OmarNeazyI/Sunnypro-automated-egg-frying-machine/docs/README.md

# Document index

The PDFs below preserve the original report pages, tables, diagrams, and printed page numbers. Page ranges refer to the full report's one-based PDF page positions. Unnecessary student identifiers and PDF author metadata have been removed from public copies; technical content and attribution are retained.

| Document | Original report pages | Pages in PDF |
|---|---|---|
| [Project requirements](requirements/SunnyPro_Requirements.pdf) | 27 | 1 |
| [Functional structure and workflow](system-design/SunnyPro_Functional_Structure_and_Workflow.pdf) | 54-66 | 13 |
| [Functional calculations - selected team report pages](calculations/SunnyPro_Functional_Calculations.pdf) | 67-75, 82-86, 111-125 | 29 |
| [Material selection and manufacturing technologies](manufacturing/SunnyPro_Materials_and_Manufacturing.pdf) | 162-206 | 45 |
| [Purchased component requirements](components/SunnyPro_Purchased_Component_Requirements.pdf) | 207-226 | 20 |
| [Final bill of materials](bom/SunnyPro_Final_BOM.pdf) | 241-254 | 14 |
| [Assembly drawing item key](drawings/SunnyPro_Assembly_Drawing_BOM.pdf) | 229-230 | 2 |
| [Team D-FMEA - supporting contribution](risk/SunnyPro_Team_DFMEA.pdf) | 96-108 | 13 |
| [Technical assembly drawing](drawings/SunnyPro_Assembly_Drawing.pdf) | 228 | 1 |
| [Full team report](reports/SunnyPro_Full_Project_Report.pdf) | 1-302 | 302 |

## How to read the documentation

Start with the project requirements and the functional structure. Use the mechanical design notes to follow the component and drive choices, then consult the materials/manufacturing document, final BOM, assembly drawing, and drawing item key.

- [System design notes](system-design.md)
- [Mechanical design and calculation notes](mechanical-design.md)
- [Materials and manufacturing notes](materials-and-manufacturing.md)
- [Design status and limitations](design-status.md)
- [Contributions](contributions.md)

## Ownership and source context

The full report is a team submission. The D-FMEA was primarily my teammates' work, with my contribution. The functional-calculations excerpt includes contextual team calculations, including process preparation assumptions; it is not a claim that I authored every retained calculation.

The assembly drawing is also present on full-report page 228. Its standalone PDF has matching text and page dimensions, with only minor raster differences consistent with compression.

The original functional diagram is sideways in the report. Its page is rotated for reading in the topic excerpt only, without recreating or changing its diagram. The sideways D-FMEA table pages are also rotated in their topic PDF; the full report retains its original page orientations.
