OmarNeazyI/Sunnypro-automated-egg-frying-machine/assets/images/README.md

# Original project images

These are the original, full-resolution SolidWorks screenshots, renamed consistently for linking. Their pixels, proportions, and component details have not been changed. The README controls display size only; selecting an image opens its original resolution.

| Image | Original filename |
|---|---|
| [Complete machine assembly](machine-overview.png) | image(20261110-172844).png |
| [Machine with enclosure panels hidden](machine-internal-layout.png) | image(20261110-172912).png |
| [Conveyor and motor assembly](conveyor-and-drive.png) | image(20261110-172957).png |
| [Eggshell drawer with rails retracted](eggshell-drawer-closed.png) | image(20261110-173113).png |
| [Eggshell drawer with rails extended](eggshell-drawer-open.png) | image(20261110-173149).png |
| [Rotating serving platform](rotating-platform.png) | image(20261110-173321).png |
| [Side view of rotating platform](rotating-platform-side.png) | image(20261110-173352).png |
| [End view of top infrared heater shield](top-ir-shield-end.png) | image(20261110-173451).png |
| [Top infrared heater shield assembly](top-ir-shield.png) | image(20261110-173517).png |
| [Bottom heating block and supporting frame](bottom-heating-assembly.png) | image(20261110-173613).png |
| [Rear display casing and adjustable mounting assembly](display-mount-rear.png) | image(20261110-173726).png |
| [Display casing](display-casing.png) | image(20261110-173754).png |

No image has been generated or substituted. No separate oil-tank screenshot was included.
