OmarNeazyI/Sunnypro-automated-egg-frying-machine/docs/application-summary.md

# Application summary

## CV entry

SunnyPro - automated egg-frying machine | University product-development project

- Developed SolidWorks assemblies for the conveyor, rotating serving platform, heating systems, eggshell drawer, oil tank, and display housing.
- Selected subsystem components, performed functional calculations, chose materials and manufacturing methods, and prepared the final BOM and technical assembly drawings.
- Created the functional structure block diagram and operating-workflow explanation; contributed to heating calculations and the team's D-FMEA.

Design project; no physical prototype was manufactured or tested.

## Short project description

I worked on a university team project to develop an automated sunny-side-up egg-frying machine for breakfast service. My main contribution combined mechanical CAD with component selection, functional calculations, material and manufacturing choices, the final BOM, and technical assembly drawings. I also created the functional structure and full workflow explanation. The project remained at the design stage.
