OmarNeazyI/Sunnypro-automated-egg-frying-machine/assets/images/rotating-platform-side.png

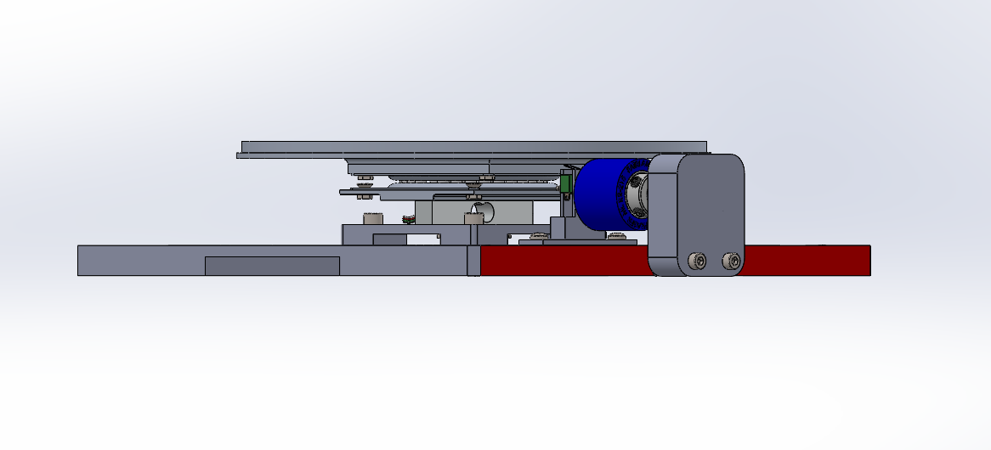
assets/images/rotating-platform-side.png
