OmarNeazyI/Sunnypro-automated-egg-frying-machine/assets/images/top-ir-shield-end.png

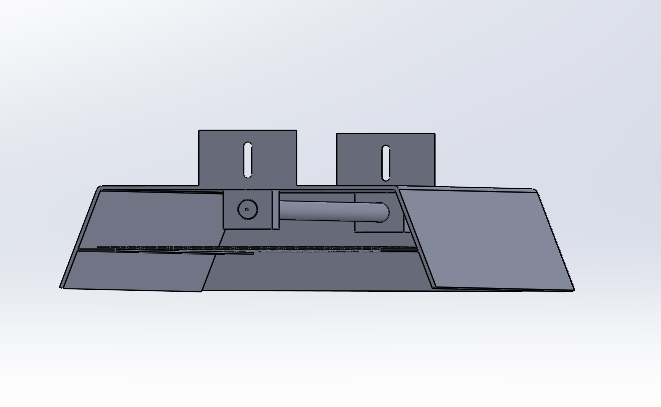
assets/images/top-ir-shield-end.png
