OmarNeazyI/Sunnypro-automated-egg-frying-machine/docs/bom/SunnyPro_Final_BOM.pdf

Group 3 | HSRW Group Project T&B | SS 2026

## 14. Bill of Materials (BOM)

Part NO. | Part Name (Make) | Material specification | Qty. | Technical Specification | Position in Technical assembly
1 | Egg Storage Container | PP-C HI / Polypropylen e Copolymer | 1 | Yield: ~22 MPa | Density: 0.90 g/cm³ | Temp: -20 to 100°C | 1
2 | Egg Tunnel | PP-C HI / Polypropylen e Copolymer | 1 | Yield: ~22 MPa | Density: 0.90 g/cm³ | Temp: -20 to 100°C | 2
3 | Gates for Transportation Tunnel | Acetal Copolymer (POM-C) | 2 | Yield: ~62 MPa | Density: 1.41 g/cm³ | Temp: -40 to 100°C | 4
4 | Gate Shaft Holder for Tunnel | POM-C / Acetal Copolymer | 2 | Yield: ~62 MPa | Density: 1.41 g/cm³ | Temp: -40 to 100°C | 5
5 | Egg Tunnel Shaft | EN 1.4301 / AISI 304 | 2 | Yield: ~215 MPa | Density: 7.90 g/cm³ | Temp: -200 to 400°C | 6
6 | Egg Holding Shaft | EN AW-6082 T6 | 1 | Yield: ~260 MPa | Density: 2.70 g/cm³ | Temp: -40 to 150°C | 7
7 | Egg Holding Arm | EN AW-6082 T6 | 1 | Yield: ~260 MPa | Density: 2.70 g/cm³ | Temp: -40 to 150°C | 8
8 | Base of Spear | EN AW-6082 T6 (clear anodised) | 1 | Yield: ~260 MPa | Density: 2.70 g/cm³ | Temp: -40 to 150°C | 9

9 | Spears (Left and Right) | EN 1.4116 / X50CrMoV15 (hardened) | 2 | Yield: ~800–1000 MPa | Density: 7.70 g/cm³ | Temp: -20 to 200°C | 10
10 | Solenoid Motor Mounting Bracket | EN 1.4301 / AISI 304 | 2 | Yield: ~215 MPa | Density: 7.90 g/cm³ | Temp: -200 to 400°C | 11
11 | Solenoid Motor Casing | EN AW-6082 T6 (clear anodised) | 3 | Yield: ~260 MPa | Density: 2.70 g/cm³ | Temp: -40 to 150°C | 12
12 | Main Drawer Box | EN 1.4301 / X5CrNi18-10 | 1 | Yield: ~215 MPa | Density: 7.90 g/cm³ | Temp: -200 to 400°C | 13
13 | Drawer Front Cover | ABS-HI plastic | 1 | Yield: ~40 MPa | Density: 1.05 g/cm³ | Temp: -20 to 80°C | 14
14 | Drawer Handle | ABS-HI plastic w/ brass inserts | 1 | Yield: ~40 MPa | Density: 1.05 g/cm³ | Temp: -20 to 80°C | 15
15 | Inner Shaft (Drawer) | EN 1.4301 / X5CrNi18-10 | 2 | Yield: ~215 MPa | Density: 7.90 g/cm³ | Temp: -200 to 400°C | 16
16 | Manual Compression Plate | EN 1.4301 / X5CrNi18-10 | 1 | Yield: ~215 MPa | Density: 7.90 g/cm³ | Temp: -200 to 400°C | 17
17 | Oil Storage Mount | EN AW-6082 T6 | 2 | Yield: ~260 MPa | Density: 2.70 g/cm³ | Temp: -40 to 150°C | 18
18 | Pocket Plate | EN 1.4409 / GX2CrNiMo1 9-11-2 (cast) | 4 | Yield: ~185–205 MPa | Density: 7.90 g/cm³ | Temp: -196 to 400°C | 19

19 | Sprocket for Conveyor Belt | EN 1.4404 / X2CrNiMo17-12-2 | 4 | Yield: ~205 MPa | Density: 8.00 g/cm³ | Temp: -196 to 400°C | 20
20 | Driving Shaft / Idler Shaft | EN 1.4404 / X2CrNiMo17-12-2 | 2 | Yield: ~205 MPa | Density: 8.00 g/cm³ | Temp: -196 to 400°C | 21
21 | Conveyor Side Frame | EN 1.4301 / X5CrNi18-10 | 2 | Yield: ~215 MPa | Density: 7.90 g/cm³ | Temp: -200 to 400°C | 22
22 | Conveyor Back Frame | EN 1.4301 / X5CrNi18-10 | 1 | Yield: ~215 MPa | Density: 7.90 g/cm³ | Temp: -200 to 400°C | 23
23 | Conveyor Belt Hollow Support Frame | EN AW-6082 T6 | 1 | Yield: ~260 MPa | Density: 2.70 g/cm³ | Temp: -40 to 150°C | 24
24 | Nema 17/Gearbox/E ncoder Motor Housing | EN AC-43500 / AlSi10MnMg (cast) | 1 | Yield: ~140–180 MPa | Density: 2.68 g/cm³ | Temp: -40 to 150°C | 25
25 | Nema Motor Mount | EN 1.4301 / AISI 304 | 1 | Yield: ~215 MPa | Density: 7.90 g/cm³ | Temp: -200 to 400°C | 26
26 | TOP IR Shielding | EN 1.4301 / X5CrNi18-10 | 1 | Yield: ~215 MPa | Density: 7.90 g/cm³ | Temp: -200 to 400°C (shield, near IR zone) | 27
27 | Ceramic Block for Holding Quartz IR | 96% Al₂O₃ ceramic | 2 | Flexural: ~300 MPa | Density: 3.70 g/cm³ | Temp: up to 1600°C | 28
28 | Side Lining for TOP IR | EN 1.4301 / X5CrNi18-10 | 2 | Yield: ~215 MPa | Density: 7.90 g/cm³ | Temp: -200 to 400°C | 29

29 | Perforated Sheet | EN 1.4301 / X5CrNi18-10 | 1 | Yield: ~215 MPa | Density: 7.90 g/cm³ | Temp: -200 to 400°C | 30
30 | TOP IR Back Frame | EN 1.4301 / X5CrNi18-10 | 1 | Yield: ~215 MPa | Density: 7.90 g/cm³ | Temp: -200 to 400°C | 31
31 | Heating Block | EN AW-6082 T651 | 1 | Yield: ~250 MPa | Density: 2.70 g/cm³ | Temp: -40 to 200°C | 32
32 | Side Frame (Bottom Heating) | EN 1.4301 / X5CrNi18-10 | 2 | Yield: ~215 MPa | Density: 7.90 g/cm³ | Temp: -200 to 400°C | 33
33 | Front Frame (Bottom Heating) | EN 1.4301 / X5CrNi18-10 | 2 | Yield: ~215 MPa | Density: 7.90 g/cm³ | Temp: -200 to 400°C | 34
34 | Bottom Frame (Bottom Heating) | EN 1.4301 / X5CrNi18-10 | 1 | Yield: ~215 MPa | Density: 7.90 g/cm³ | Temp: -200 to 400°C | 35
35 | Mounting Brackets for Bottom Heating Block | EN 1.4301 / AISI 304 | 4 | Yield: ~215 MPa | Density: 7.90 g/cm³ | Temp: -200 to 400°C | 36
36 | Aluminum Plate (Rotating Plate) | EN AW-6061 T6 (clear anodised) | 1 | Yield: ~275 MPa | Density: 2.70 g/cm³ | Temp: -40 to 150°C | 37

37 | Top Load Cell Plate | EN AW-6061 T6 (clear anodised) | 1 | Yield: ~275 MPa | Density: 2.70 g/cm³ | Temp: -40 to 150°C | 38
38 | Bottom Load Cell Plate | EN AW-6082 T6 (clear anodised) | 1 | Yield: ~260 MPa | Density: 2.70 g/cm³ | Temp: -40 to 150°C | 39
39 | Base Plate (Rotating Plate) | EN AW-6082 T6 (clear anodised) | 1 | Yield: ~260 MPa | Density: 2.70 g/cm³ | Temp: -40 to 150°C | 40
40 | Stepper Motor Housing | EN AC-43500 / AlSi10MnMg (cast, clear anodised) | 1 | Yield: ~140–180 MPa | Density: 2.68 g/cm³ | Temp: -40 to 150°C | 41
41 | Bottom Base for Rotating Plate | EN 1.4301 / AISI 304 | 1 | Yield: ~215 MPa | Density: 7.90 g/cm³ | Temp: -200 to 400°C | 42
42 | Electrical Box Housing | EN 1.4301 / AISI 304 | 1 | Yield: ~215 MPa | Density: 7.90 g/cm³ | Temp: -200 to 400°C | 43
43 | Main Frame Housing | EN 1.4301 / AISI 304 | 1 | Yield: ~215 MPa | Density: 7.90 g/cm³ | Temp: -200 to 400°C | 44

44 | L Bracket for Servo Motor | EN 1.4301 / AISI 304 | 4 | Yield: ~215 MPa | Density: 7.90 g/cm³ | Temp: -200 to 400°C | 45
45 | Plastic Back Plate (Display) | ABS-HI plastic w/ brass inserts | 1 | Yield: ~40 MPa | Density: 1.05 g/cm³ | Temp: -20 to 80°C | 46
46 | Front Frame for Casing (Display) | ABS-HI plastic | 1 | Yield: ~40 MPa | Density: 1.05 g/cm³ | Temp: -20 to 80°C | 47
47 | Main Case/Chassy Panels | ABS-HI plastic + purchased glass | 1 | Yield: ~40 MPa | Density: 1.05 g/cm³ | Temp: -20 to 80°C | 48
Part NO. | Part Name (buy) | Material specificatio n | Link/Brand | Technical Specification | Position in Technical assembly
48 | DIN Rail | zinc-plated steel | Hutschiene TS 35 x 7,5mm gelocht - L=326mm (https://www.heima24.de/fussbodenheizung/hutschiene-ts-35-x-75-mm-gelocht-stahl-verzinkt-laenge-326-mm.html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) | 35 x 7,5 x 326 mm | 49
49 | Cable Duct / Wire Raceway | PVC | Cable duct (https://www.reichelt.de/de/de/shop/produkt/verdrahtungskanal_25x25_mm_1000_mm-338223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) | 25x25x1000mm | NA
50 | Cable Glands / Strain Reliefs | Polyamide, V-2. | Kabelverschraubung, M 12 x 1,5, Ø 3,5 - 7 mm, schwarz, IP69K Kabelverschraubung, M 16 x 1,5, Ø 4,5 - 10 mm, schwarz, IP69K (https://www.reichelt.de/de/de/shop/produkt/kabelverschraubung_m_12_x_1_5_3_5_-_7_mm_schwarz_ip69k-158616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) M 20 x 1,5, Ø 7 - 13 mm, schwarz, IP69K (https://www.reichelt.de/de/de/shop/produkt/kabelverschraubung_m_20_x_1_5_7_-_13_mm_schwarz_ip69k-158618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) | M12x1.5 IP69k M16x1.5 IP69k M20x1.5 IP69K | NA
51 | Cable Ties + Mounts | 6/6 nylon | Cable mounts (https://www.digikey.de/de/products/detail/3m/CTB75X75BKA-C/12091625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) Cable ties (https://www.digikey.de/de/products/detail/3m/CT06220/2721199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) | 18.8mm x 18.8mm x 5.6mm | NA

52 | Axle Shaft | Aluminum | Aluminum shaft (https://www.aluminiumexperte.de/alu-rundstab-10-mm.html?gad_source=1&gad_campaignid=23561472869) | Ø 10 mm x100 mm | 50
53 | Return Spring | Stainless steel - AISI 302 | Spring (https://www.sodemann-federn.de/c03000380810s?gad_source=1&gad_campaignid=20972617853) | L0 - 20.57 Mm De - 7.62 | NA
54 | Thermal Insulation | LDPE | Thermal insulation (https://www.planenscout.de/top/schaumstoffe/plastazote-pe-schaumstoff.html?xf_no=34236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) | -70°C to105°C 500x330x20mm | NA
55 | Inner Lining | Aluminum | Aluminum sheet (https://de.aliexpress.com/item/1005007155237666.html) | 0.1x100x100mm | NA
56 | Inline Check Valve | stainless steel | Duotight - 8mm Inline Check Valve (https://ikegger.eu/products/duotight-8mm-inline-check-valve?variant=46884903780646&country=DE&currency=EUR) | Ø8mm | NA
57 | Silicone Tubing | Silicon | Silicon tubing (https://www.puraplants.de/Luftschlauch-4-6mm-durchsichtig-lfm-fuer-Airdome-Sprudelsteine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) | 4mm x 1m | NA
58 | Flat Fan Spray Nozzle | stainless steel | CDIYTOOL 8 Pieces 65 Degree High Pressure Spray Nozzle (https://www.amazon.de/-/en/CDIYTOOL-Pressure-Underbody-Cleaner-Connector/dp/B0C6MNS19L) | 0.4-5L/min 14mm hex width, 25mm long, 12.5 thread width | NA
59 | Nozzle Mounting Bracket | | | | NA
60 | Roller Chain with Bent Attachments | Steel | IWIS - Rollenkette EuroChain (https://www.z24.de/a/41706-iwis-rollenkette-eurochain-06b?ausfuehrung=1&quantity=1) | 9,525 mm 5,72 mm 1505mm 06B-2 | NA
61 | 2-Bolt Flange Bearing Block | Aluminum | Stehlagereinheiten / Flanschlagereinheiten 2- Loch KFL000 (https://www.123kugellager.de/kugellager-gehauselager/gehauselager/stehlagereinheiten-flanschlagereinheiten-2loch/kfl000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) | Ø 10mm | 51
62 | Flexible Clamp Motor Coupling | Aluminum | 10 mm to 12 mm Flexible Shaft Coupling, Diameter 40 mm Length 66 mm Aluminium Motor Connector Flexible (https://www.amazon.de/Flexible-Wellenkupplung-Durchmesser-Aluminium-Motorverbinder/dp/B0DPQ9PPJH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) | bore diameter 10 mm to 12 mm total diameter 40 mm length 66mm | NA

63 | Planetary Gearbox for Motor | -- | Planetengetriebe Schrittmotor 27:1 (https://www.oyostepper.de/goods-293-NEMA-17-Planetengetriebe-Schrittmotor-27-1-Nema17-26Ncm-0067-Grad-168A-12V-Getriebe-Schrittmotor.html) | Planetarygear 27:1 | 52
64 | Front Sealing Strip / Gap Cove r | Silicon | EKI 1515 Silikonschaum (https://www.ekibv.de/moosgummi/silikonschaum/eki1515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) | 2mmx6mmx10m -60 °C bis +220 °C | NA
65 | Thermal Compound | -- | Wärmeleitpaste, Tube, 35gr, ungiftig (https://www.reichelt.de/de/de/shop/produkt/waermeleitpaste_tube_35gr_ungiftig-244621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) | 35g | NA
48 | Stainless Fasteners Kit | A2 stainless steel | M2 M3 M4 M5 Schrauben Set – 1280 Stück (https://www.voelkner.de/index.php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) | M2 M3 M4 M5 | NA

Miscellanous
67 | Countersunk Raised Head Cross Recess Screw | A2 Stainless Steel | Senkkopfschrauben M10x25 (https://agbox.online/Schrauben/Senkkopf/Senkkopfschrauben-DIN-7991/Senkkopfschrauben-M10x25-mit-Innensechskant-DIN-7991-Edelstahl-A2) Senkkopfschrauben M10x60 (https://agbox.online/Schrauben/Senkkopf/Senkkopfschrauben-DIN-7991/Senkkopfschrauben-M10x60-mit-Innensechskant-DIN-7991-Edelstahl-A2) | M10x25 M10x60 | 53
68 | Pan Head Cross | A2 Stainless steel | Linsenschrauben M8x16 (https://alleschrauben.de/Schrauben/Linsenkopf/Linsenschrauben-DIN-7985/Innensechsrund-TX/Linsenschrauben-M8x16-mit-Innensechsrund-TX-T40-DIN-7985-Edelstahl-A2) STM390400300S (https://de.screwerk.com/de/shop/detail/stm/STM390400300S.html) STM320300200E (https://de.screwerk.com/de/shop/detail/stm/STM320300200E.html) | DIN 7985 (ISO 7045) M8x16 M4x30 M3x20 | 54
69 | Recess Screw | A2 stainless steel | Zylinderschraube Innensechskant DIN912 (ISO 4762) V2A - M6x20, 100 St. (https://www.cnc-zubehoer.eu/Zylinderschraube-Innensechskant-DIN912-ISO-4762-V2A-M6x20-100-St./S.912.V2A.M6x20-100) Zylinderschraube Innensechskant DIN912 (ISO 4762) V2A - M3x12, 100 St. (https://www.cnc-zubehoer.eu/Zylinderschraube-Innensechskant-DIN912-ISO-4762-V2A-M3x12-100-St./S.912.V2A.M3x12-100) | M6x20 M3x12 | 55
70 | Socket Head Cap Screw | A2 stainless steel | DIN 912/ISO 4762 A2 – M3 x 25 mm 100 Stück (https://shop.der-schraubenladen.de/DIN-912-ISO-4762-Zylinderschraube-Innensechskant-Edelstahl-A2/SW11250.78) DIN 912/ISO 4762 A2 – M3 x 10 mm 100 Stück (https://shop.der-schraubenladen.de/DIN-912-ISO-4762-Zylinderschraube-Innensechskant-Edelstahl-A2/SW11250.71) | M3x25 M3 x 10 mm | 56

71 | Pan Head Cross Recess Screw | Stainless steel | Flachkopfschraube ISO 7045 PZ M4x8-Z 4.8 galv.verz. 2000St. (https://shop.perfekter-halt.de/Flachkopfschraube-ISO-7045-PZ-M-4-x-8-Z-4-8-galv-verz--2000St---item-REYHER_VL_NW_8000209114) | ISO 7045 M4x8 M4 x 8mm | NA
72 | Prevailing Torque Hex Nut | A2 Stainless steel | Sechskantmuttern M6 DIN 934 Edelstahl A2 (https://alleschrauben.de/Muttern/Sechskantmuttern/Sechskantmuttern-DIN-934/Sechskantmuttern-M6-DIN-934-Edelstahl-A2) | M6 | 57
73 | Plain Washer | A2 Stainless steel | Unterlegscheibe DIN125 (ISO 7089) V2A - 6,4 mm (M6), 1000 Stück (https://www.cnc-zubehoer.eu/Unterlegscheibe-DIN125-ISO-7089-V2A-6-4-mm-M6-1000-Stueck/S.125.A2.M6-1000) | M6 | 58
74 | Socket Set Screw, Cup Point | A2 Stainless Steel | Gewindestift DIN 916 / ISO 4029, M 5x20, Stahl 45 H (https://www.landefeld.de/artikel/de/gewindestift-din-916-iso-4029-m-5x20-stahl-45-h/916-M5X20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..) | M5x20 | 59
75 | Hex Thin Nut | A2 Stainless Steel | DIN 439/ISO 4035 Sechskantmutter Edelstahl A2 – M3 - 100 Stück (https://shop.der-schraubenladen.de/DIN-439-ISO-4035-Sechskantmutter-Edelstahl-A2/SW12301.11) DIN 439/ISO 4035 Sechskantmutter Edelstahl A2 – M4 - 100 Stück (https://shop.der-schraubenladen.de/DIN-439-ISO-4035-Sechskantmutter-Titan-Grade-5/SW12553.1) | M3 M4 | 60
76 | Lazy Susan Bearing | Stainless Steel | Blickle 942239 DK-L-3 Stahlblech-Drehkranz 1 St. (https://www.conrad.de/de/p/blickle-942239-dk-l-3-stahlblech-drehkranz-1-st-3051254.html?insert=ID) | 140 x 110 mm | 61
77 | Rubber Drive Wheel | Polyoxymet hylene | Freies Verschiffen 10PCS 8*32*16 flache typ PA nylon (https://de.aliexpress.com/item/32361362232.html?scm_id=1007.40050.354490.0&scm-url=1007.40050.354490.0) | 8x32x16mm | 62

Electrical Parts

Part No. | Part name | Brand/link | Technical specifications | Location in technical assembly
78 | IEC C20 Power Inlet | IEC 20 Power Inlet (https://de.farnell.com/en-DE/bulgin/px0596-63/inlet-iec-c20-screw-fix/dp/4286030) | 16 A 250 VAC | 63
79 | MCB-Circuit Breaker | 16A MCB- TYPE B Circuit Breaker (https://intratec-shop.de/en/miniature-circuit-breaker-mcb-16a-type-b-3-pole-400v-effective-protection-1-piece/RI53EB16) | 16A TYPE B | NA
80 | RCCB / RCD-TYPE A | RCCB / RCD-TYPE A (30mA) (https://www.tandmore.de/Installation/Hager/FI-LS-Schalter/Hager-CDA540D-2P-10kA-40A-30mA-Typ-A-Fehlerstromschutzschalter::410509.html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) | 30mA TYPE A | NA
81 | DIN Terminal Blocks | DIN Terminal Blocks (L/N/PE) (https://www.tandmore.de/Installation/Phoenix-Contact/Phoenix-Contact-3213755-PT-1-5-S-PE-L-N-Schutzleiter-Reihenklemme::562607.html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) | (L/N/PE) | NA
82 | Protective Earth Terminal Block | Protective Earth Terminal Block (https://www.elektro-wandelt.de/?cl=details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) | - | NA
83 | AC Wire | LAPP 70261141 Strom Anschlusskabel Schwarz 3.00 m (https://www.conrad.de/de/p/lapp-70261141-strom-anschlusskabel-schwarz-3-00-m-626131.html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) | 3.00 m | NA
84 | 24V Industrial SMPS | 24V Industrial SMPS 60W (2.5A at 24V) (https://www.netzgeraet.de/Hutschienennetzteile/DIN-Schiene-24V-DC/1212/24V-2-5A-Netzteil-60W-fuer-Hutschiene-DIN-Rail-HDR.html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) | 60W (2.5A at 24V) | NA
85 | 24V → 12V LM2596T-12 | LM2596T-12/LF03 (https://www.mouser.de/ProductDetail/Texas-Instruments/LM2596T-12-LF03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) | 4.5V to 40V 3A Low | NA
86 | 12V → 5V LM2596T-5 | LM2596T-5.0/LF03 (https://www.mouser.de/ProductDetail/Texas-Instruments/LM2596T-5.0-LF03?qs=X1J7HmVL2ZG6KM98hB9zGA%3D%3D) | 4.5V to 40V 3A Low | NA
87 | 24V → 6V LM2596S-ADJ (Adjusted to 6V) | LM2596S-ADJ/NOPB (https://www.mouser.de/ProductDetail/Texas-Instruments/LM2596S-ADJ-NOPB?qs=X1J7HmVL2ZHoMN0DLDcNog%3D%3D) | 24V DC to 6V DC, 2A continuous | NA
89 | 5V → 3.3V Regulator AMS1117-3.3 | LM1117MPX-3.3/NOPB (https://www.mouser.de/ProductDetail/Texas-Instruments/LM1117MPX-3.3-NOPB?qs=X1J7HmVL2ZHRbBIxXi4utg%3D%3D) | 5 mA 3.3 V -40 to 125 C | NA
90 | DC Terminal Blocks | 9-Way DC Terminal Block 5V 12V 24V for CCTV Power Supply (https://de.aliexpress.com/item/1005003721195254.html?src=bing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) | 5V 12V 24V DC 9-way | NA
91 | Inline Blade Fuse Holders | URAQT Fuse Holder Car Standard 16AWG (https://www.amazon.de/dp/B0FXMT9BYD?aref=hiLIRQMU4S&sp_csd=d2lkZ2V0TmFtZT1zcF9kZXRhaWw) | 16AWG/14AWG/12AWG 30/20/10A | NA

92 | Blade Fuse Assortment | 0287010.PXCN Littelfuse Inc. | Fuses | DigiKey (https://www.digikey.com/en/products/detail/littelfuse-inc/0287010-PXCN/2519807) | 10A 32V | NA
93 | Shielded Signal Cable | 2M UL2547 28AWG 4 Cores PVC (https://de.aliexpress.com/item/32997998517.html?src=bing-language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) | 81–600 V 4-core | NA
94 | Ferrules and Crimp Terminals | 1-966066-1 : Crimp Wire Pins, Tabs & Ferrules | TE Connectivity (https://www.te.com/en/product-1-966066-1.html) | 15 AWG | NA
95 | PCB Screw Terminal Connectors | 20Paar 5.08mm Pitch Male Buchse PCB Screw Terminal Block | eBay.de (https://www.ebay.de/itm/157335503128?campid=5338690632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) | 25 x 10 x 15mm AC 300V 15A | 64
96 | Axial fan 8414NGML | EBM Papst 8414NGML Axiallüfter 24 V/DC 42 m³/h (L x B x H) 80 x 80 x 25mm | » Freue dich auf voelkner (https://www.voelkner.de/index.php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) | 80x80x25mm 42 m³ /h 2pcs 24V DC | 65
97 | Main Microcontroller STM32H743ZITx | STM32H743ZIT6 STMICROELECTRONICS, ARM-MCU, STM32 Family (https://de.farnell.com/stmicroelectronics/stm32h743zit6/mcu-arm-cortex-m7-400mhz-lqfp/dp/2820778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) | STM32 3.6V 550MHz | NA
98 | Gate Actuators JF-0530B x3 | JF-0530B DC12V 300mA 5N/10mm Pull-Push-Type Solenoid Electromagnet (https://www.icstation.com/0530b-dc12v-300ma-5n10mm-pull-push-type-solenoid-electromagnet-p-7404.html) | DC 12V 300mA 5N/10mm 30x16x15mm | 66
99 | Flow Sensors IR sensor | IR Break Beam Sensors- 3mm LEDs : Adafruit Industries (https://www.adafruit.com/product/2167) | 3.3 - 5.5VDC 10mA @ 3.3V, 20mA @ 5V Response Time: <2 ms | NA
100 | Flip Actuator MG996R | MG996R Digital Servo Motor mit Metall Getriebe (https://www.roboter-bausatz.de/p/mg996r-digital-servo-motor-mit-metall-getriebe) | 0.17 sec/60 deg at 4.8 V 4.8 to 7.2 V 40 x 19 x 43 mm | 67
101 | Platform Solenoid JF-0837B | JF-0837B DC 24V 1A 15N 10mm Push Pull Type Open Frame Linear Motion Solenoid Electromagnet | Harfington (https://www.harfington.com/products/p-1109643) | DC 24V 1A 15N 37 x 20 x 26mm | 68

102 | Solenoid Driver multi-channel MOSFET | Industrial-Grade MOSFET Driver Module – 10-100A Adjustable PWM Controller (12-60V DC) (https://de.aliexpress.com/item/1005008688455909.html?src=bing-language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) | 12–60 V DC 10–100 A 12 x 13 x 1 cm | NA
103 | Peristaltic Pump | DC 12V Dosing Pump Peristaltic Pump (https://de.aliexpress.com/item/1005006671106432.html?src=bing-language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) | DC12V 11ml/min Three roller | 69
104 | MOSFET Driver Module | Mosfet Mosfet 12V DC 8×6×2 Low Voltage Mosfet Module (https://www.amazon.de/Niederspannungs-Mosfet-Modul-Steuerung-Hochspannung-Feldeffekttransistormodul-Mosfet-Modul/dp/B0D1GLR547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) | 12V DC 1-5MA | NA
105 | Touchscreen Display Module — Nextion NX8048P070_01 1R | NEXTION 4.3/5.0/7.0'' Intelligent LCD Touch Display (https://de.aliexpress.com/item/1005007260050419.html?src=bing-language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) | 108x181x9.3mm | 70
106 | JST-XH 4-pin Connector | JST JST - Buchsengehäuse, 1x4-polig - XH (https://www.reichelt.de/de/de/shop/produkt/jst_-_buchsengehaeuse_1x4-polig_-_xh-185087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) | 250V / 3A -25 to 80C | NA
107 | Stepper Motor | NEMA 17 (https://www.conrad.de/de/p/joy-it-schrittmotor-nema17-02-nema17-02-0-4-nm-1-68-a-wellen-durchmesser-5-mm-1665583.html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) | 2.8 V 5 mm 2 phase | 71
108 | Stepper Motor Driver | Stepper Motor Driver (https://de.aliexpress.com/item/1005006273853216.html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) | -40 to +85°C 12/24V 18 x 25 x 3 cm | NA
109 | Control Wiring and Connectors | Control Wiring and Connectors (https://de.aliexpress.com/item/1005012316315765.html?src=google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) | 26AWG L-100 mm | NA
110 | Hall Effect Sensor | A1104-class Hall effect switch sensor, 3-pin type (https://www.mouser.de/ProductDetail/Allegro-MicroSystems/A1104LUA-T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) | 3.8 V to 24 V 25 mA -40 to 150 °C | NA
111 | SmCo Magnet | SmCo (https://www.indiamart.com/proddetail/8-x-3-mm-smco-magnet-2858539106433.html) | 8 x 3 mm | NA
110 | Incremental Rotary Encoder | AMT102-V (https://www.digikey.de/de/products/detail/same-sky-formerly-cui-devices/amt102-v/827015) | 3,6V to 5,5V | 72

111 | Cartridge Heaters | Cartridge Heaters (https://www.sensorshop24.de/heizelemente/heizpatronen-8-0-mm/heizpatrone-8mmx160mm-mit-250watt-230v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) | 250W 230V (AC) | 73
112 | Temperature Sensor | PT100 temp. Sensor (https://de.aliexpress.com/item/1005012305522172.html) | - | 74
113 | Temperature Sensor Amplifier | MAX31865AAP+ Analog Devices DigiKey (https://www.digikey.de/de/products/detail/analog-devices-inc-maxim-integrated/MAX31865AAP/5396622) | 3V to 3,6V -40°C to125°C | NA
114 | Solid-state Relay | solid state relay 25A SSR-25AA , ZG3NC-325A Single phase (https://de.aliexpress.com/item/32869114119.html?curPageLogUid=hqPH00OkWdRT) | 25A 90–480VAC | 75
115 | Heater Branch Fuse | 0652C8000-11 Bel Fuse Inc. | Sicherungen | DigiKey (https://www.digikey.de/de/products/detail/bel-fuse-inc/0652C8000-11/25021650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) | 8 A (https://www.digikey.de/de/products/filter/sicherungen/8-a/139) 250 V | NA
116 | High-temperature Wiring | Silikonkabel 18 AWG 0,5 mm² 200°C 300V flexibel verzinnt Meterware | akkuteile.de (https://www.akkuteile.de/zubehoer/kabel-litzen/silikonkabel-18-awg-0-5-mm-200-c-300v-flexibel-verzinnt-meterware_400521_3899) | 18 AWG 200°C 600V | NA
117 | Grounding Hardware | 100m Erdkabel H07V-K 1x4mm² Grün/Gelb bei hd-digital kaufen, (https://www.hb-digital.de/flexible-4mm2-grounding-cable-h07v-k-pvc-single-core-greenyellow-pv-systems-meter) | AC Uo/U 450/750 V > 20 MΩ × km -30 °C to +80 °C | NA
118 | IR Heater Element | IR HEATER (https://yinfrared.en.made-in-china.com/product/IdsGRwybpvkW/China-110V-250-400W-310mm-370mm-410mm-Heating-Element-for-Electric-Oven-Electric-Heat-Tube-with-Me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) | 410 mm 250W 110V to 450V | 76
119 | IR Power Control / Relay | SSR Halbleiter Solid State Relais DC / AC, 230V AC 25 A (https://www.pohltechnik.com/de/ssr-relais/ssr-lastschaltung-230v/ssr-halbleiter-solid-state-relais-dc-ac-230v-ac-25-a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) | DC to AC 230V AC 25A | NA
120 | Thermal Cutoff / Safety Sensor | THERMODISC Temperatursicherung, 16A, 184°C, kurz/lang | Temperatursicherungen günstig kaufen | reichelt elektronik (https://www.reichelt.de/de/de/shop/produkt/temperatursicherung_16a_184_c_kurz_lang-279146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) | 16A Max 184°C | NA
121 | PT100 Sensor | PT100 temp. Sensor (https://de.aliexpress.com/item/1005012305522172.html) | - | 77
122 | SSR Heat Sink | Aluminium Heat Sink SSR (https://www.amazon.de/-/en/Aluminium-Dissipation-Thermostat-Temperature-Controller/dp/B0DX2CCWC7?s=industrial) | Aluminium | 78

| | Dissipation For One Phase Solid State Relay 10a-40a For PID Thermostat Temperature Controller (https://www.amazon.de/-/en/Aluminium-Dissipation-Thermostat-Temperature-Controller/dp/B0DX2CCWC7?s=industrial) | Fit for: 10a-40a
123 | Ceramic Terminal Block | Elektrofachmarkt-online -Keramikklemme 2-polig mit Befestigungsloch (https://www.elektrofachmarkt-online.de/kabel-u-zubehoer/verbindungsklemmen/luesterklemmen/keramikklemme-2-polig-mit-befestigungsloch.html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) | Ceramic clamp 2-pole max. 300°C , 450V, 32A | NA
124 | Low-voltage Terminal Blocks | Phoenix Contact 1725672 MPT 0,5/ 4-2,54 Leiterpla (https://www.tandmore.de/Installation/Phoenix-Contact/Phoenix-Contact-1725672-MPT-0-5-4-2-54-Leiterplatten-Anschlussklemme::577079.html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) | 160 V Max 105 °C 4 cores | NA
125 | Stepper Motor | FREI Standard-Schrittmotor, 5V (https://www.reichelt.de/de/de/shop/produkt/standard-schrittmotor_5_v-282442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) | 5V DC 4 Phase 34.3mN.m | NA
126 | Stepper Driver Module | FREI Entwicklerboards -Motorsteuerung, ULN2003A (https://www.reichelt.de/de/de/shop/produkt/entwicklerboards_-_motorsteuerung_uln2003a-282649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) | DC5V-12V 4-phase 5 line | NA
127 | Microswitch | 5Pcs Mini Micro Limit Switch NO NC 3 Pins PCB Terminals SPDT 5A 125V 250V 29mm Roller Arc lever Snap Action Push Microswitches (https://de.aliexpress.com/item/1926553469.html?src=bing-language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) | 5A 125V/250V | NA
128 | Load Cell and HX711 Amplifier Module | Stemedu 5 kg Load Cell Digital Weight Sensor for Portable Electronic with HX711 Ad Amplifier Module, 11 lbs Weighing Sensor Arduino Raspberry Pi (https://www.amazon.de/dp/B07L81BQB6/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) | Four lines 5-10 V Dimensions: 12.7 mm, 12.7 mm, 80 mm. voltage range: 2.6-5.5 V | NA

129

130 | Wiring and Connectors | DKS-20MM-30 DigiKey Standard | Jumper Wire | DigiKey (https://www.digikey.com/en/products/detail/digikey-standard/DKS-20MM-30/17038779) PVC Datenleitung LAPP UNITRONIC LiYY 3x0,25 - 0028303 | Automation24 (https://www.automation24.de/pvc-datenleitung-lapp-unitronic-liyy-3x0-25-0028303-meterware-0-25-3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) | - NA
131 | Emergency stop button | 1NC 22mm Red Mushroom Emergency Stop Push Button Switch 600V 10A (https://de.aliexpress.com/item/1005006921918648.html?src=bing-language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) | 22mm 600V 10A | NA
