OmarNeazyI/Sunnypro-automated-egg-frying-machine/cad/native/Breaking Hand Assembly.SLDASM

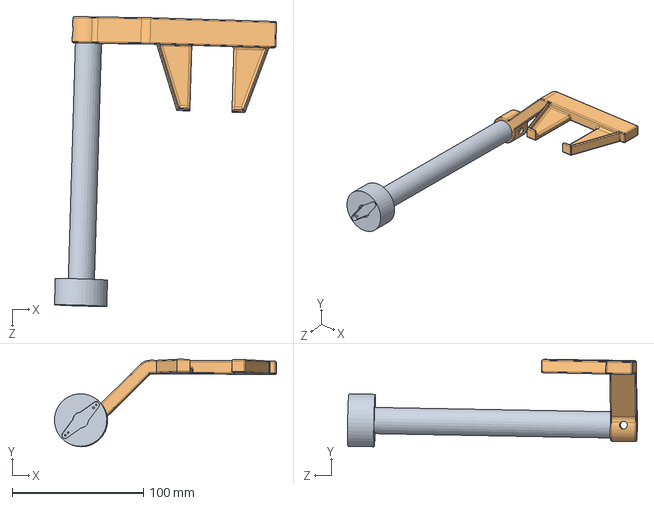
[picture p136: CAD file, 2026-11-10]
cad/native/Breaking Hand Assembly.SLDASM
169.2 x 66.7 x 221.0 mm
Breaking Mech Hand
Shaft for Hand
