OmarNeazyI/Sunnypro-automated-egg-frying-machine/cad/native/TOP IR Parts Assembly.SLDASM

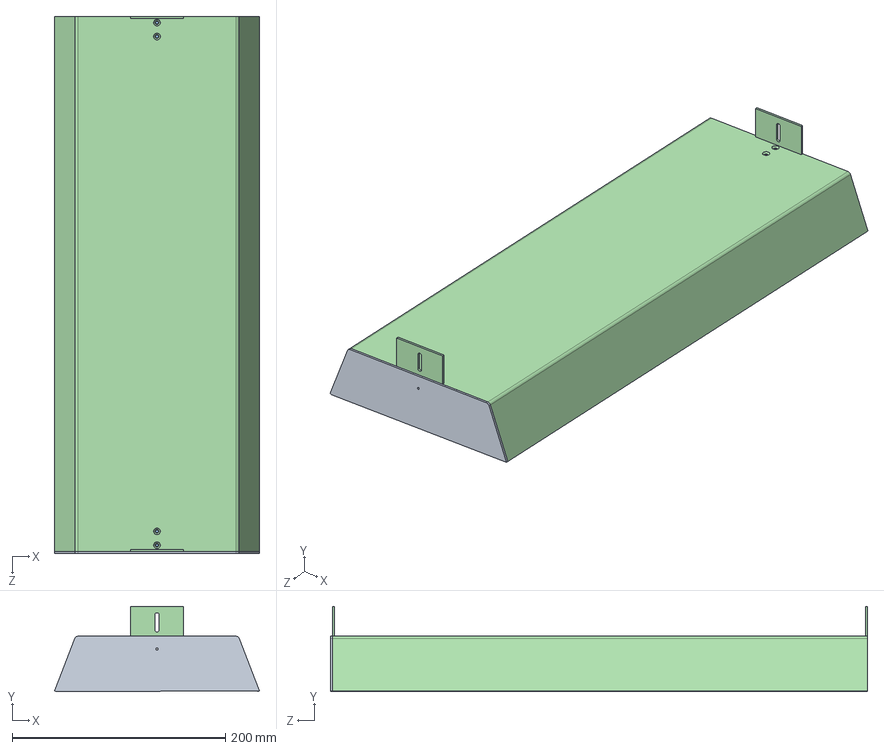
[picture p137: CAD file, 2026-11-10]
cad/native/TOP IR Parts Assembly.SLDASM
192.2 x 80.0 x 504.0 mm
TOP IR shielding
Ceramic block x 2
Lining for mesh x 2
Back of shielding
