OmarNeazyI/Sunnypro-automated-egg-frying-machine/cad/native/Main Base Plate.SLDPRT

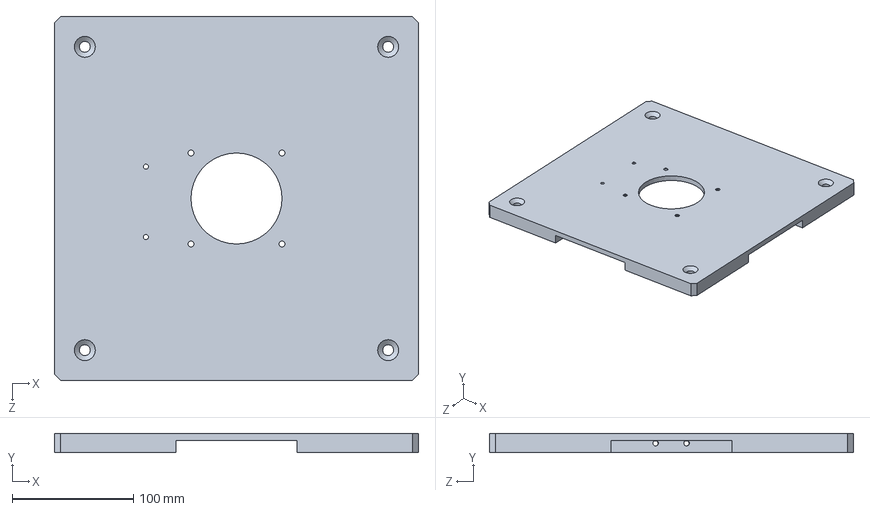
[picture p138: CAD file, 2026-11-10]
cad/native/Main Base Plate.SLDPRT
300.0 x 16.0 x 300.0 mm
