OmarNeazyI/Sunnypro-automated-egg-frying-machine/cad/native/Chain linkwithpins.SLDASM

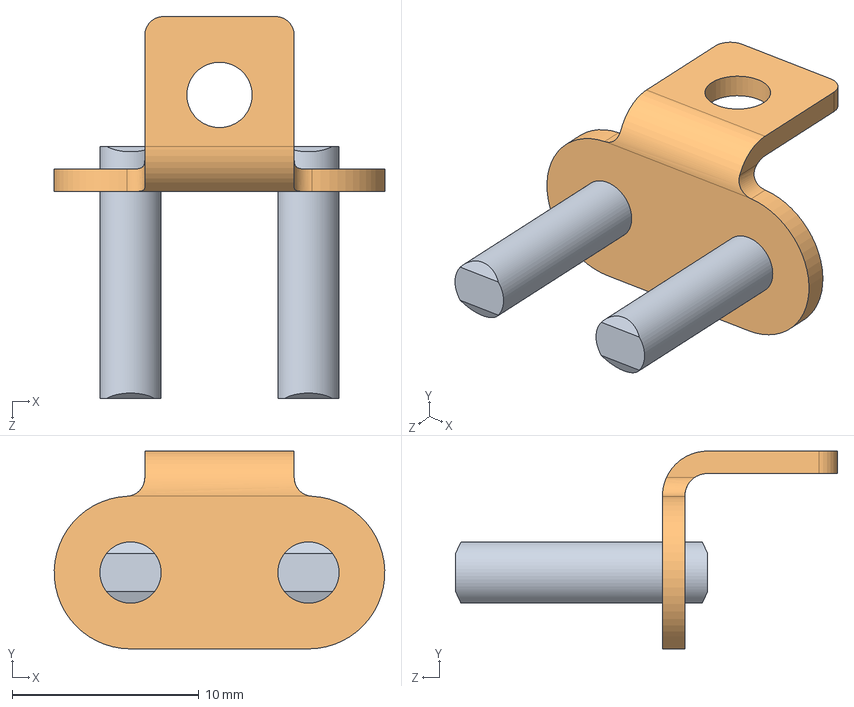
[picture p139: CAD file, 2026-11-10]
cad/native/Chain linkwithpins.SLDASM
17.7 x 10.6 x 20.4 mm
V10V9V7V6V510100001_01
V10V9V7V6V510100001_03 x 2
