OmarNeazyI/Sunnypro-automated-egg-frying-machine/cad/native/Main Steel Frame.SLDPRT

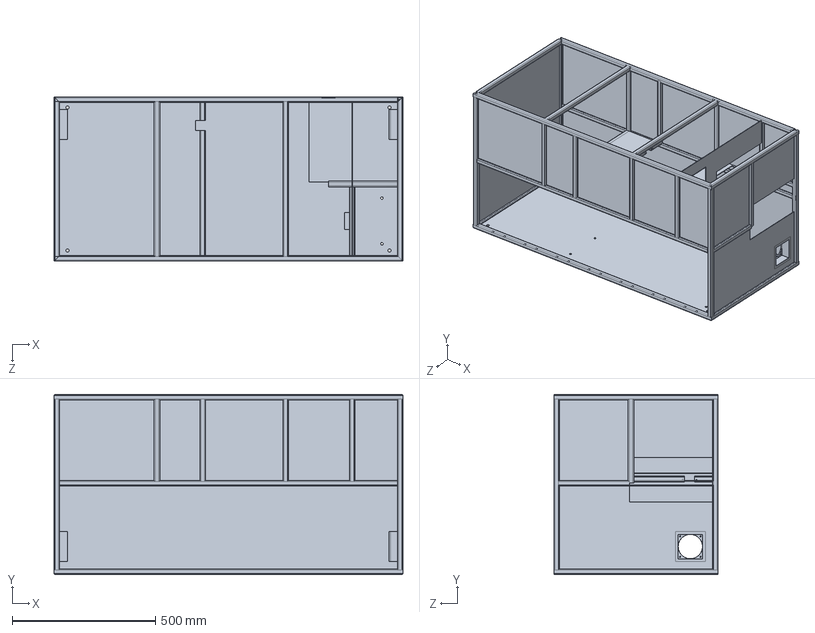
[picture p140: CAD file, 2026-11-10]
cad/native/Main Steel Frame.SLDPRT
1220.0 x 629.3 x 575.0 mm
