OmarNeazyI/Sunnypro-automated-egg-frying-machine/cad/native/V10V9Main Relay Body.SLDPRT

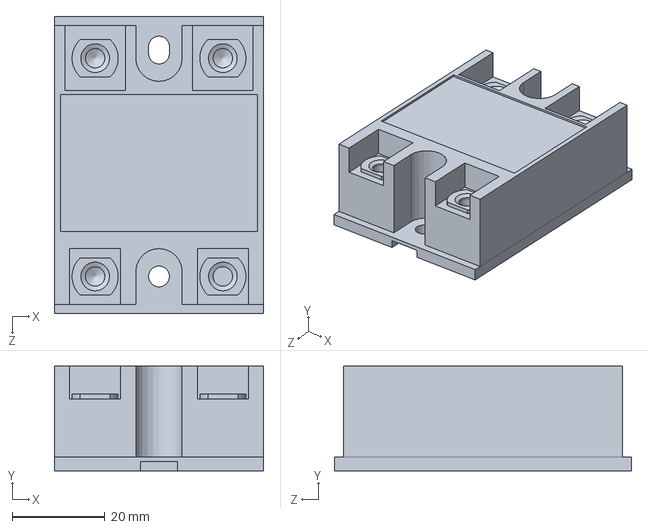
[picture p141: CAD file, 2026-11-10]
cad/native/V10V9Main Relay Body.SLDPRT
45.0 x 22.5 x 64.0 mm
