OmarNeazyI/Sunnypro-automated-egg-frying-machine/cad/native/Rubber Wheel Assembly.SLDASM

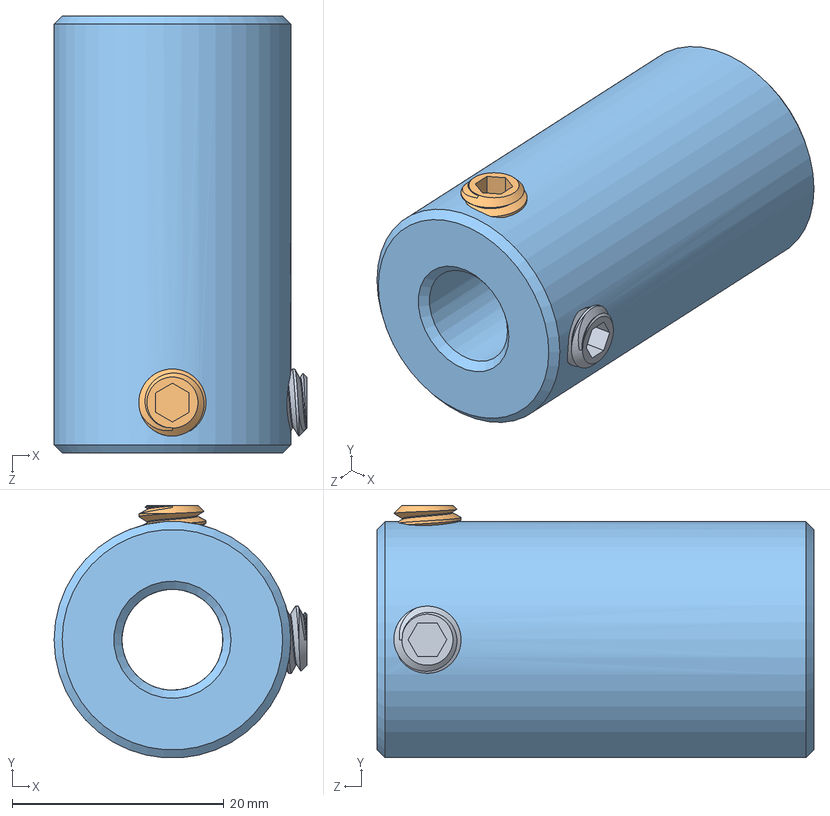
[picture p142: CAD file, 2026-11-10]
cad/native/Rubber Wheel Assembly.SLDASM
23.9 x 23.8 x 41.3 mm
V10V9V7V6V5rr-215-60ur-ex375_01V4
V10V9V7V6V5rr-215-60ur-ex375_04V4
V10V9V7V6V5rr-215-60ur-ex375_05V4
