OmarNeazyI/Sunnypro-automated-egg-frying-machine/cad/native/Shaft for Hand.SLDPRT

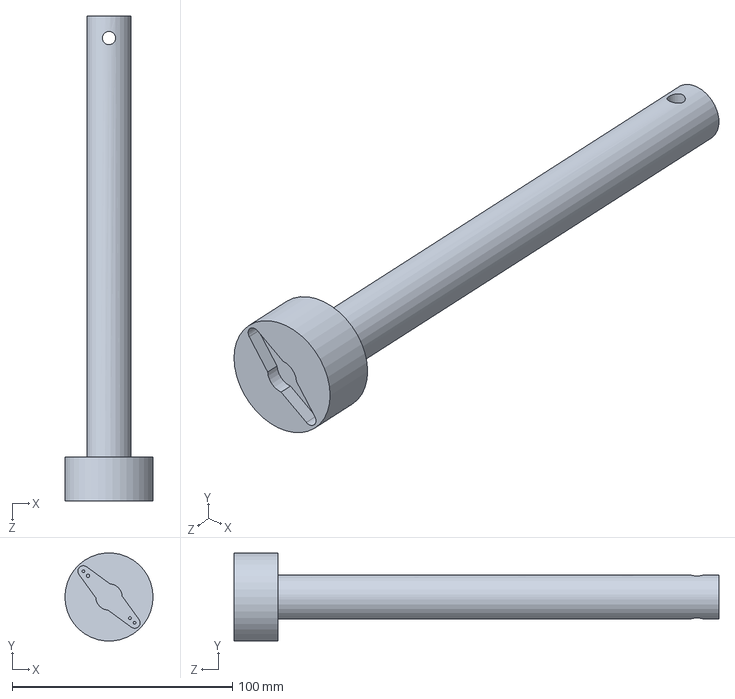
[picture p143: CAD file, 2026-11-10]
cad/native/Shaft for Hand.SLDPRT
40.0 x 39.9 x 220.0 mm
