OmarNeazyI/Sunnypro-automated-egg-frying-machine/cad/native/Plastic Front Panel with Glass.SLDPRT

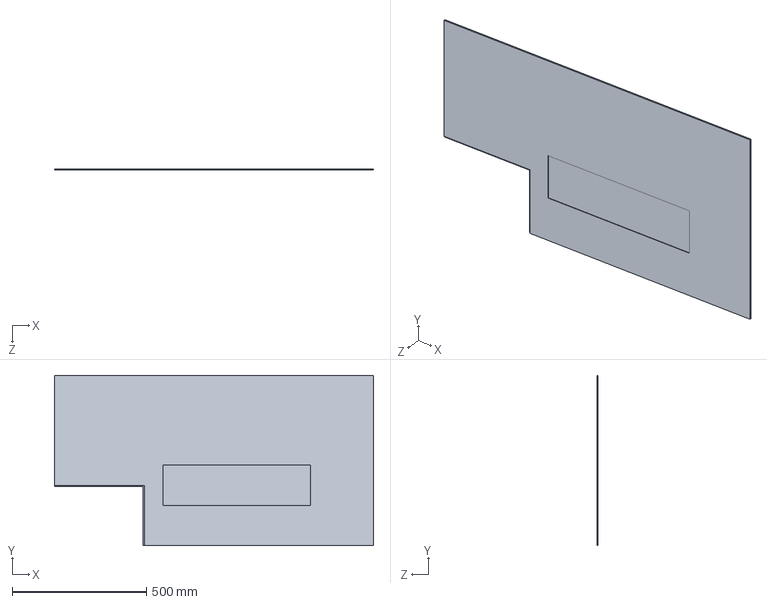
[picture p144: CAD file, 2026-11-10]
cad/native/Plastic Front Panel with Glass.SLDPRT
1190.0 x 635.0 x 5.00 mm
