OmarNeazyI/Sunnypro-automated-egg-frying-machine/cad/native/Top Plate for Load Cell.SLDPRT

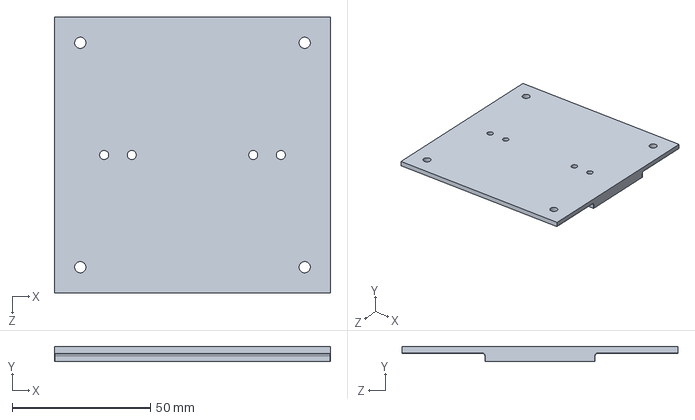
[picture p145: CAD file, 2026-11-10]
cad/native/Top Plate for Load Cell.SLDPRT
100.0 x 5.50 x 100.0 mm
