OmarNeazyI/Sunnypro-automated-egg-frying-machine/cad/native/Plastic Door for User.SLDPRT

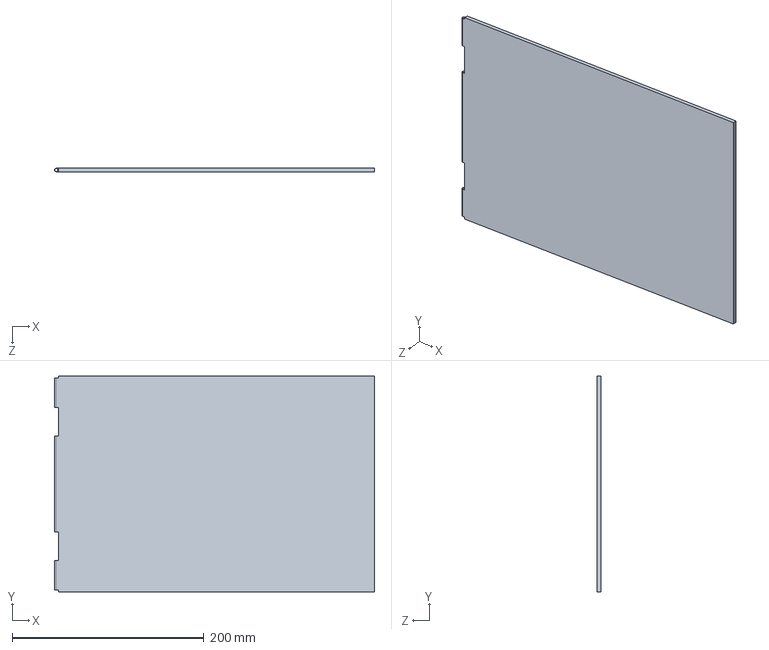
[picture p146: CAD file, 2026-11-10]
cad/native/Plastic Door for User.SLDPRT
334.0 x 225.0 x 4.00 mm
