OmarNeazyI/Sunnypro-automated-egg-frying-machine/cad/native/Lining for mesh.SLDPRT

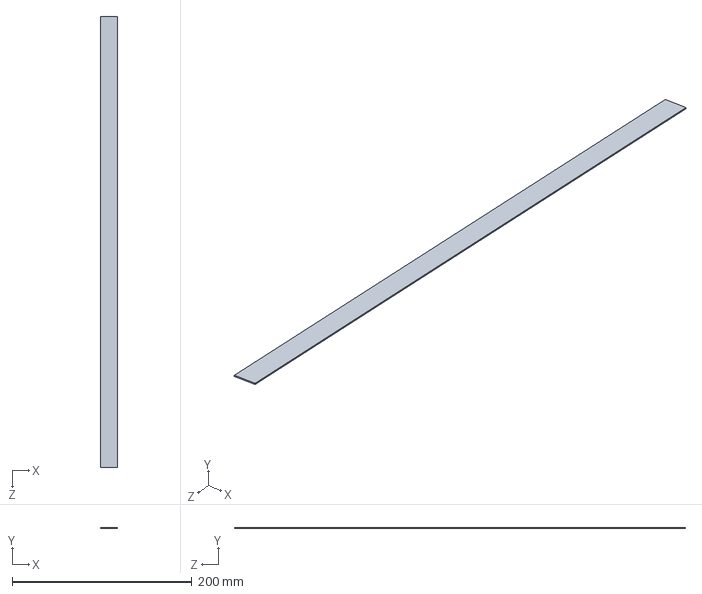
[picture p147: CAD file, 2026-11-10]
cad/native/Lining for mesh.SLDPRT
19.2 x 1.00 x 502.0 mm
