OmarNeazyI/Sunnypro-automated-egg-frying-machine/cad/native/V10V9V7V6V5HalfLazySusanV4.SLDPRT

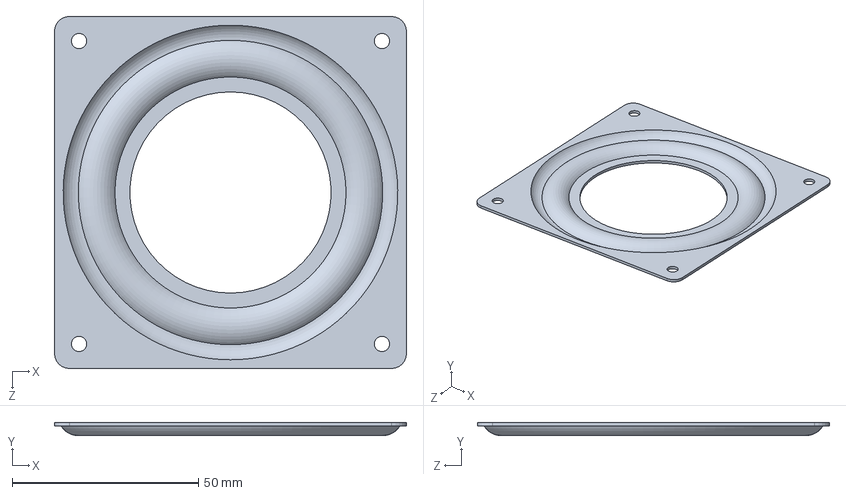
[picture p148: CAD file, 2026-11-10]
cad/native/V10V9V7V6V5HalfLazySusanV4.SLDPRT
94.5 x 3.57 x 94.5 mm
