OmarNeazyI/Sunnypro-automated-egg-frying-machine/cad/native/Compression Shield Sheet.SLDPRT

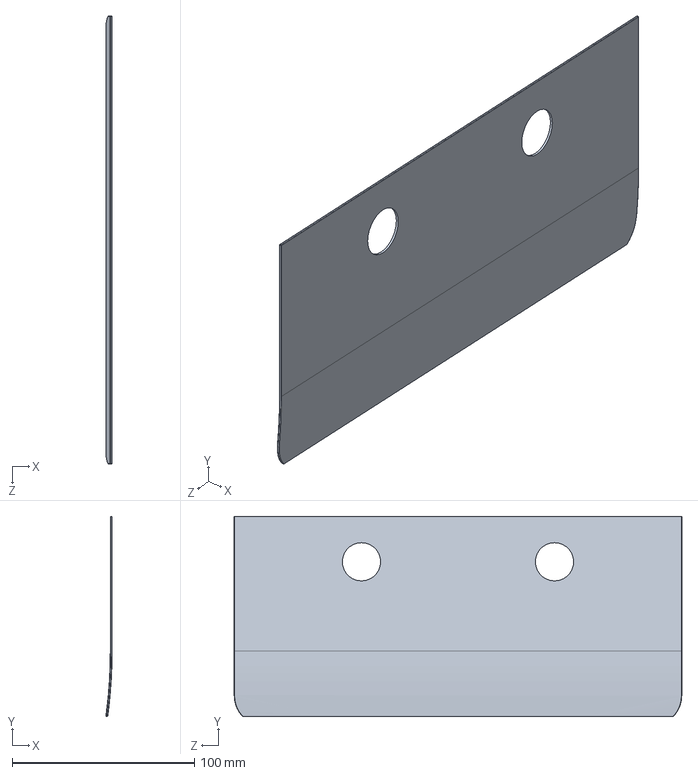
[picture p149: CAD file, 2026-11-10]
cad/native/Compression Shield Sheet.SLDPRT
3.41 x 110.1 x 246.0 mm
