OmarNeazyI/Sunnypro-automated-egg-frying-machine/cad/native/V10V9V7V6V5rr-215-60ur-ex375_01V4.SLDPRT

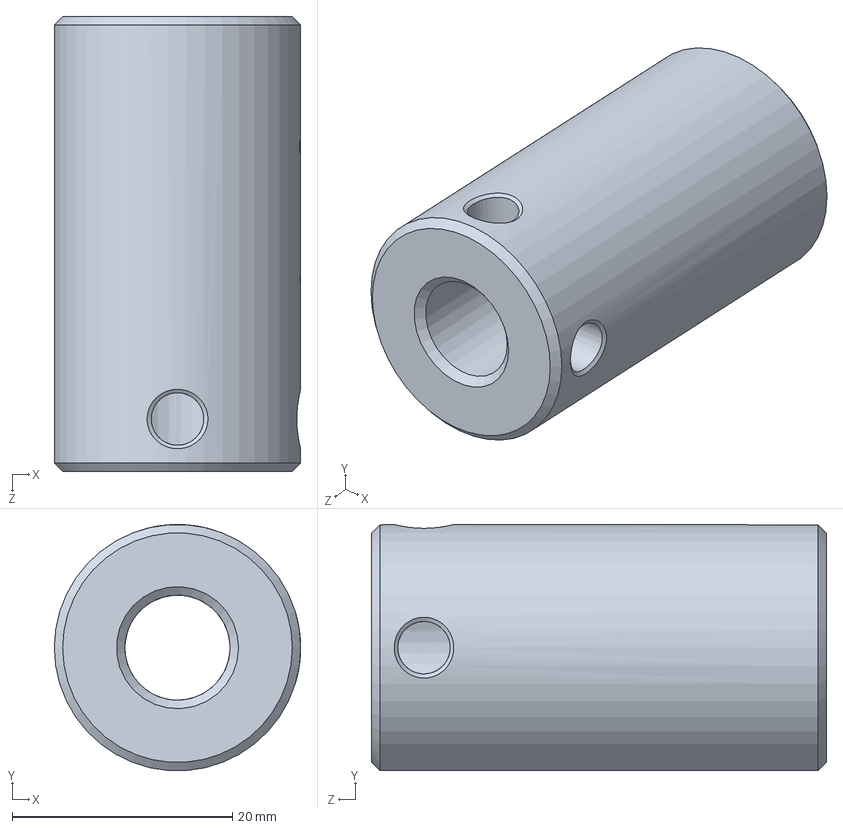
[picture p150: CAD file, 2026-11-10]
cad/native/V10V9V7V6V5rr-215-60ur-ex375_01V4.SLDPRT
22.4 x 22.3 x 41.3 mm
