OmarNeazyI/Sunnypro-automated-egg-frying-machine/cad/native/Rubber Wheel Shaft.SLDPRT

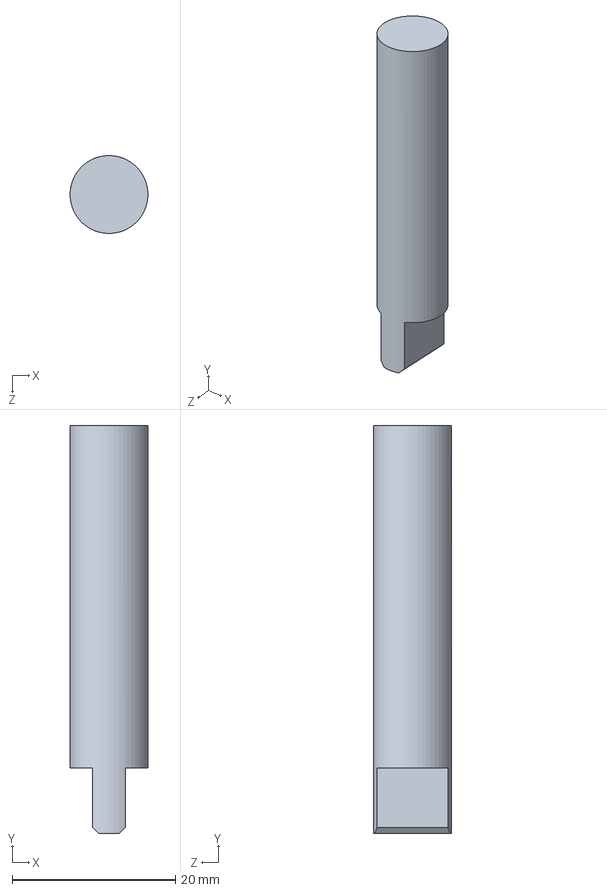
[picture p151: CAD file, 2026-11-10]
cad/native/Rubber Wheel Shaft.SLDPRT
9.55 x 50.0 x 9.55 mm
