OmarNeazyI/Sunnypro-automated-egg-frying-machine/cad/native/Conveyor Back Frame.SLDPRT

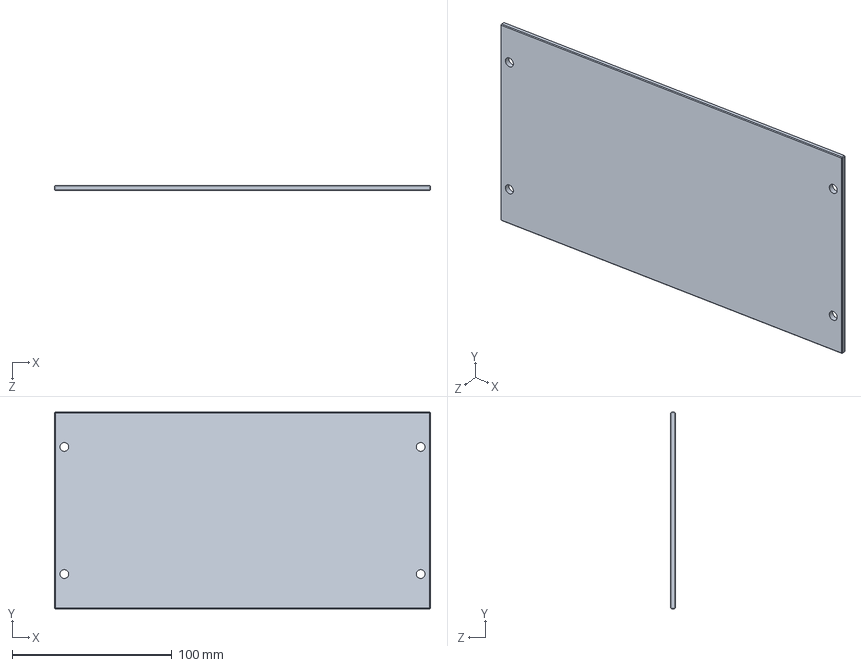
[picture p152: CAD file, 2026-11-10]
cad/native/Conveyor Back Frame.SLDPRT
235.1 x 123.0 x 3.00 mm
