OmarNeazyI/Sunnypro-automated-egg-frying-machine/cad/native/Shaft for Door.SLDPRT

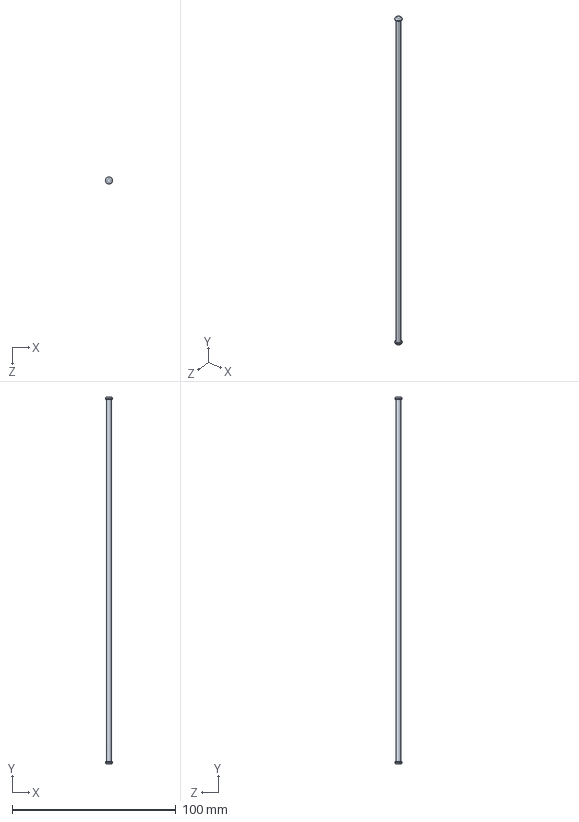
[picture p153: CAD file, 2026-11-10]
cad/native/Shaft for Door.SLDPRT
4.50 x 224.0 x 4.50 mm
