OmarNeazyI/Sunnypro-automated-egg-frying-machine/cad/native/Plastic Side Panel Right.SLDPRT

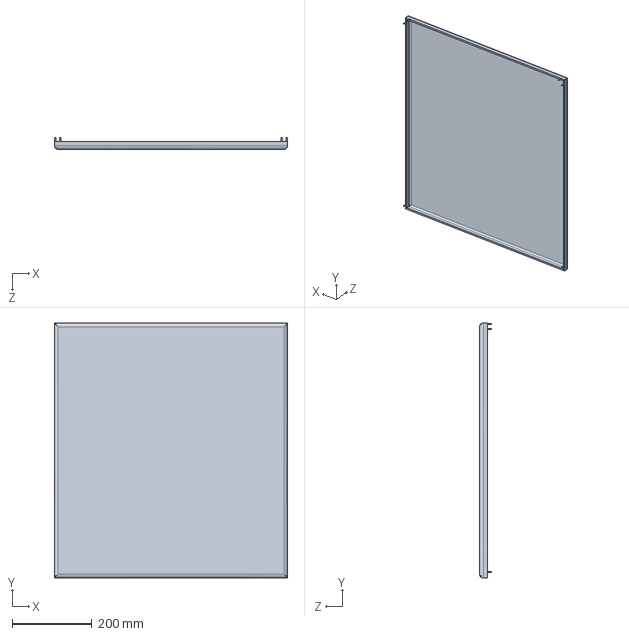
[picture p154: CAD file, 2026-11-10]
cad/native/Plastic Side Panel Right.SLDPRT
586.0 x 640.0 x 30.0 mm
