OmarNeazyI/Sunnypro-automated-egg-frying-machine/cad/native/V10V9V7V6V5stepper_am17hdb410-02n_02.SLDPRT

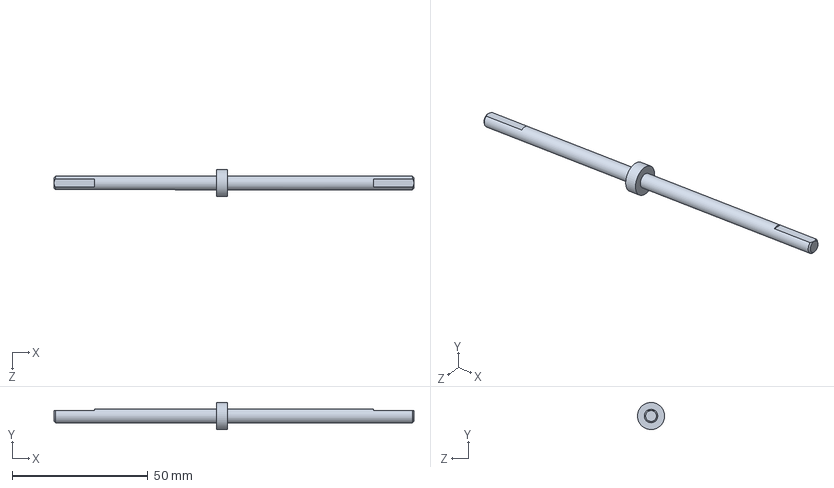
[picture p155: CAD file, 2026-11-10]
cad/native/V10V9V7V6V5stepper_am17hdb410-02n_02.SLDPRT
132.8 x 9.99 x 9.99 mm
