OmarNeazyI/Sunnypro-automated-egg-frying-machine/cad/native/V10V9V7V6V5Servo MG996R ShaftV4.SLDPRT

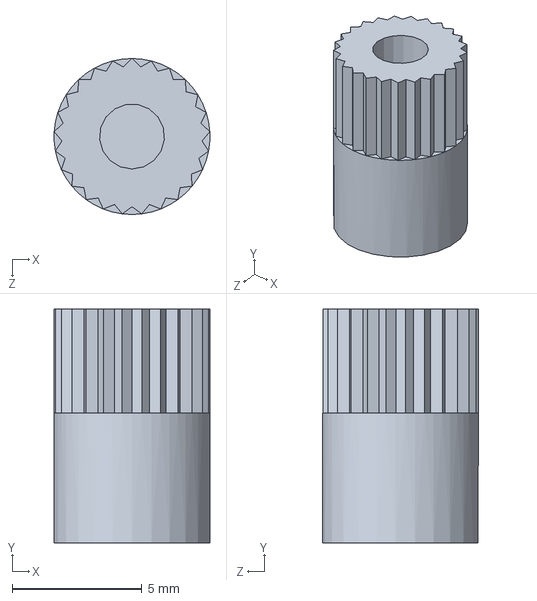
[picture p156: CAD file, 2026-11-10]
cad/native/V10V9V7V6V5Servo MG996R ShaftV4.SLDPRT
5.99 x 9.00 x 6.00 mm
