OmarNeazyI/Sunnypro-automated-egg-frying-machine/cad/native/Microswitch Mount.SLDPRT

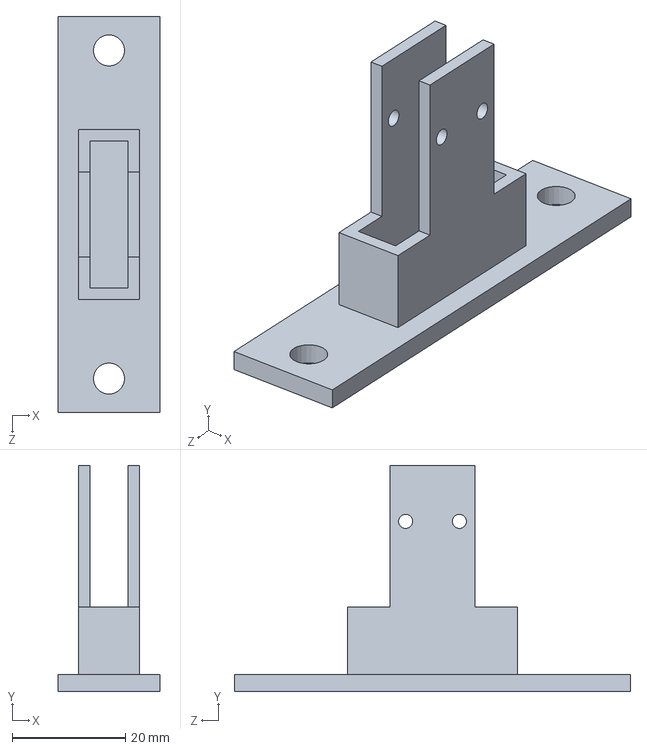
[picture p157: CAD file, 2026-11-10]
cad/native/Microswitch Mount.SLDPRT
18.0 x 40.0 x 70.0 mm
