OmarNeazyI/Sunnypro-automated-egg-frying-machine/cad/native/V10V9V7V6V5CoilV4.SLDPRT

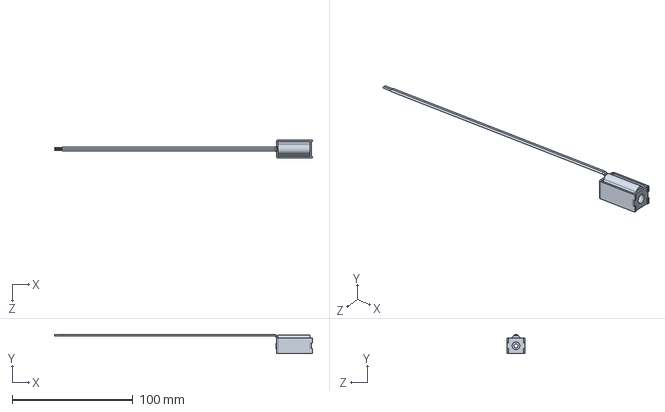
[picture p158: CAD file, 2026-11-10]
cad/native/V10V9V7V6V5CoilV4.SLDPRT
213.6 x 16.0 x 15.0 mm
