OmarNeazyI/Sunnypro-automated-egg-frying-machine/cad/native/TOP IR shielding.SLDPRT

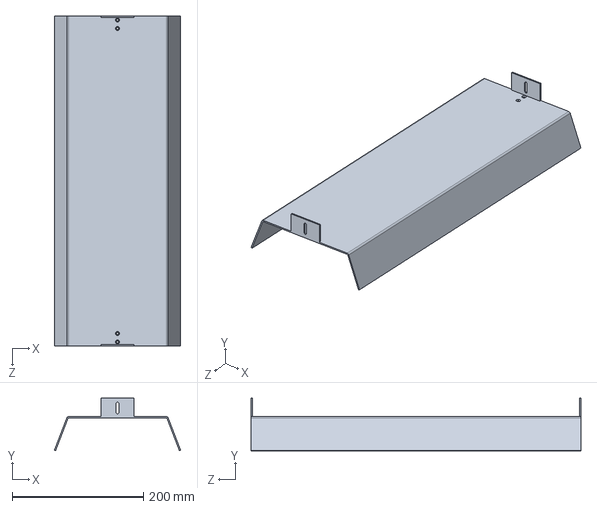
[picture p159: CAD file, 2026-11-10]
cad/native/TOP IR shielding.SLDPRT
192.2 x 80.0 x 502.0 mm
