OmarNeazyI/Sunnypro-automated-egg-frying-machine/cad/native/V10V9V7V6V510100001_03.SLDPRT

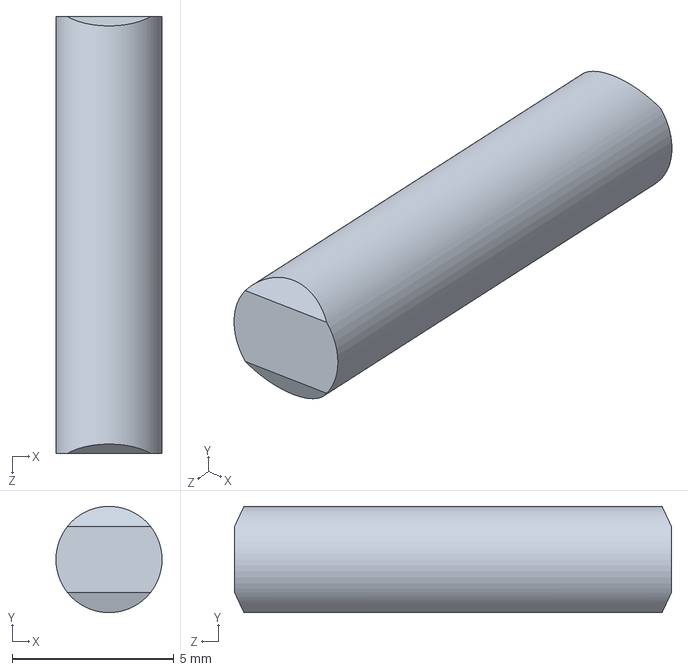
[picture p160: CAD file, 2026-11-10]
cad/native/V10V9V7V6V510100001_03.SLDPRT
3.28 x 3.28 x 13.5 mm
