OmarNeazyI/Sunnypro-automated-egg-frying-machine/cad/native/V10V9V7V6V5rr-215-60ur-ex375_05V4.SLDPRT

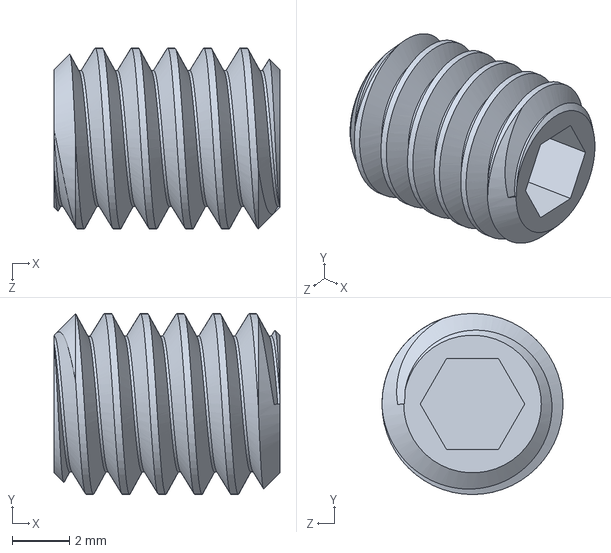
[picture p161: CAD file, 2026-11-10]
cad/native/V10V9V7V6V5rr-215-60ur-ex375_05V4.SLDPRT
7.92 x 6.35 x 6.35 mm
