OmarNeazyI/Sunnypro-automated-egg-frying-machine/cad/native/Nextion 7inch Display.SLDPRT

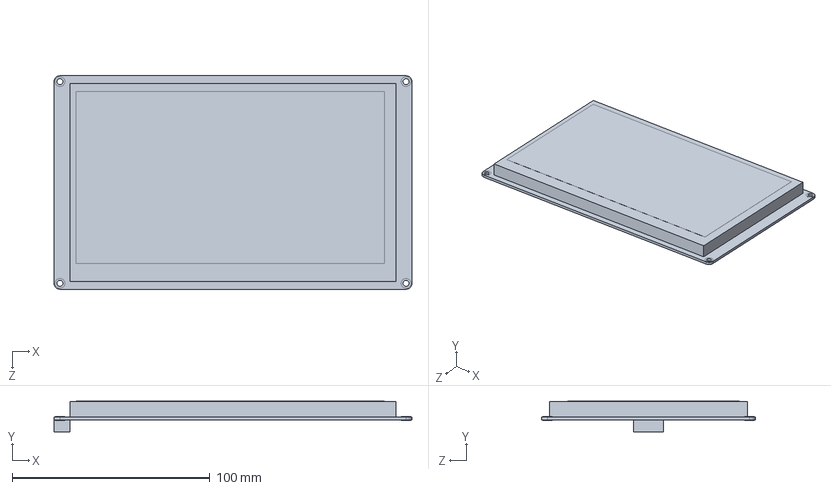
[picture p162: CAD file, 2026-11-10]
cad/native/Nextion 7inch Display.SLDPRT
181.0 x 15.6 x 108.0 mm
