OmarNeazyI/Sunnypro-automated-egg-frying-machine/cad/native/V10V9V7V6V528BYJ-48 bodyV4.SLDPRT

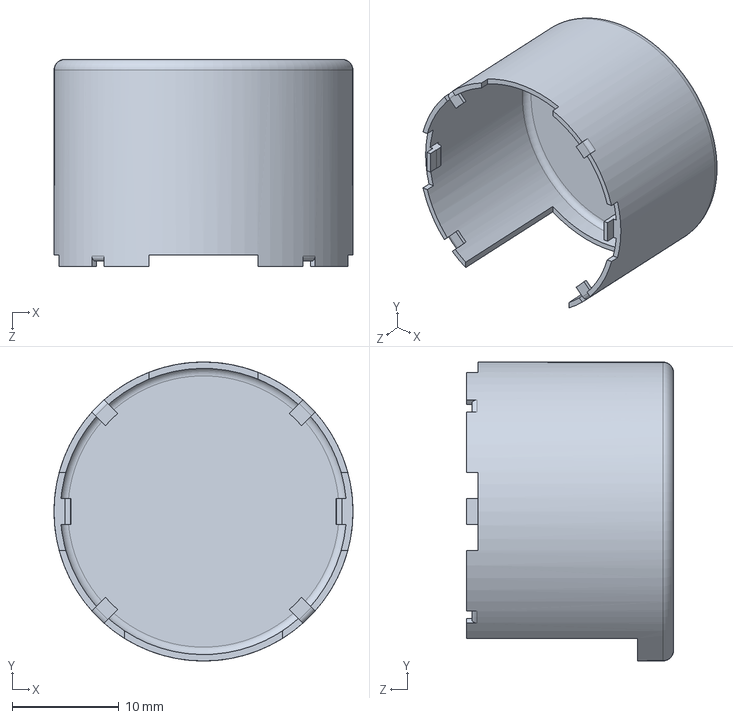
[picture p163: CAD file, 2026-11-10]
cad/native/V10V9V7V6V528BYJ-48 bodyV4.SLDPRT
28.0 x 28.0 x 19.4 mm
