OmarNeazyI/Sunnypro-automated-egg-frying-machine/cad/native/V10V9V7V6V5Copy of LeverV4.SLDPRT

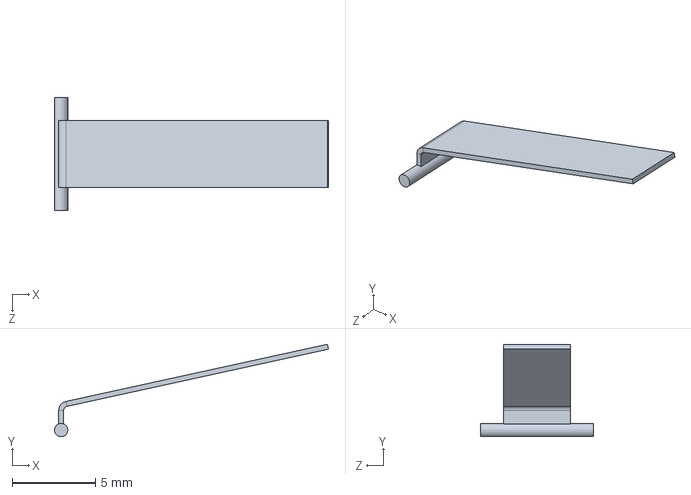
[picture p164: CAD file, 2026-11-10]
cad/native/V10V9V7V6V5Copy of LeverV4.SLDPRT
16.4 x 5.55 x 6.80 mm
