OmarNeazyI/Sunnypro-automated-egg-frying-machine/cad/native/V10V9V7V6V5CORREDICA DO MEIOV4.SLDPRT

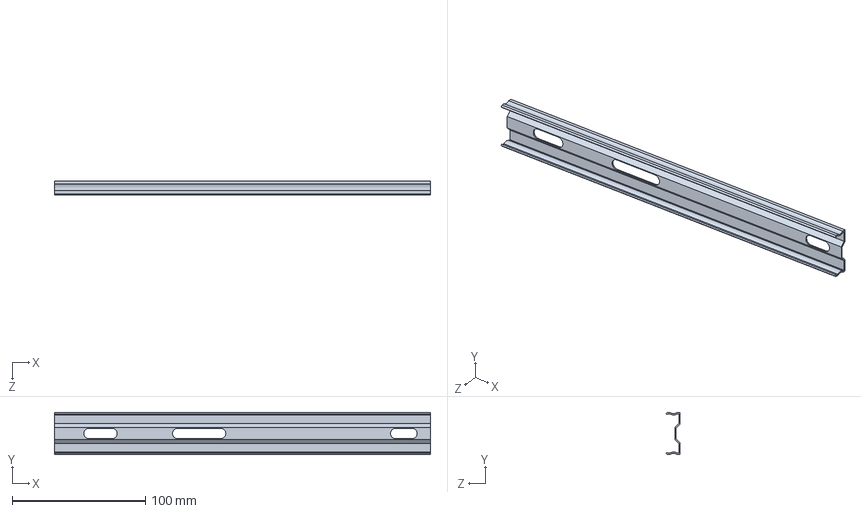
[picture p165: CAD file, 2026-11-10]
cad/native/V10V9V7V6V5CORREDICA DO MEIOV4.SLDPRT
282.0 x 31.6 x 10.7 mm
