OmarNeazyI/Sunnypro-automated-egg-frying-machine/cad/native/Drivingshaft.SLDPRT

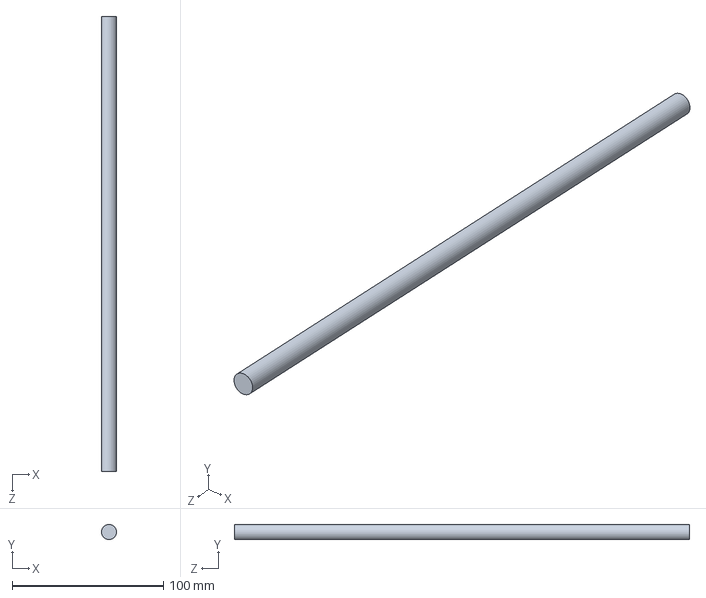
[picture p166: CAD file, 2026-11-10]
cad/native/Drivingshaft.SLDPRT
10.0 x 10.0 x 300.5 mm
