OmarNeazyI/Sunnypro-automated-egg-frying-machine/cad/native/Back of shielding.SLDPRT

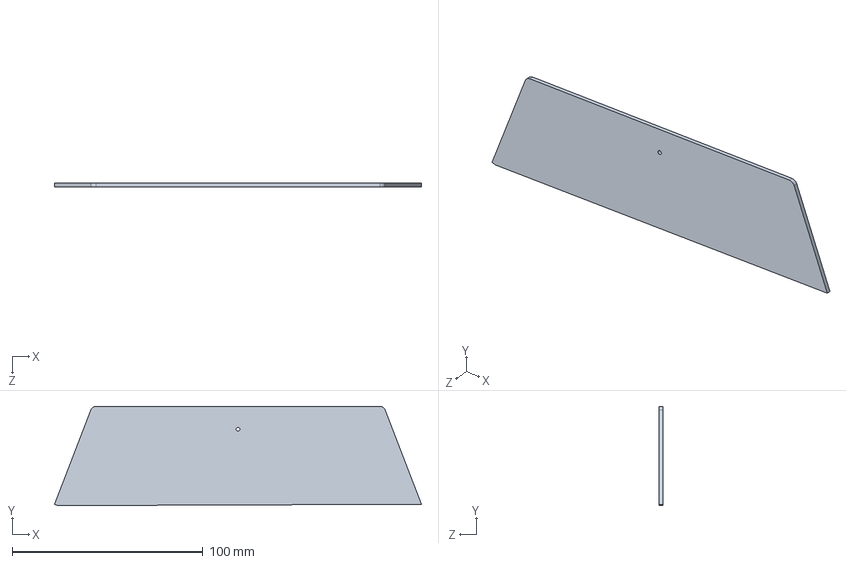
[picture p167: CAD file, 2026-11-10]
cad/native/Back of shielding.SLDPRT
192.2 x 52.0 x 2.00 mm
