OmarNeazyI/Sunnypro-automated-egg-frying-machine/cad/native/Ceramic block.SLDPRT

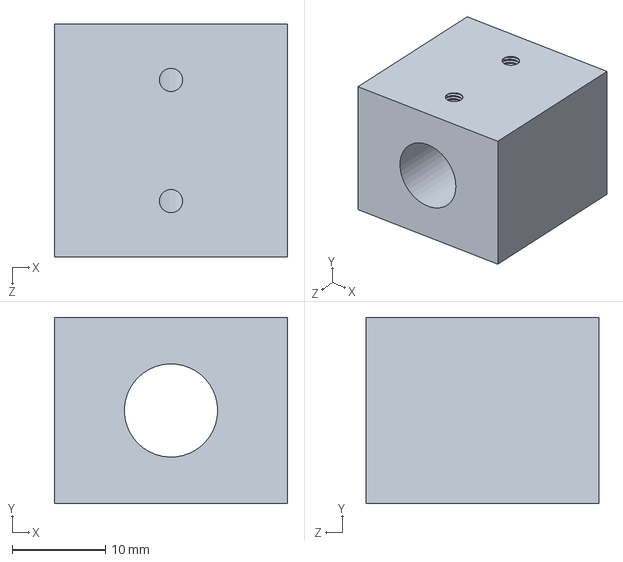
[picture p168: CAD file, 2026-11-10]
cad/native/Ceramic block.SLDPRT
25.0 x 20.0 x 25.0 mm
