OmarNeazyI/Sunnypro-automated-egg-frying-machine/cad/native/Solenoid Motor Housing.SLDPRT

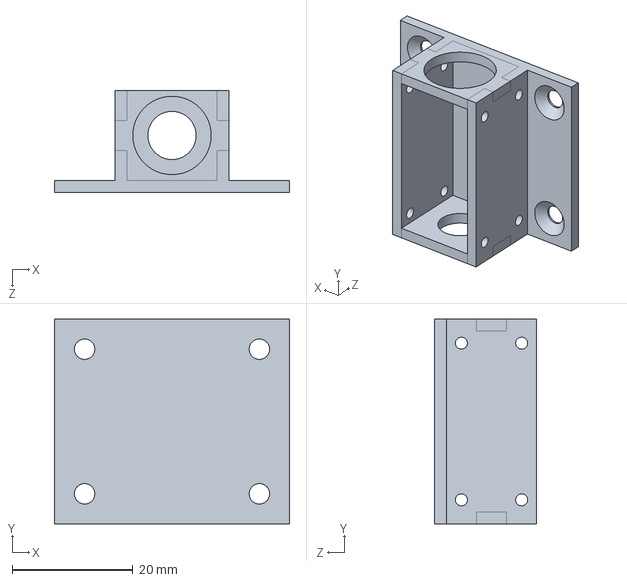
[picture p169: CAD file, 2026-11-10]
cad/native/Solenoid Motor Housing.SLDPRT
39.0 x 34.0 x 17.0 mm
