OmarNeazyI/Sunnypro-automated-egg-frying-machine/cad/native/Breaking Mech Hand.SLDPRT

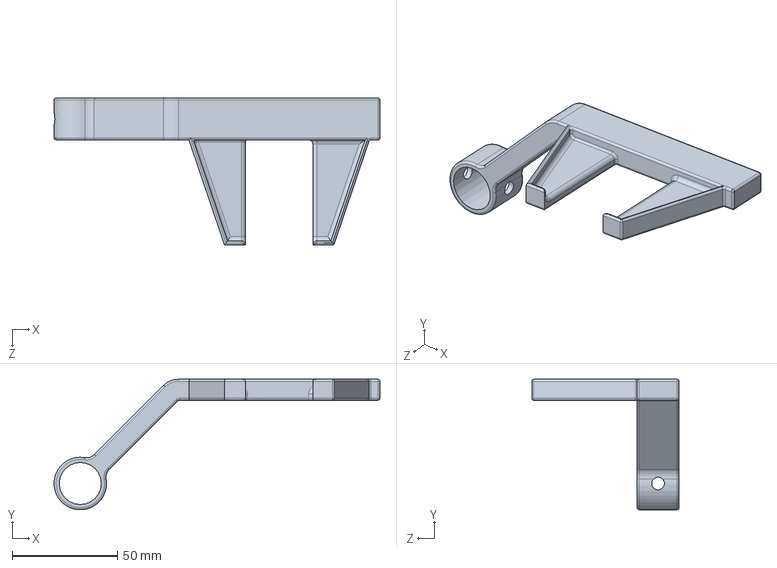
[picture p170: CAD file, 2026-11-10]
cad/native/Breaking Mech Hand.SLDPRT
155.0 x 62.0 x 70.0 mm
