OmarNeazyI/Sunnypro-automated-egg-frying-machine/cad/native/Side Mounting Breacket Heating Block.SLDPRT

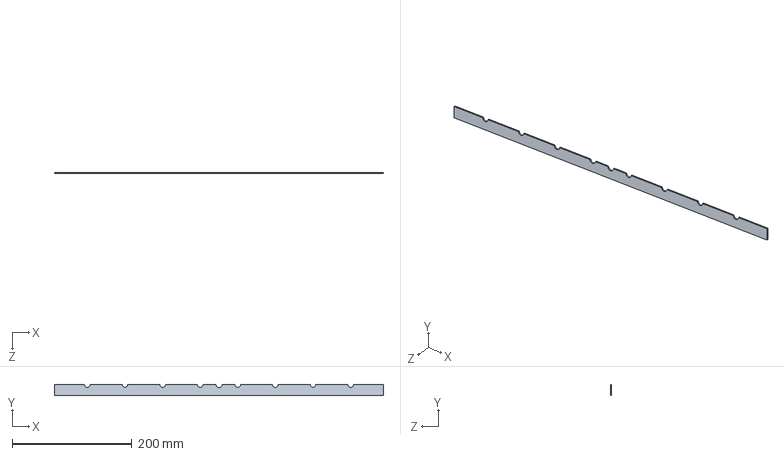
[picture p171: CAD file, 2026-11-10]
cad/native/Side Mounting Breacket Heating Block.SLDPRT
550.0 x 18.0 x 2.00 mm
