OmarNeazyI/Sunnypro-automated-egg-frying-machine/cad/native/V10V9V7V6V510100001_01.SLDPRT

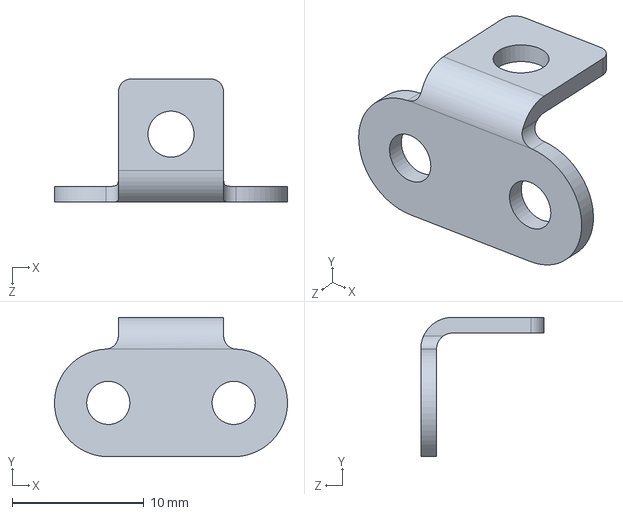
[picture p172: CAD file, 2026-11-10]
cad/native/V10V9V7V6V510100001_01.SLDPRT
17.7 x 10.6 x 9.37 mm
