OmarNeazyI/Sunnypro-automated-egg-frying-machine/cad/native/Shaft for Gate.SLDPRT

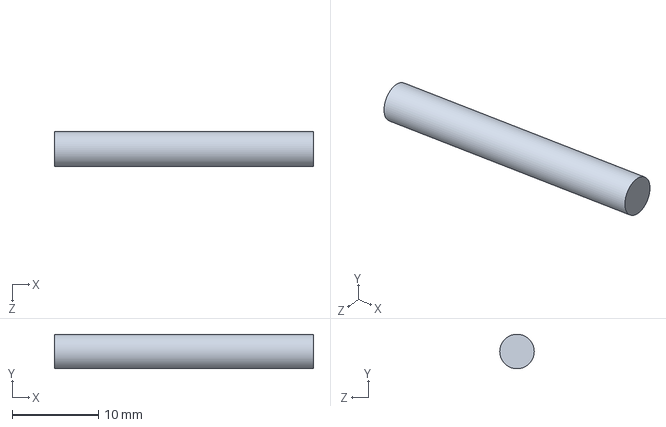
[picture p173: CAD file, 2026-11-10]
cad/native/Shaft for Gate.SLDPRT
30.0 x 3.99 x 4.00 mm
