OmarNeazyI/Sunnypro-automated-egg-frying-machine/cad/native/L bracket for servo motor.SLDPRT

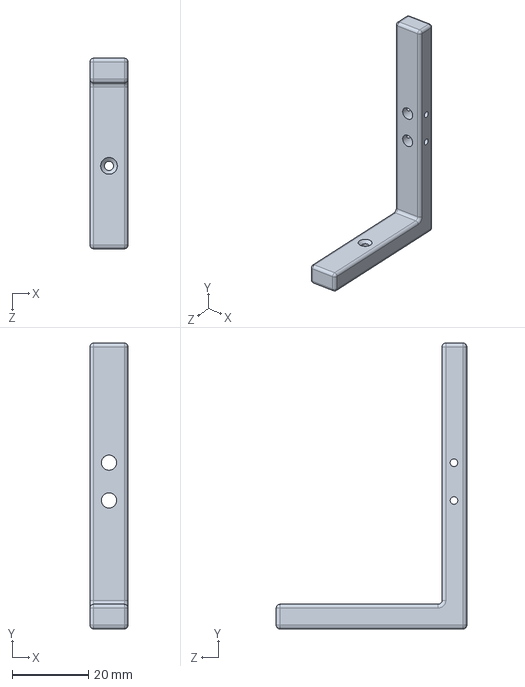
[picture p174: CAD file, 2026-11-10]
cad/native/L bracket for servo motor.SLDPRT
10.0 x 75.0 x 50.0 mm
