OmarNeazyI/Sunnypro-automated-egg-frying-machine/cad/native/V10V9V7V6V5CORREDICA INTERNOV4.SLDPRT

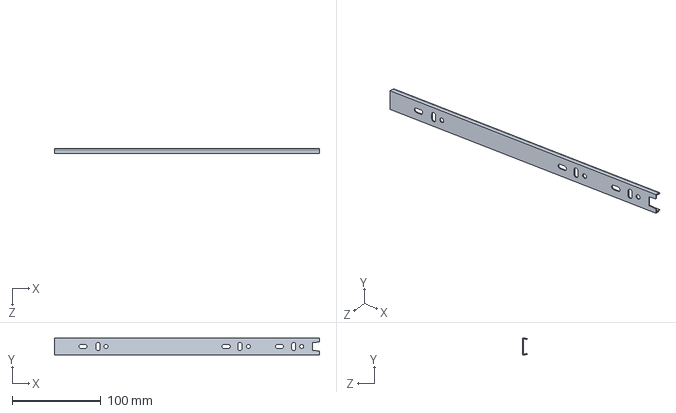
[picture p175: CAD file, 2026-11-10]
cad/native/V10V9V7V6V5CORREDICA INTERNOV4.SLDPRT
298.0 x 19.0 x 5.80 mm
