OmarNeazyI/Sunnypro-automated-egg-frying-machine/cad/native/V10V9V7V6V5O-RingV4.SLDPRT

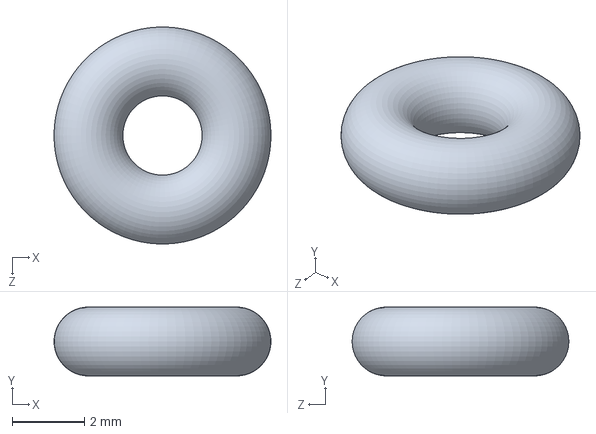
[picture p176: CAD file, 2026-11-10]
cad/native/V10V9V7V6V5O-RingV4.SLDPRT
6.00 x 1.90 x 5.99 mm
