OmarNeazyI/Sunnypro-automated-egg-frying-machine/cad/native/Chainlink2with.SLDPRT

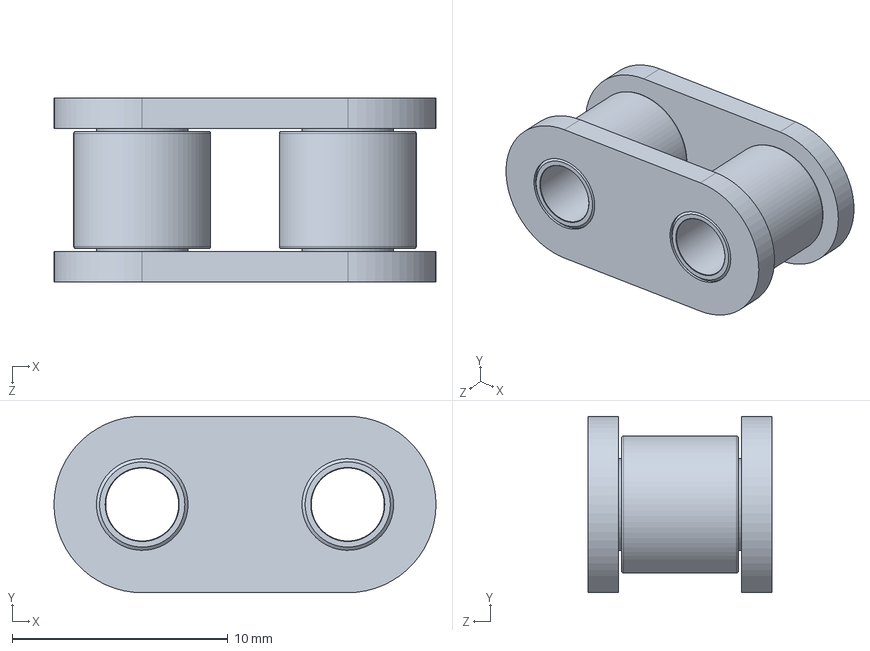
[picture p177: CAD file, 2026-11-10]
cad/native/Chainlink2with.SLDPRT
17.7 x 8.17 x 8.53 mm
