OmarNeazyI/Sunnypro-automated-egg-frying-machine/cad/native/Nema 17 Motor Mount.SLDPRT

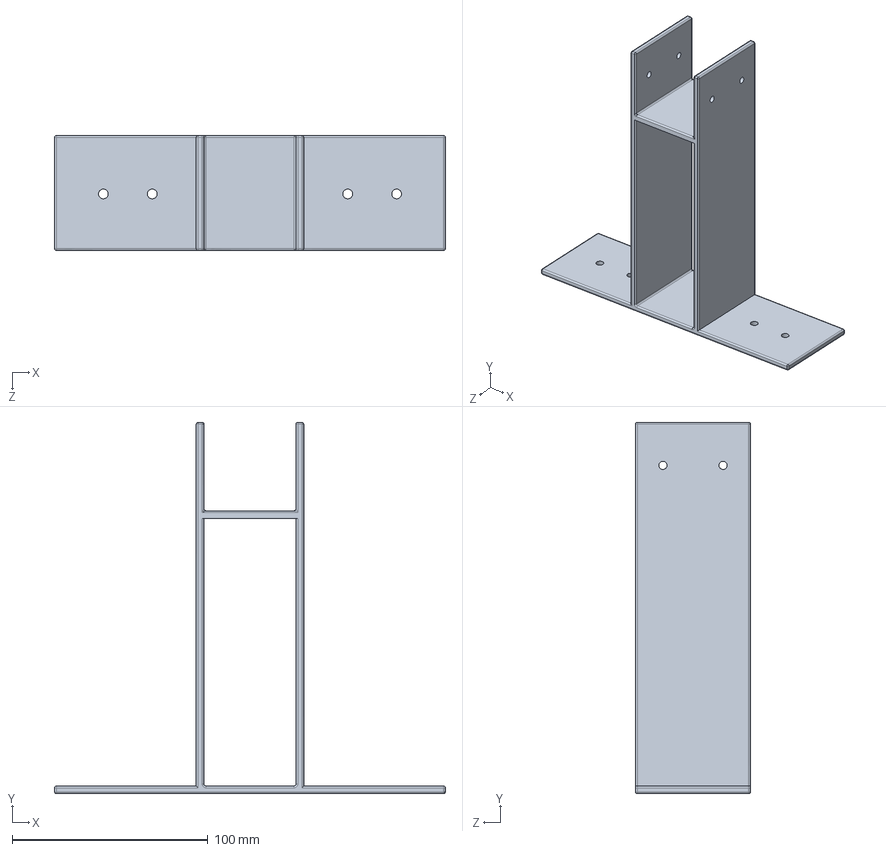
[picture p178: CAD file, 2026-11-10]
cad/native/Nema 17 Motor Mount.SLDPRT
200.0 x 190.0 x 59.0 mm
