OmarNeazyI/Sunnypro-automated-egg-frying-machine/cad/native/Extra Weldements for Breaking Mechanism Motor Mount.SLDPRT

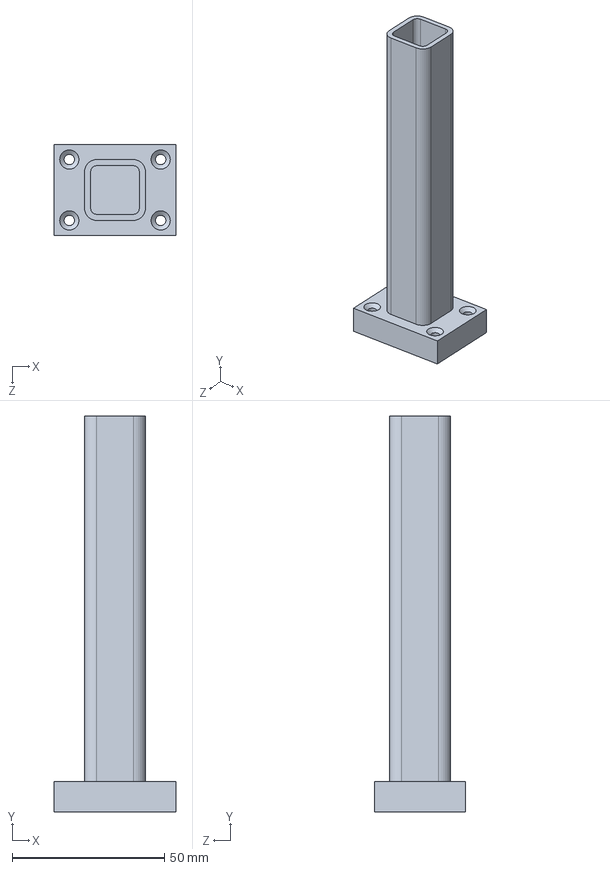
[picture p179: CAD file, 2026-11-10]
cad/native/Extra Weldements for Breaking Mechanism Motor Mount.SLDPRT
40.0 x 130.0 x 30.0 mm
