OmarNeazyI/Sunnypro-automated-egg-frying-machine/cad/native/Wide L shape Motor Housing Mount.SLDPRT

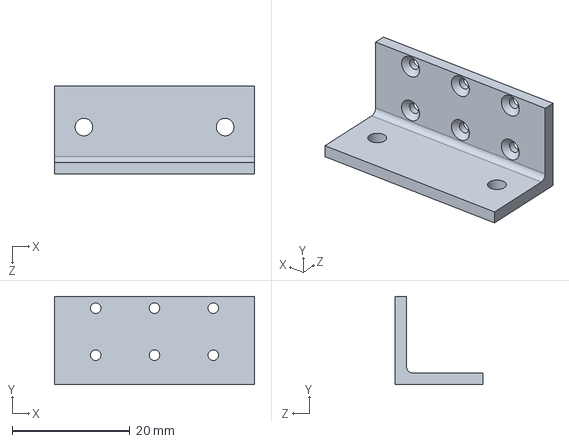
[picture p180: CAD file, 2026-11-10]
cad/native/Wide L shape Motor Housing Mount.SLDPRT
34.0 x 15.0 x 15.0 mm
