OmarNeazyI/Sunnypro-automated-egg-frying-machine/cad/native/Cartridge Heaters.SLDPRT

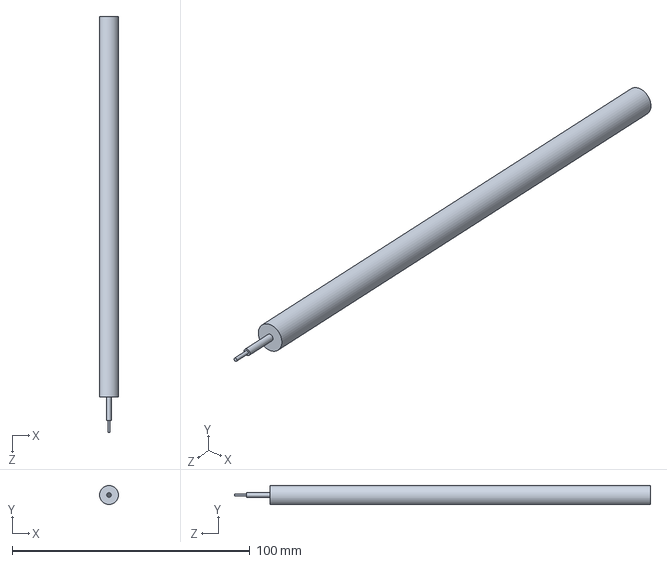
[picture p181: CAD file, 2026-11-10]
cad/native/Cartridge Heaters.SLDPRT
8.00 x 7.99 x 175.0 mm
