OmarNeazyI/Sunnypro-automated-egg-frying-machine/cad/native/12V Peristaltic pump.SLDPRT

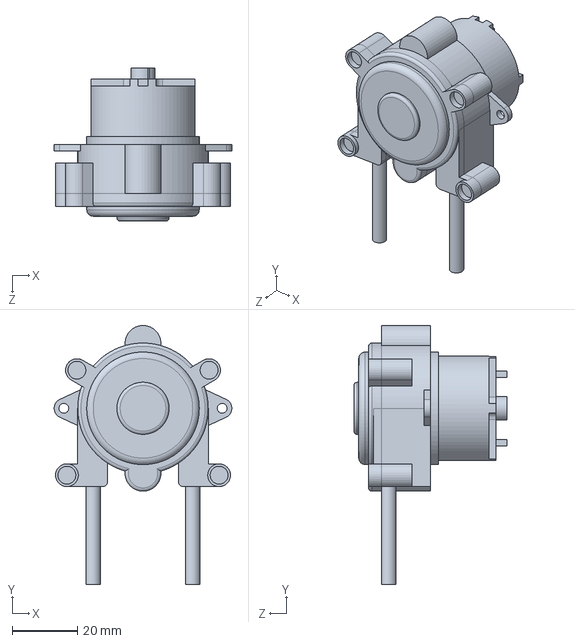
[picture p182: CAD file, 2026-11-10]
cad/native/12V Peristaltic pump.SLDPRT
54.5 x 79.4 x 47.0 mm
