OmarNeazyI/Sunnypro-automated-egg-frying-machine/cad/native/Storage Handle for Drawer.SLDPRT

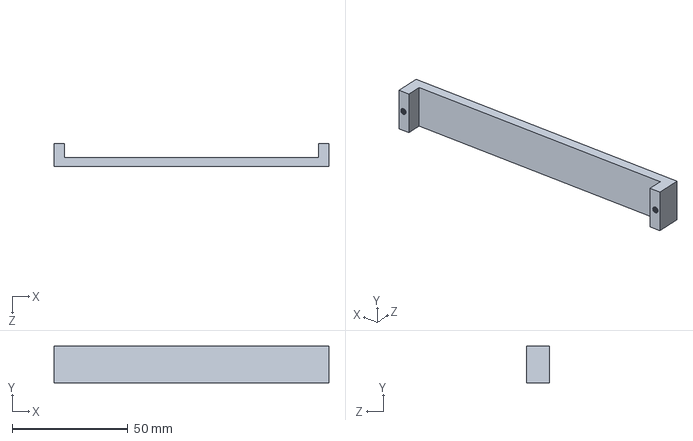
[picture p183: CAD file, 2026-11-10]
cad/native/Storage Handle for Drawer.SLDPRT
119.0 x 16.0 x 10.0 mm
