OmarNeazyI/Sunnypro-automated-egg-frying-machine/cad/native/V10V9V7V6V5Copy of ButtonV4.SLDPRT

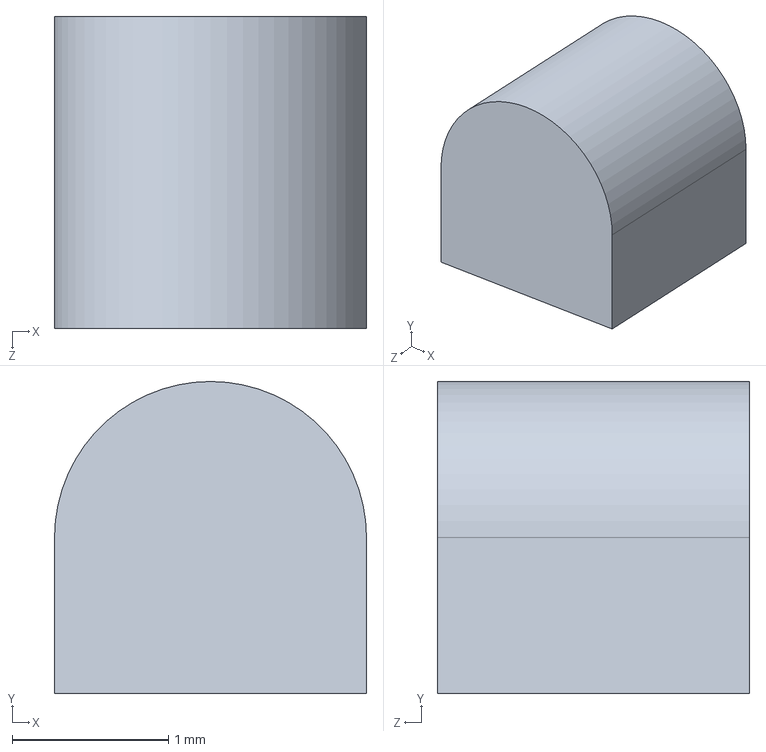
[picture p184: CAD file, 2026-11-10]
cad/native/V10V9V7V6V5Copy of ButtonV4.SLDPRT
2.00 x 2.00 x 2.00 mm
