OmarNeazyI/Sunnypro-automated-egg-frying-machine/cad/native/V10V9V7V6V5Teflon D8d5V4.SLDPRT

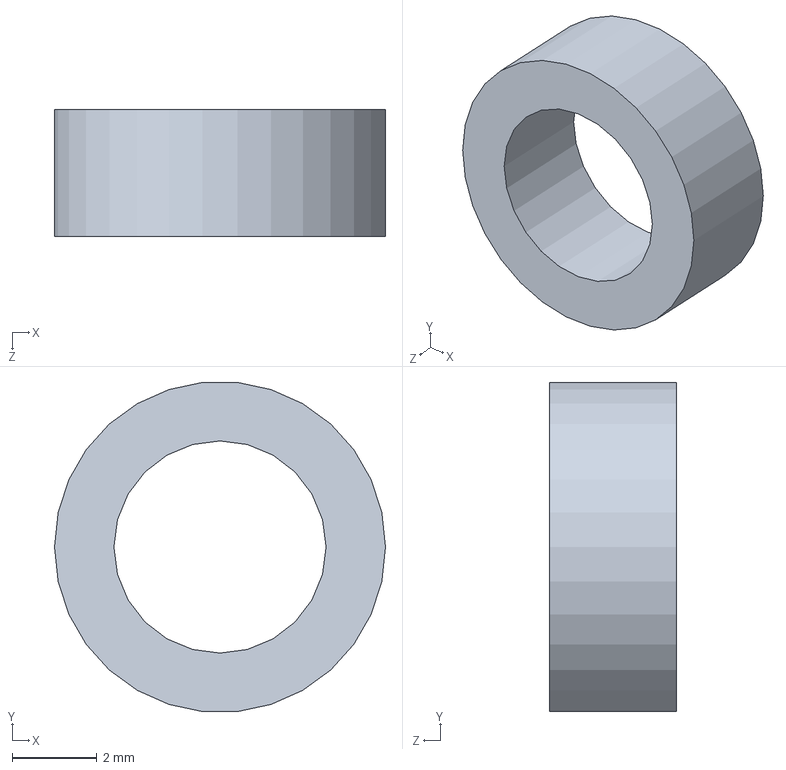
[picture p185: CAD file, 2026-11-10]
cad/native/V10V9V7V6V5Teflon D8d5V4.SLDPRT
7.80 x 7.76 x 3.00 mm
