OmarNeazyI/Sunnypro-automated-egg-frying-machine/cad/native/V10V9V7V6V528BYJ-48 cover plateV4.SLDPRT

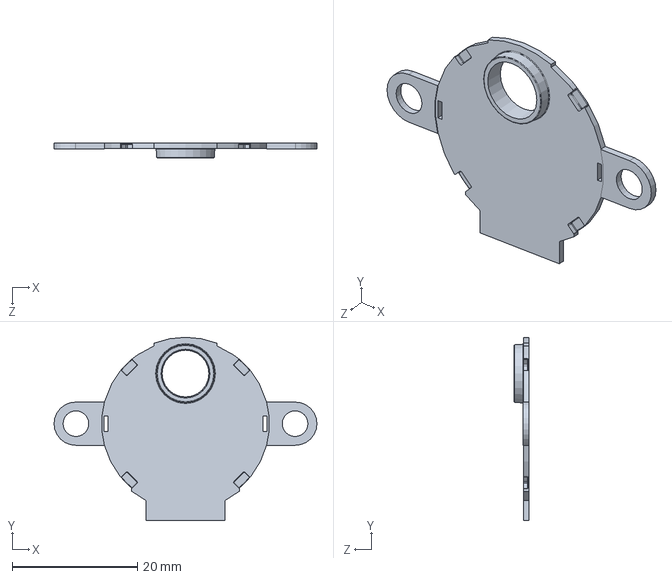
[picture p186: CAD file, 2026-11-10]
cad/native/V10V9V7V6V528BYJ-48 cover plateV4.SLDPRT
42.0 x 29.3 x 2.35 mm
