OmarNeazyI/Sunnypro-automated-egg-frying-machine/cad/native/Plastic Egg Transportation Tunnel.SLDPRT

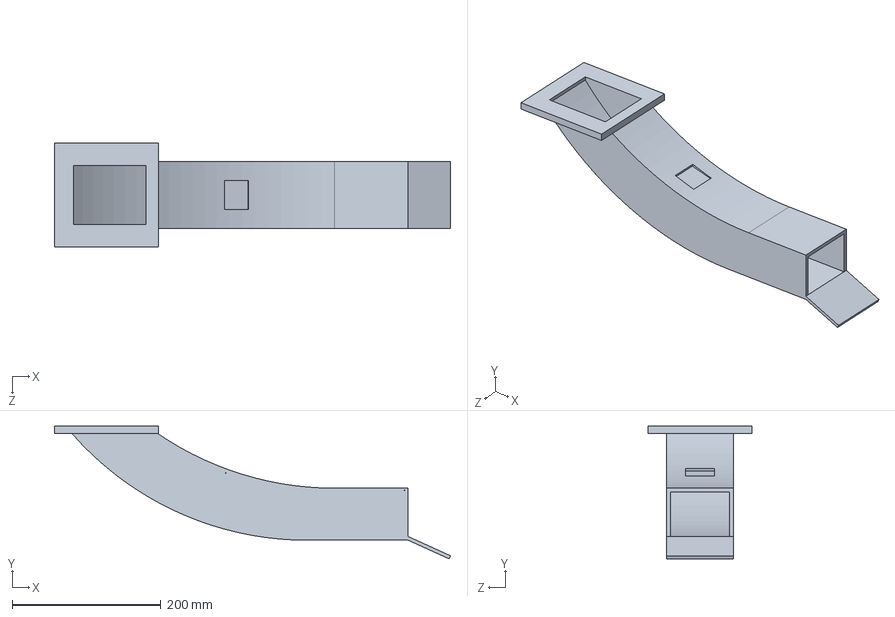
[picture p187: CAD file, 2026-11-10]
cad/native/Plastic Egg Transportation Tunnel.SLDPRT
532.5 x 178.4 x 140.0 mm
