OmarNeazyI/Sunnypro-automated-egg-frying-machine/cad/native/Spear Hands.SLDPRT

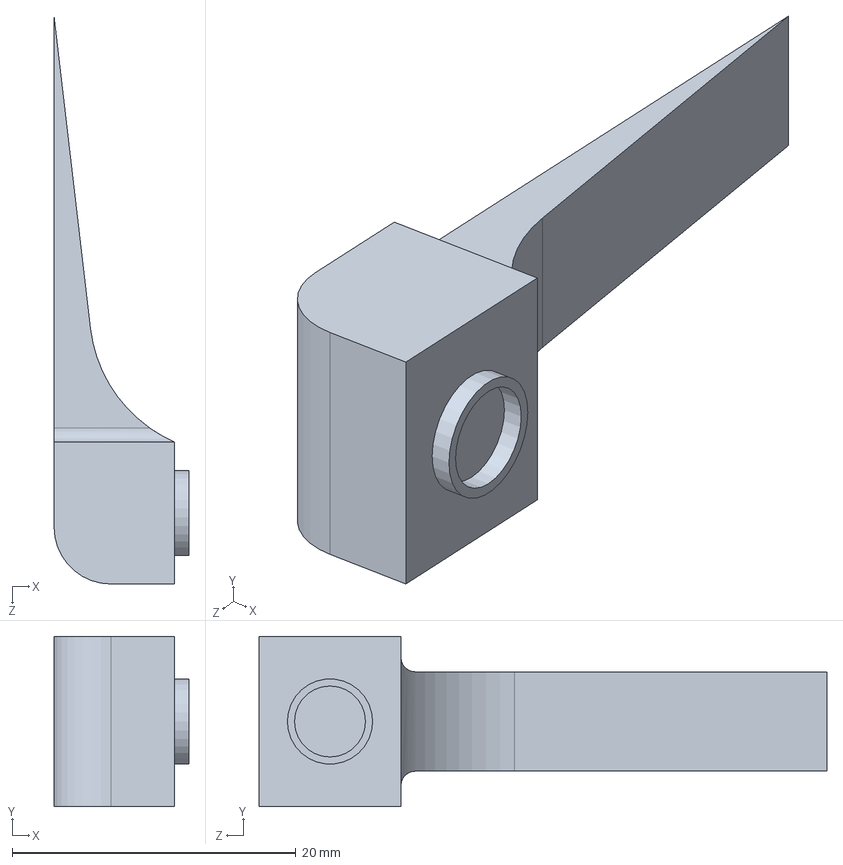
[picture p188: CAD file, 2026-11-10]
cad/native/Spear Hands.SLDPRT
9.50 x 12.0 x 40.0 mm
