OmarNeazyI/Sunnypro-automated-egg-frying-machine/cad/native/V10V9V7V6V5edittedecnoderpart.SLDPRT

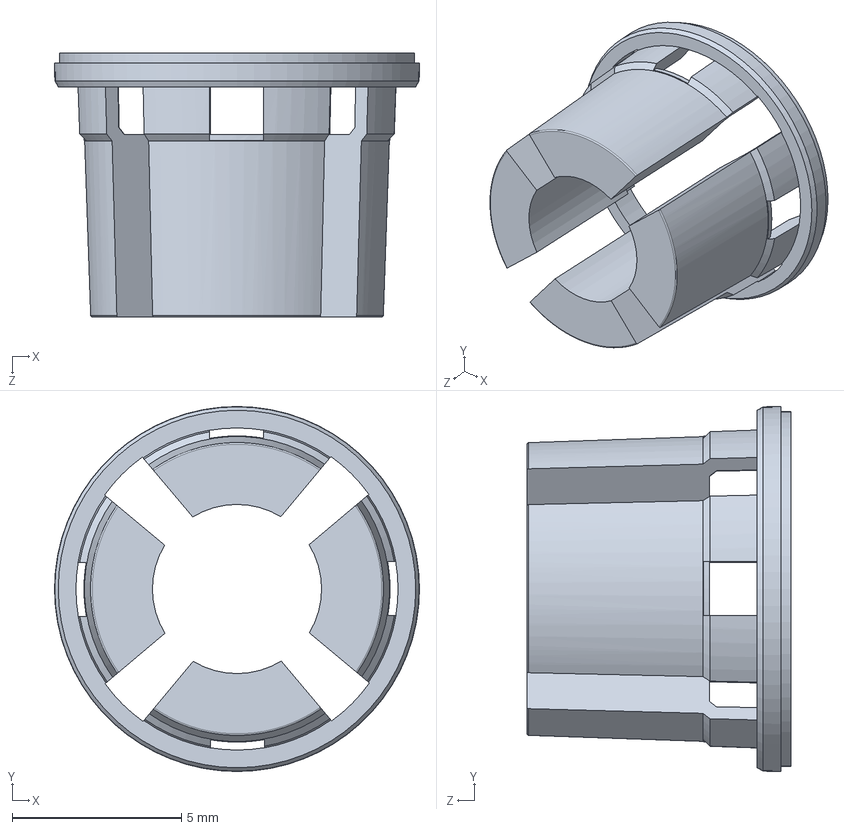
[picture p189: CAD file, 2026-11-10]
cad/native/V10V9V7V6V5edittedecnoderpart.SLDPRT
10.8 x 10.8 x 7.80 mm
