OmarNeazyI/Sunnypro-automated-egg-frying-machine/cad/native/Bottom Frame Heating Block.SLDPRT

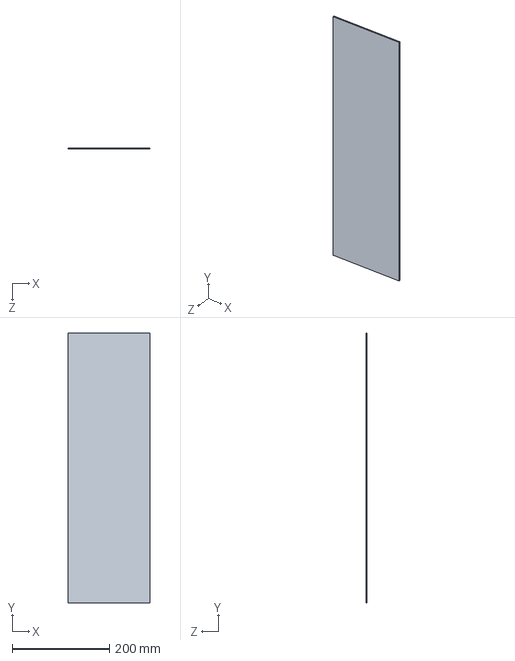
[picture p190: CAD file, 2026-11-10]
cad/native/Bottom Frame Heating Block.SLDPRT
169.0 x 554.0 x 3.00 mm
