OmarNeazyI/Sunnypro-automated-egg-frying-machine/cad/native/Egg Conveyor Plates.SLDPRT

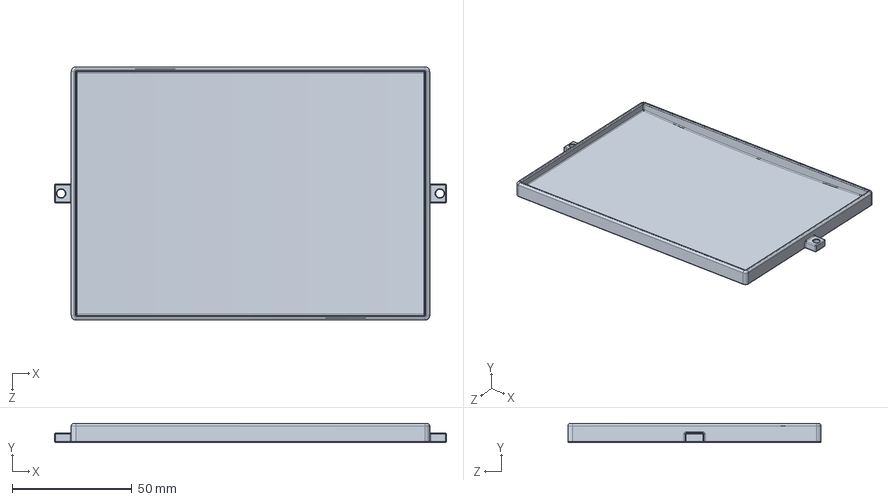
[picture p191: CAD file, 2026-11-10]
cad/native/Egg Conveyor Plates.SLDPRT
164.0 x 8.00 x 106.0 mm
