OmarNeazyI/Sunnypro-automated-egg-frying-machine/cad/native/Rotating Top Steel Plate.SLDPRT

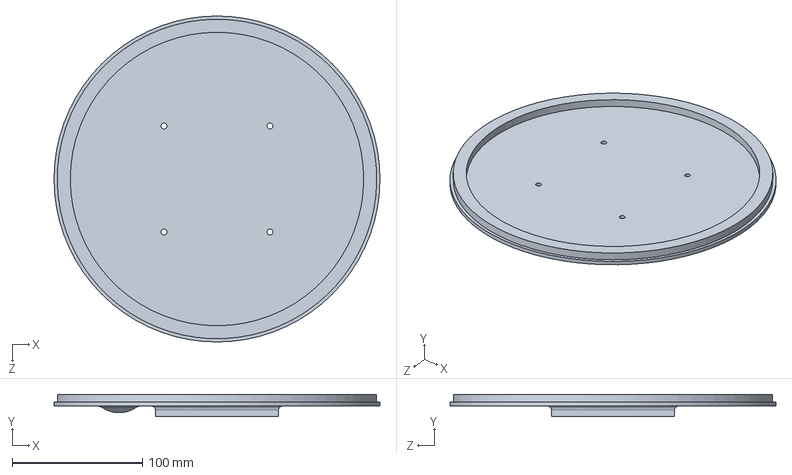
[picture p192: CAD file, 2026-11-10]
cad/native/Rotating Top Steel Plate.SLDPRT
250.0 x 17.0 x 250.0 mm
