OmarNeazyI/Sunnypro-automated-egg-frying-machine/cad/native/V10V9V7V6V5Flexible Coupler Body.SLDPRT

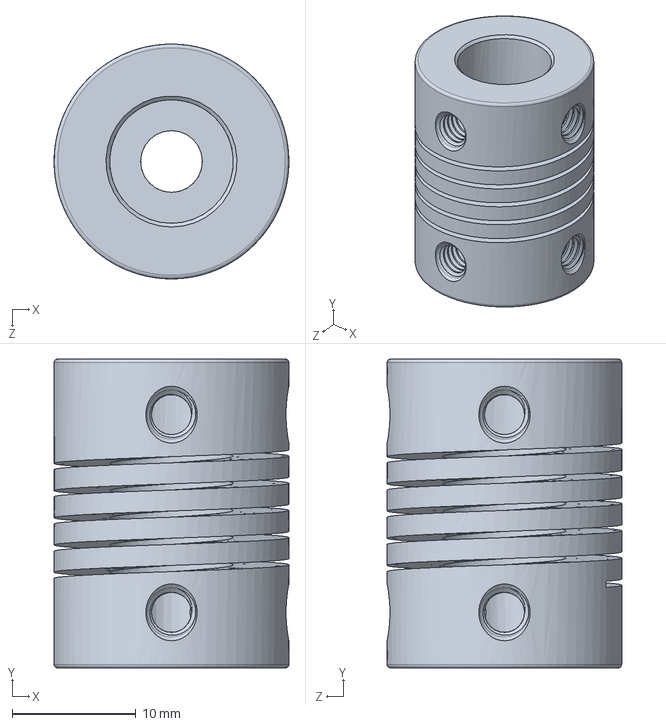
[picture p193: CAD file, 2026-11-10]
cad/native/V10V9V7V6V5Flexible Coupler Body.SLDPRT
19.0 x 25.0 x 19.0 mm
