OmarNeazyI/Sunnypro-automated-egg-frying-machine/cad/native/V10V9V7V6Ball Adjuster Rod 60mm Long 57mm Thread.SLDPRT

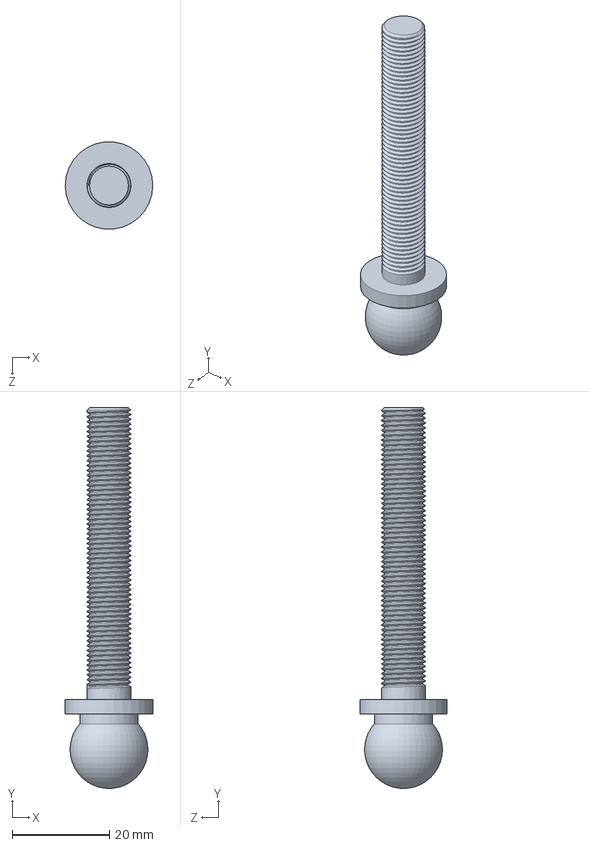
[picture p194: CAD file, 2026-11-10]
cad/native/V10V9V7V6Ball Adjuster Rod 60mm Long 57mm Thread.SLDPRT
18.0 x 78.3 x 17.9 mm
