OmarNeazyI/Sunnypro-automated-egg-frying-machine/cad/native/L bracket for oil tank.SLDPRT

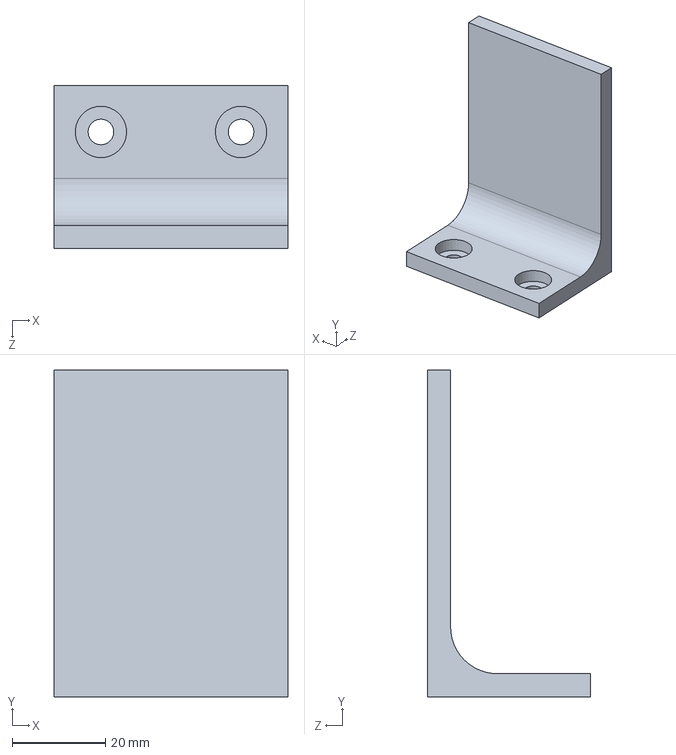
[picture p195: CAD file, 2026-11-10]
cad/native/L bracket for oil tank.SLDPRT
50.0 x 70.0 x 35.0 mm
