OmarNeazyI/Sunnypro-automated-egg-frying-machine/cad/native/Make Electrical Box.SLDPRT

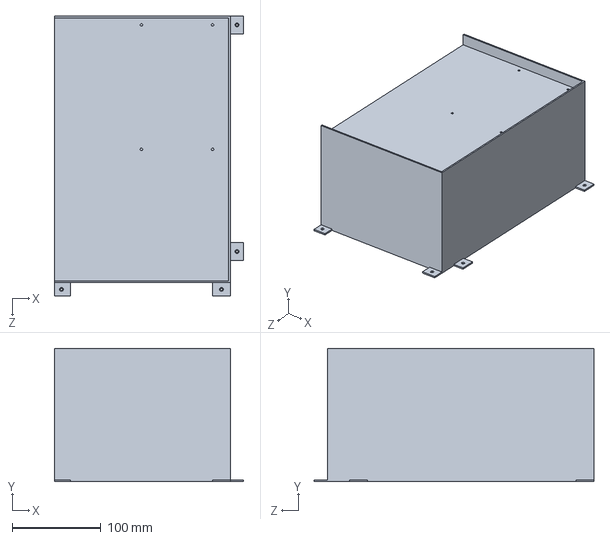
[picture p196: CAD file, 2026-11-10]
cad/native/Make Electrical Box.SLDPRT
213.0 x 150.0 x 315.0 mm
