OmarNeazyI/Sunnypro-automated-egg-frying-machine/cad/native/PT100 Sensor Wires.SLDPRT

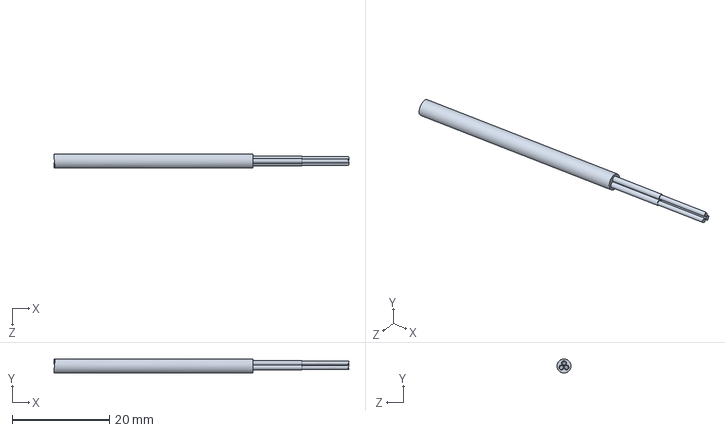
[picture p197: CAD file, 2026-11-10]
cad/native/PT100 Sensor Wires.SLDPRT
60.7 x 2.90 x 2.90 mm
