OmarNeazyI/Sunnypro-automated-egg-frying-machine/cad/native/Tank Cap.SLDPRT

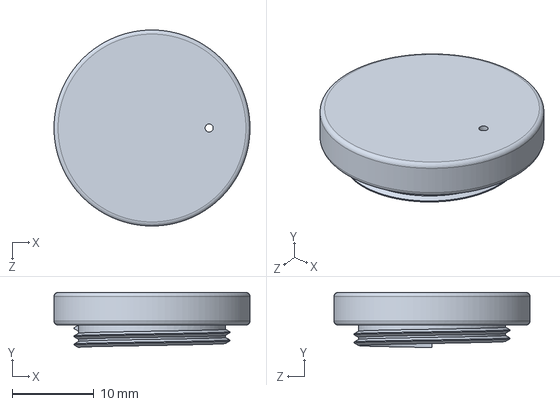
[picture p198: CAD file, 2026-11-10]
cad/native/Tank Cap.SLDPRT
24.0 x 6.75 x 24.0 mm
