OmarNeazyI/Sunnypro-automated-egg-frying-machine/cad/native/Left Side Plastic Panel With Glass.SLDPRT

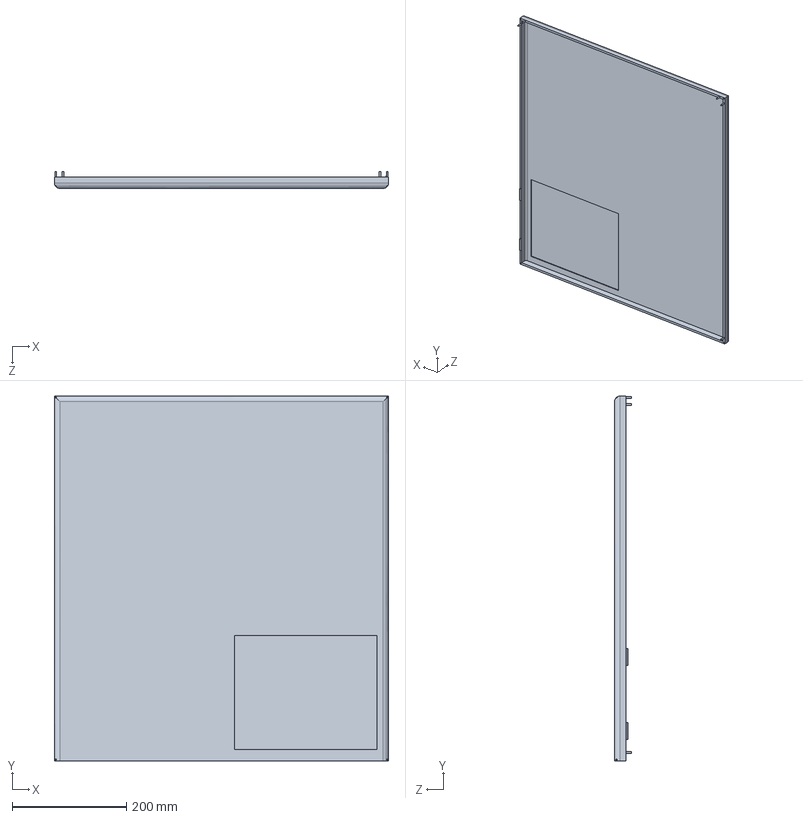
[picture p199: CAD file, 2026-11-10]
cad/native/Left Side Plastic Panel With Glass.SLDPRT
586.0 x 640.0 x 30.0 mm
