OmarNeazyI/Sunnypro-automated-egg-frying-machine/cad/native/Brackets for heating block.SLDPRT

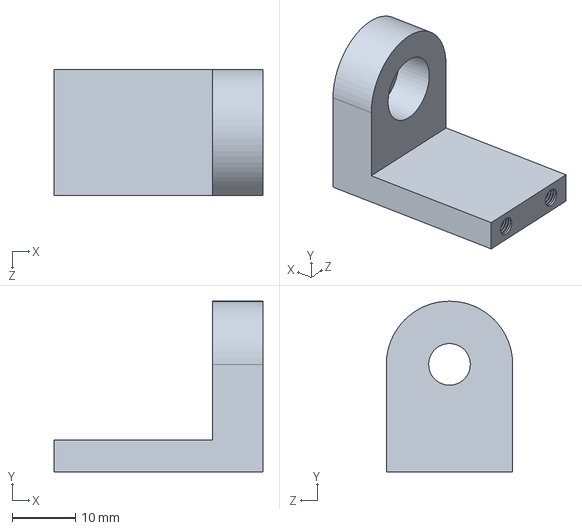
[picture p200: CAD file, 2026-11-10]
cad/native/Brackets for heating block.SLDPRT
33.1 x 27.0 x 20.0 mm
