OmarNeazyI/Sunnypro-automated-egg-frying-machine/cad/native/Frame Extra Weldement for Solenoid Motor Gate 1.SLDPRT

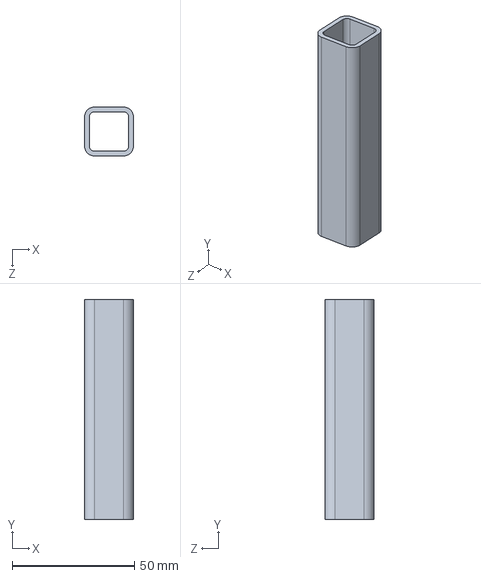
[picture p201: CAD file, 2026-11-10]
cad/native/Frame Extra Weldement for Solenoid Motor Gate 1.SLDPRT
20.0 x 90.0 x 20.0 mm
