OmarNeazyI/Sunnypro-automated-egg-frying-machine/cad/native/Planetary 1 to 27 Gearbox.SLDPRT

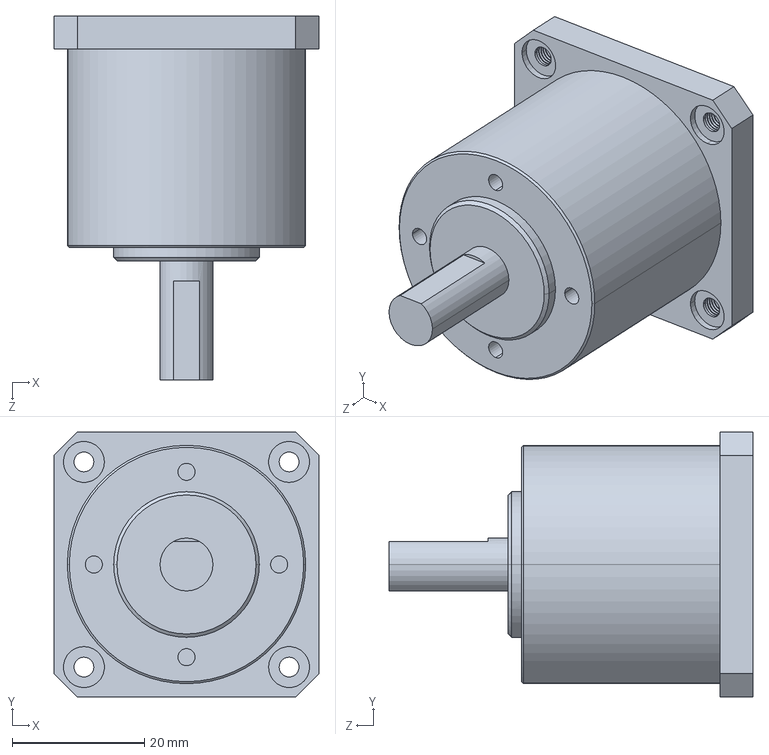
[picture p202: CAD file, 2026-11-10]
cad/native/Planetary 1 to 27 Gearbox.SLDPRT
40.0 x 40.0 x 55.0 mm
