OmarNeazyI/Sunnypro-automated-egg-frying-machine/cad/native/V10V9Motion + Load Cell PCB.SLDPRT

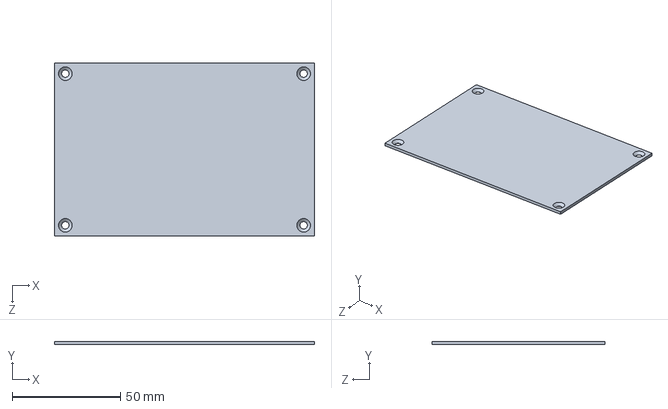
[picture p203: CAD file, 2026-11-10]
cad/native/V10V9Motion + Load Cell PCB.SLDPRT
120.0 x 1.60 x 80.0 mm
