OmarNeazyI/Sunnypro-automated-egg-frying-machine/cad/native/V10V9V7V6V5CORREDICA EXTERNAV4.SLDPRT

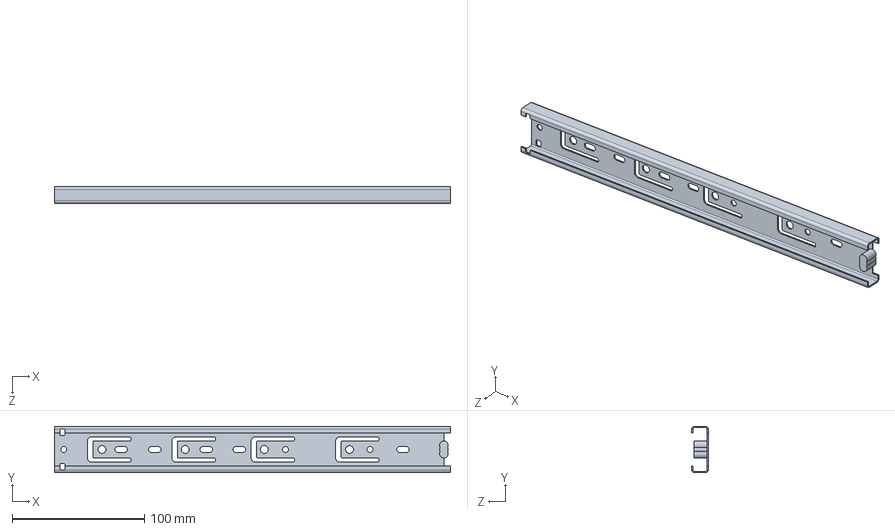
[picture p204: CAD file, 2026-11-10]
cad/native/V10V9V7V6V5CORREDICA EXTERNAV4.SLDPRT
300.0 x 35.0 x 12.7 mm
