OmarNeazyI/Sunnypro-automated-egg-frying-machine/cad/native/V10V9V7V6V5PlungerV4.SLDPRT

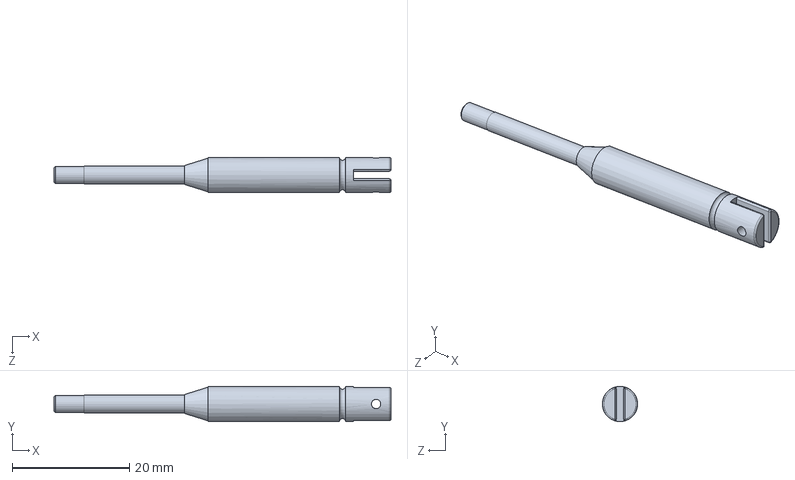
[picture p205: CAD file, 2026-11-10]
cad/native/V10V9V7V6V5PlungerV4.SLDPRT
57.4 x 6.00 x 6.00 mm
