OmarNeazyI/Sunnypro-automated-egg-frying-machine/cad/native/Top Case Plastic Panel.SLDPRT

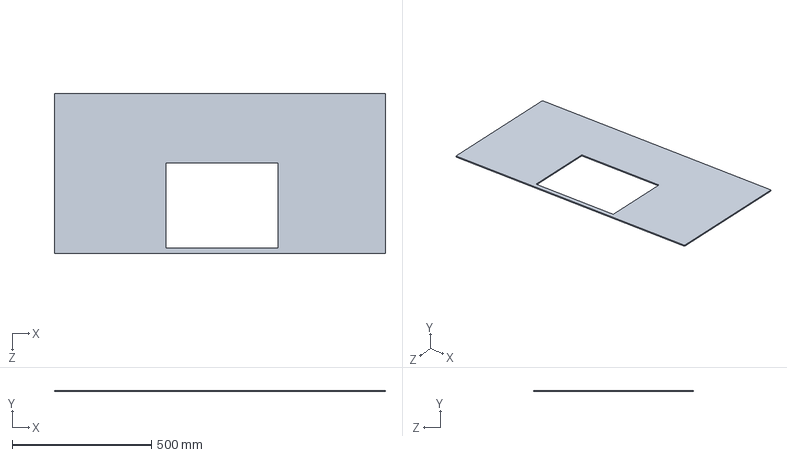
[picture p206: CAD file, 2026-11-10]
cad/native/Top Case Plastic Panel.SLDPRT
1190.0 x 5.00 x 576.0 mm
