OmarNeazyI/Sunnypro-automated-egg-frying-machine/cad/native/Standard Nozzle spray.sldprt

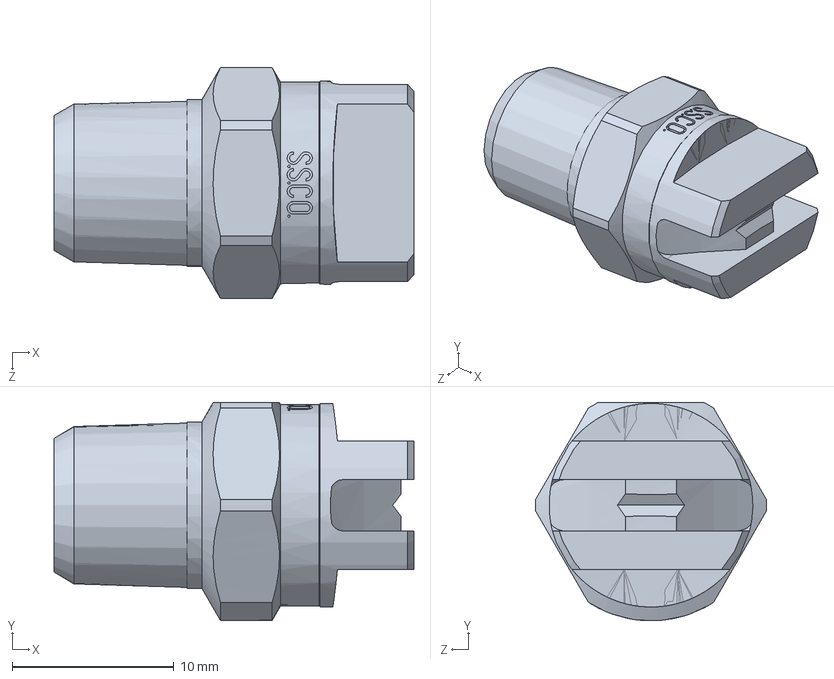
[picture p207: CAD file, 2026-11-10]
cad/native/Standard Nozzle spray.sldprt
22.2 x 13.5 x 14.3 mm
