OmarNeazyI/Sunnypro-automated-egg-frying-machine/cad/native/V10V9V7V6V5Servo MG996R arm01V4.SLDPRT

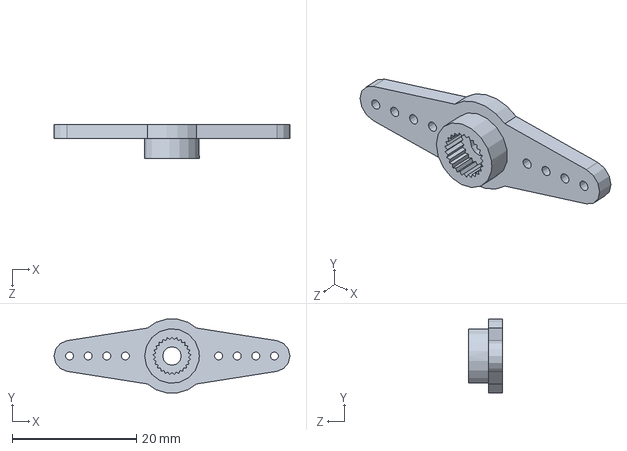
[picture p208: CAD file, 2026-11-10]
cad/native/V10V9V7V6V5Servo MG996R arm01V4.SLDPRT
38.0 x 11.9 x 5.50 mm
