OmarNeazyI/Sunnypro-automated-egg-frying-machine/cad/native/Idlersupportshaft.SLDPRT

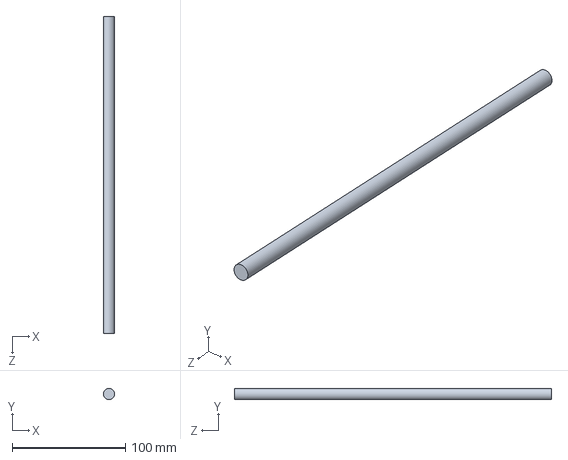
[picture p209: CAD file, 2026-11-10]
cad/native/Idlersupportshaft.SLDPRT
10.0 x 9.99 x 280.0 mm
