OmarNeazyI/Sunnypro-automated-egg-frying-machine/cad/native/V10V9V7V6V5rr-215-60ur-ex375_02V4.SLDPRT

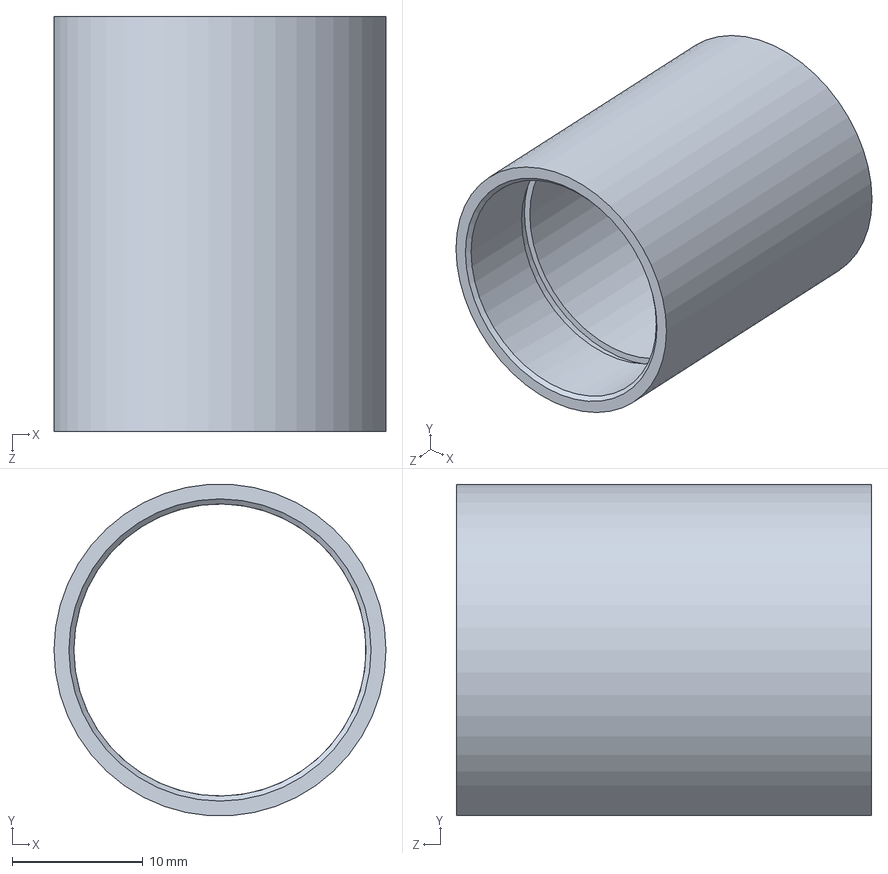
[picture p210: CAD file, 2026-11-10]
cad/native/V10V9V7V6V5rr-215-60ur-ex375_02V4.SLDPRT
25.4 x 25.3 x 31.8 mm
