OmarNeazyI/Sunnypro-automated-egg-frying-machine/cad/native/V10V9V7V6V5Copy of CaseV4.SLDPRT

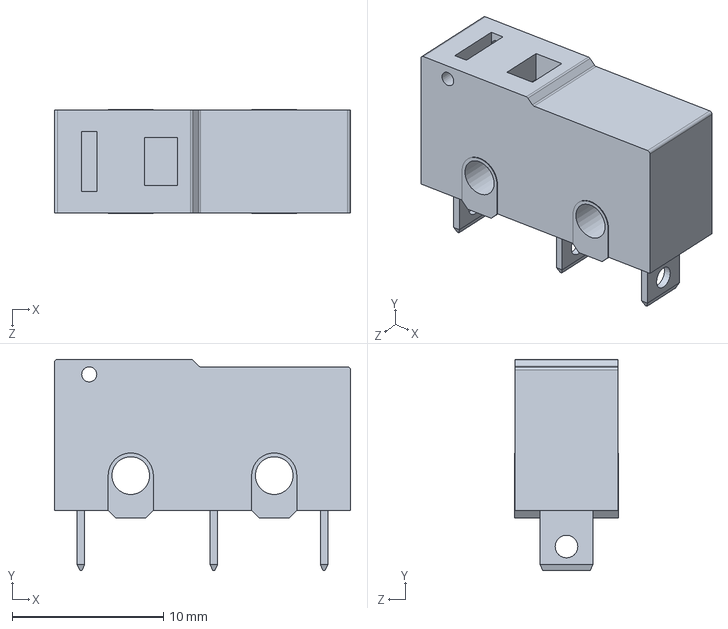
[picture p211: CAD file, 2026-11-10]
cad/native/V10V9V7V6V5Copy of CaseV4.SLDPRT
19.6 x 14.0 x 6.90 mm
