OmarNeazyI/Sunnypro-automated-egg-frying-machine/cad/native/Rotating Plate Stepper Motor Mount.SLDPRT

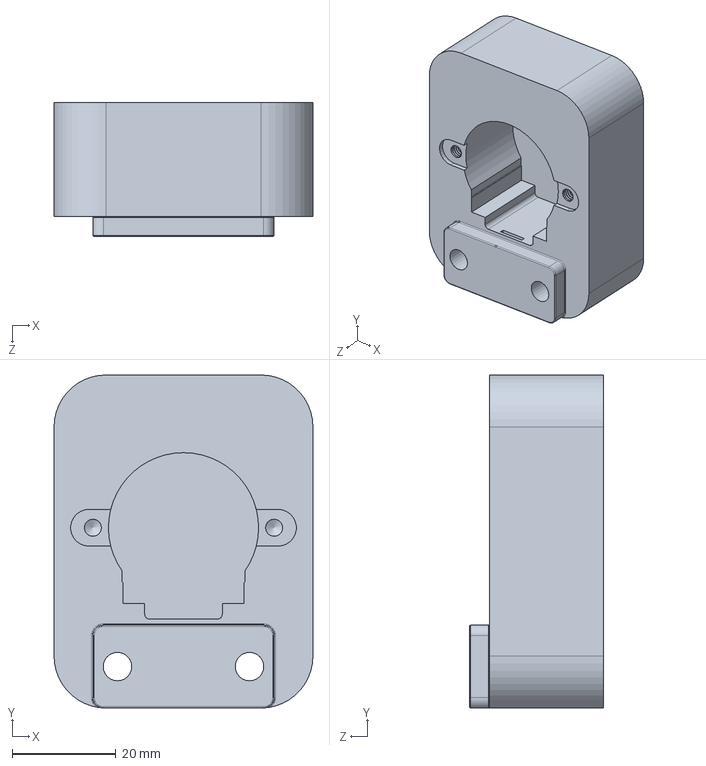
[picture p212: CAD file, 2026-11-10]
cad/native/Rotating Plate Stepper Motor Mount.SLDPRT
50.0 x 64.3 x 25.9 mm
