OmarNeazyI/Sunnypro-automated-egg-frying-machine/cad/native/8412ngmV4.SLDPRT

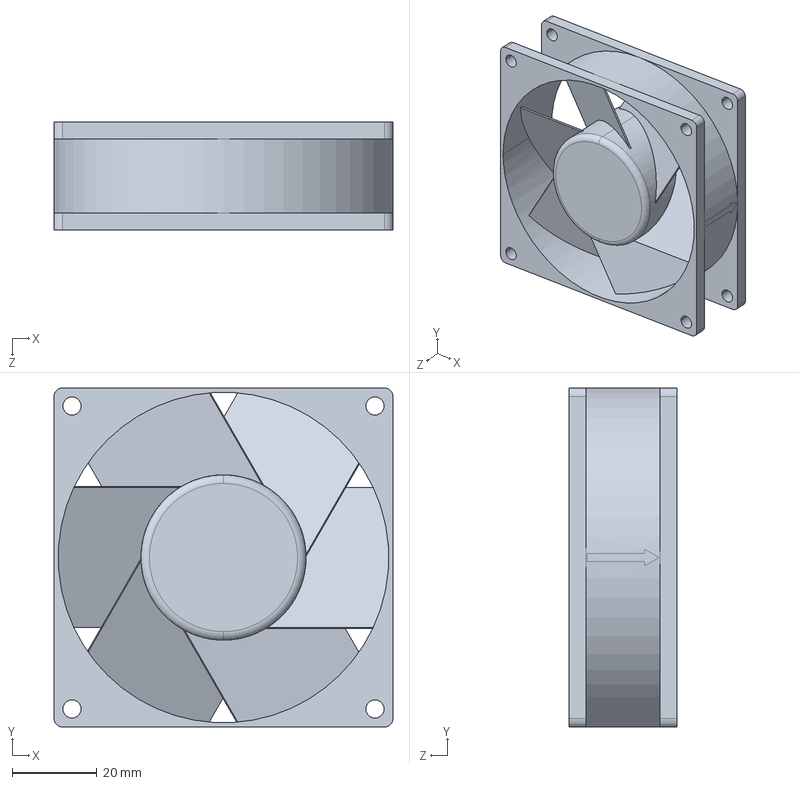
[picture p213: CAD file, 2026-11-10]
cad/native/8412ngmV4.SLDPRT
80.0 x 80.0 x 25.4 mm
