OmarNeazyI/Sunnypro-automated-egg-frying-machine/cad/native/V10V9V7V6V510100001_02.SLDPRT

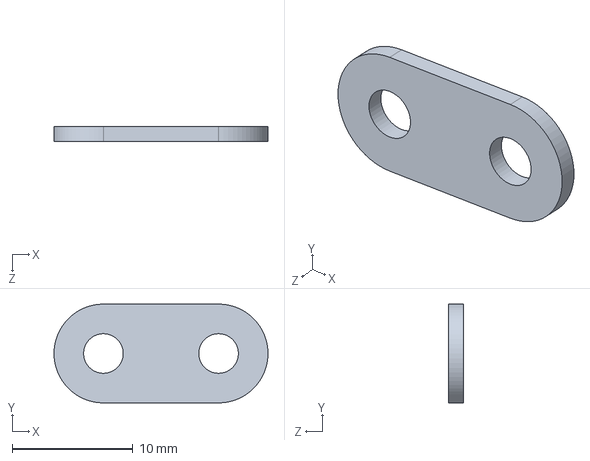
[picture p214: CAD file, 2026-11-10]
cad/native/V10V9V7V6V510100001_02.SLDPRT
17.7 x 8.17 x 1.20 mm
