OmarNeazyI/Sunnypro-automated-egg-frying-machine/cad/native/V10V9V7V6V5CirclipV4.SLDPRT

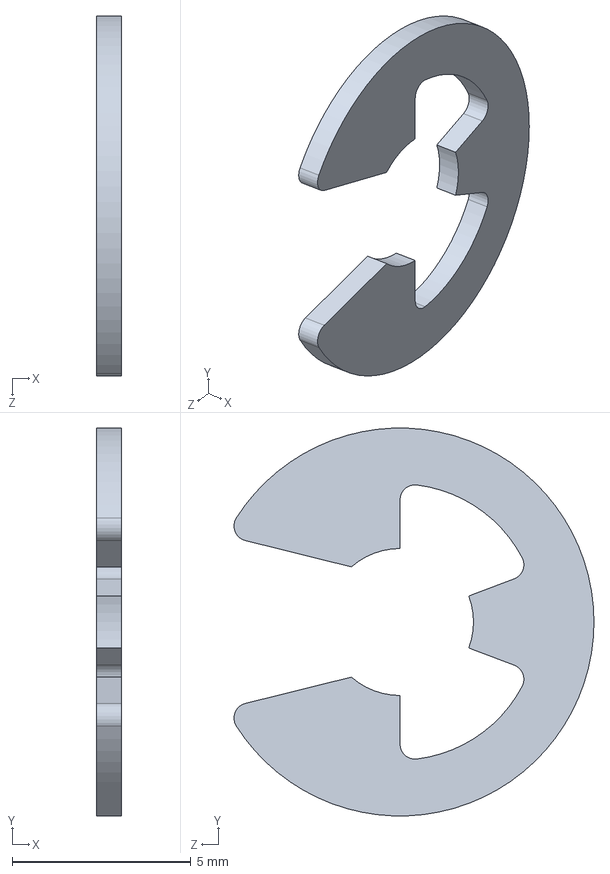
[picture p215: CAD file, 2026-11-10]
cad/native/V10V9V7V6V5CirclipV4.SLDPRT
0.7 x 10.8 x 10.1 mm
