OmarNeazyI/Sunnypro-automated-egg-frying-machine/cad/native/Plastic Back Plate for Display.SLDPRT

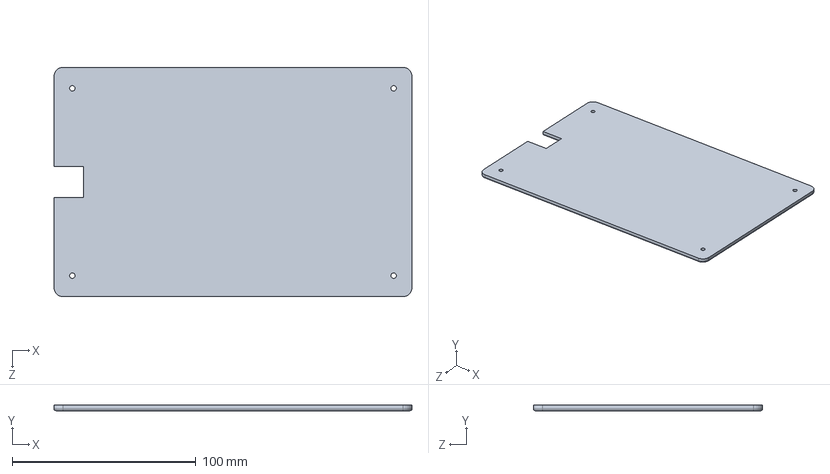
[picture p216: CAD file, 2026-11-10]
cad/native/Plastic Back Plate for Display.SLDPRT
195.0 x 3.00 x 125.0 mm
