OmarNeazyI/Sunnypro-automated-egg-frying-machine/cad/native/KFL000 bearing unit 10mm.SLDPRT

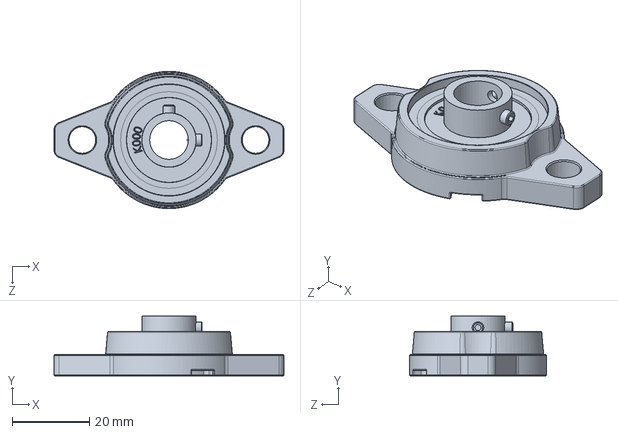
[picture p217: CAD file, 2026-11-10]
cad/native/KFL000 bearing unit 10mm.SLDPRT
59.5 x 15.5 x 35.5 mm
