OmarNeazyI/Sunnypro-automated-egg-frying-machine/cad/native/V10V9V7V6V5Egg shell storage unitV4.SLDPRT

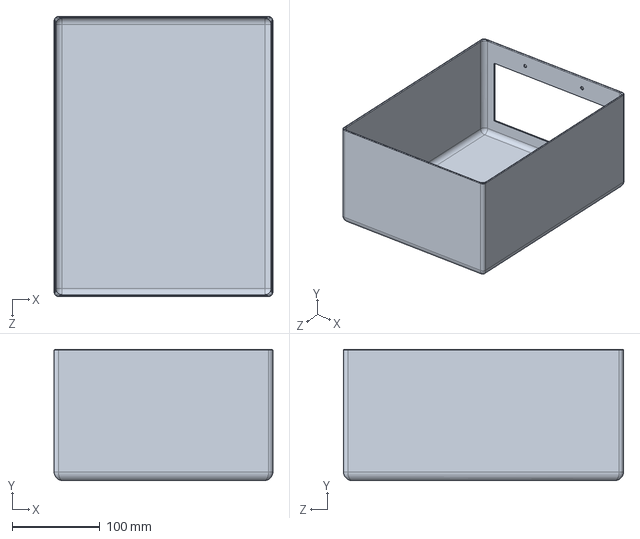
[picture p218: CAD file, 2026-11-10]
cad/native/V10V9V7V6V5Egg shell storage unitV4.SLDPRT
250.0 x 150.0 x 320.0 mm
