OmarNeazyI/Sunnypro-automated-egg-frying-machine/cad/native/V10V9V7V6V5rr-215-60ur-ex375_03V4.SLDPRT

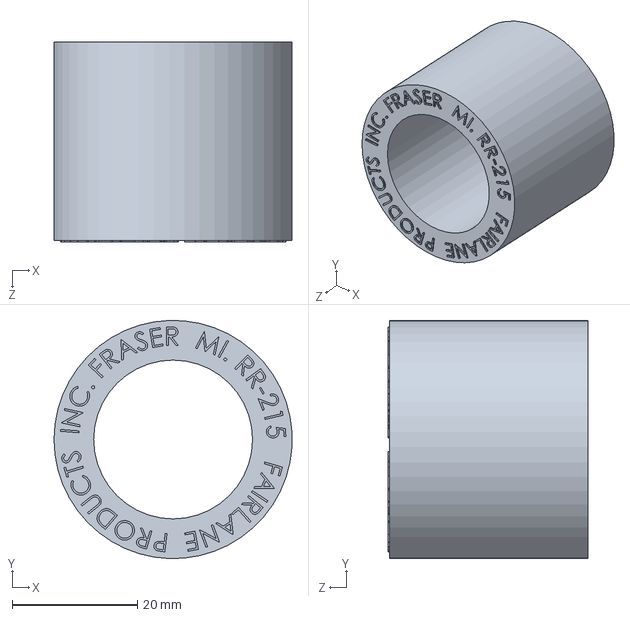
[picture p219: CAD file, 2026-11-10]
cad/native/V10V9V7V6V5rr-215-60ur-ex375_03V4.SLDPRT
38.1 x 38.1 x 32.0 mm
