OmarNeazyI/Sunnypro-automated-egg-frying-machine/cad/native/Shaft for Compression Shield.SLDPRT

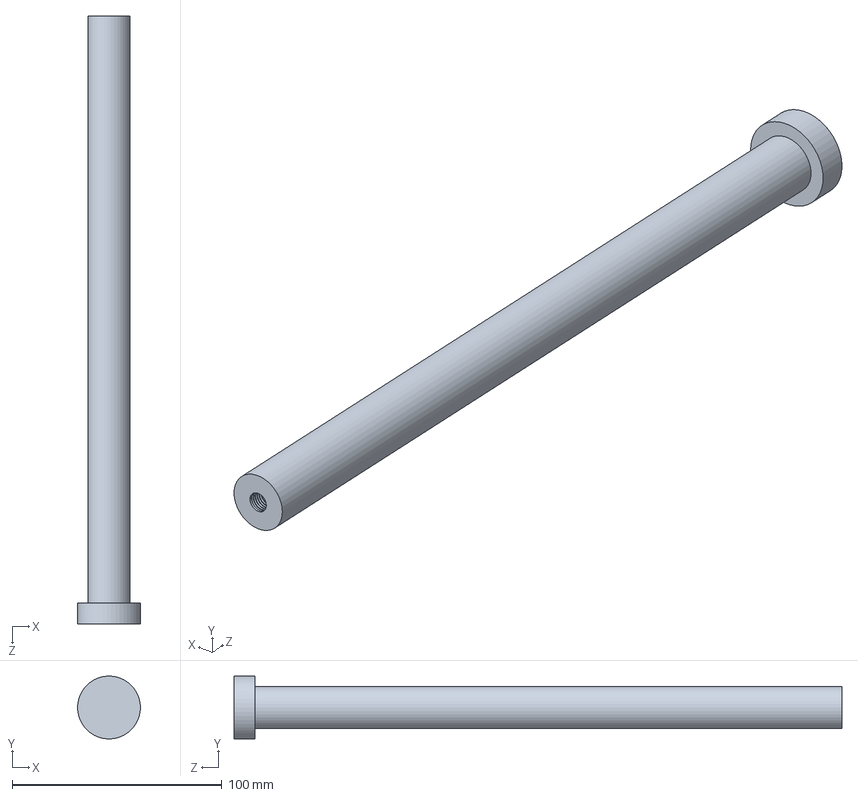
[picture p220: CAD file, 2026-11-10]
cad/native/Shaft for Compression Shield.SLDPRT
30.0 x 29.9 x 290.0 mm
