OmarNeazyI/Sunnypro-automated-egg-frying-machine/cad/native/Bottom Lottom Load Cell Plate.SLDPRT

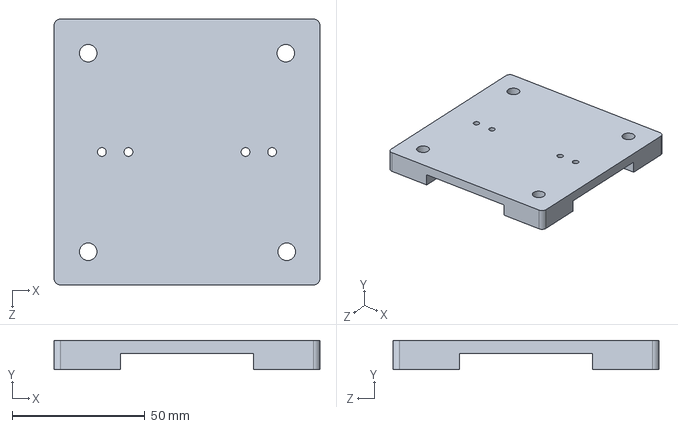
[picture p221: CAD file, 2026-11-10]
cad/native/Bottom Lottom Load Cell Plate.SLDPRT
100.0 x 11.0 x 100.0 mm
