OmarNeazyI/Sunnypro-automated-egg-frying-machine/cad/native/V10V9V7V6V5amt102-v_15.SLDPRT

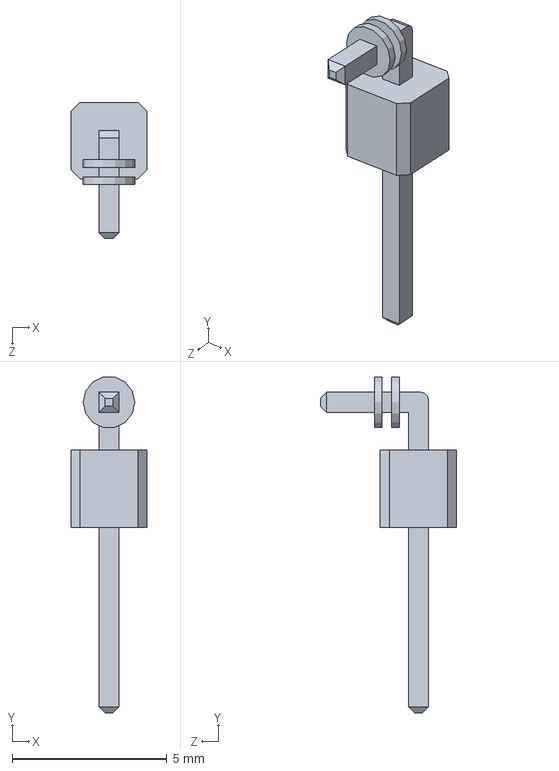
[picture p222: CAD file, 2026-11-10]
cad/native/V10V9V7V6V5amt102-v_15.SLDPRT
2.47 x 10.9 x 4.41 mm
