OmarNeazyI/Sunnypro-automated-egg-frying-machine/cad/native/18T Sprocket.SLDPRT

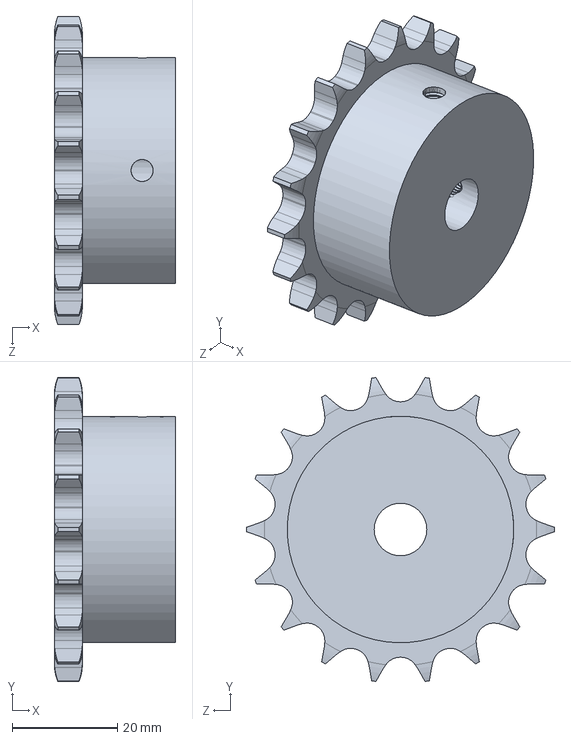
[picture p223: CAD file, 2026-11-10]
cad/native/18T Sprocket.SLDPRT
23.0 x 57.7 x 58.5 mm
