OmarNeazyI/Sunnypro-automated-egg-frying-machine/cad/native/V10V9V7V6V56mmBearingV4.SLDPRT

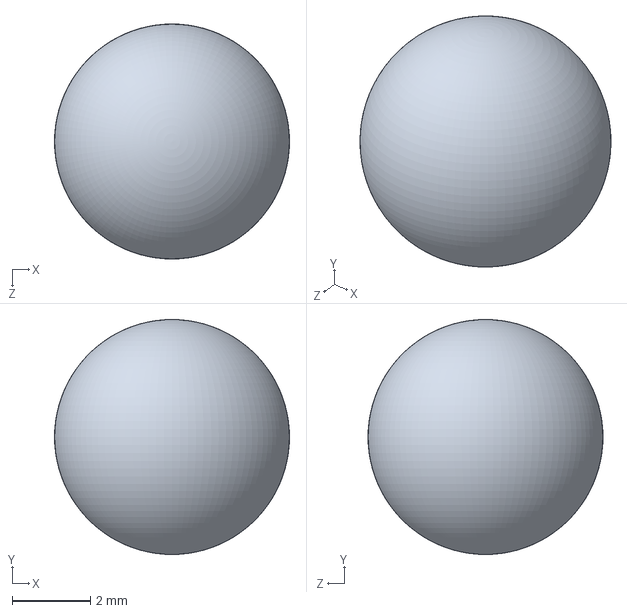
[picture p224: CAD file, 2026-11-10]
cad/native/V10V9V7V6V56mmBearingV4.SLDPRT
6.00 x 6.00 x 6.00 mm
