OmarNeazyI/Sunnypro-automated-egg-frying-machine/cad/native/V10V9V7V6V5M3x0,5 Cap NutV4.SLDPRT

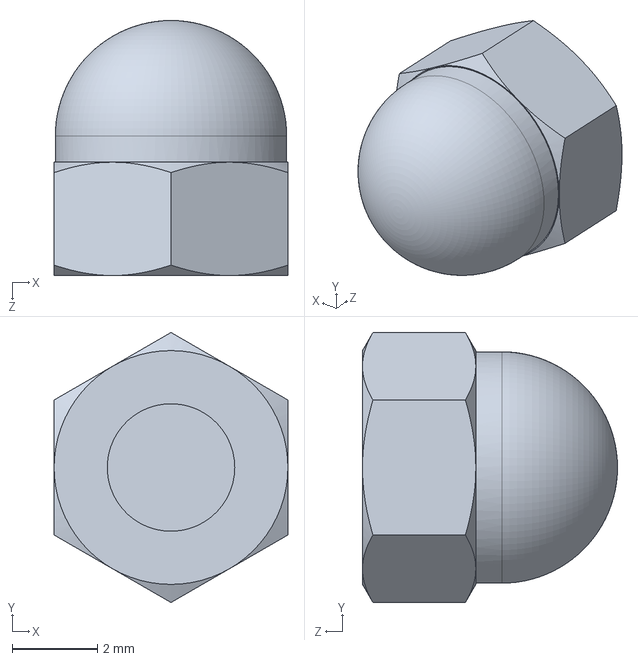
[picture p225: CAD file, 2026-11-10]
cad/native/V10V9V7V6V5M3x0,5 Cap NutV4.SLDPRT
5.50 x 6.35 x 6.00 mm
