OmarNeazyI/Sunnypro-automated-egg-frying-machine/cad/native/V10V9V7HC-ATS-0001_CSPV2-Standard check-valve.SLDPRT

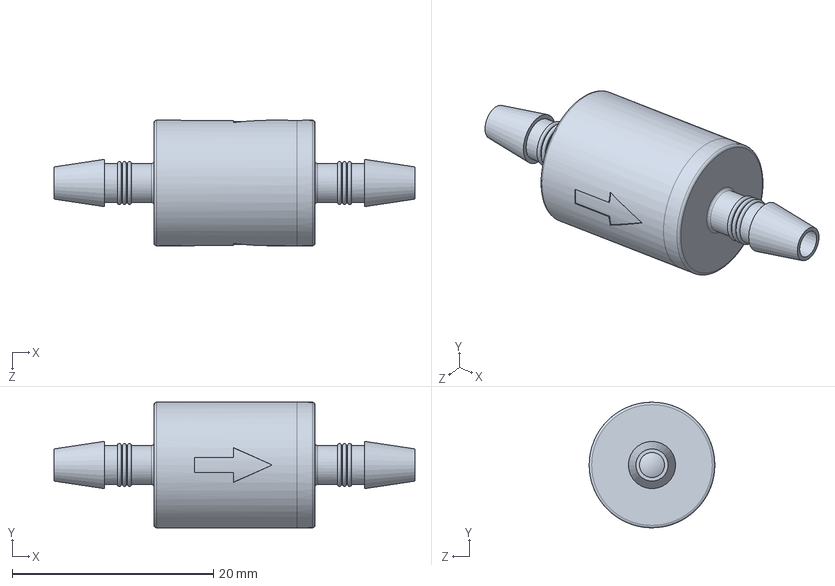
[picture p226: CAD file, 2026-11-10]
cad/native/V10V9V7HC-ATS-0001_CSPV2-Standard check-valve.SLDPRT
35.9 x 12.5 x 12.5 mm
