OmarNeazyI/Sunnypro-automated-egg-frying-machine/cad/native/V10V9V7V6V528BYJ-48 plasticV4.SLDPRT

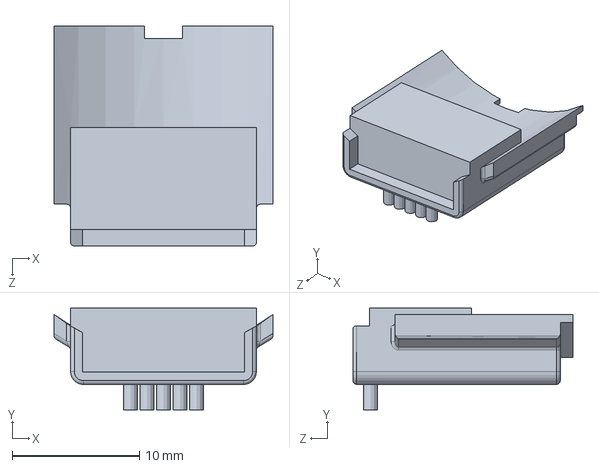
[picture p227: CAD file, 2026-11-10]
cad/native/V10V9V7V6V528BYJ-48 plasticV4.SLDPRT
17.2 x 8.00 x 17.3 mm
