OmarNeazyI/Sunnypro-automated-egg-frying-machine/cad/native/Electrical Inlet.SLDPRT

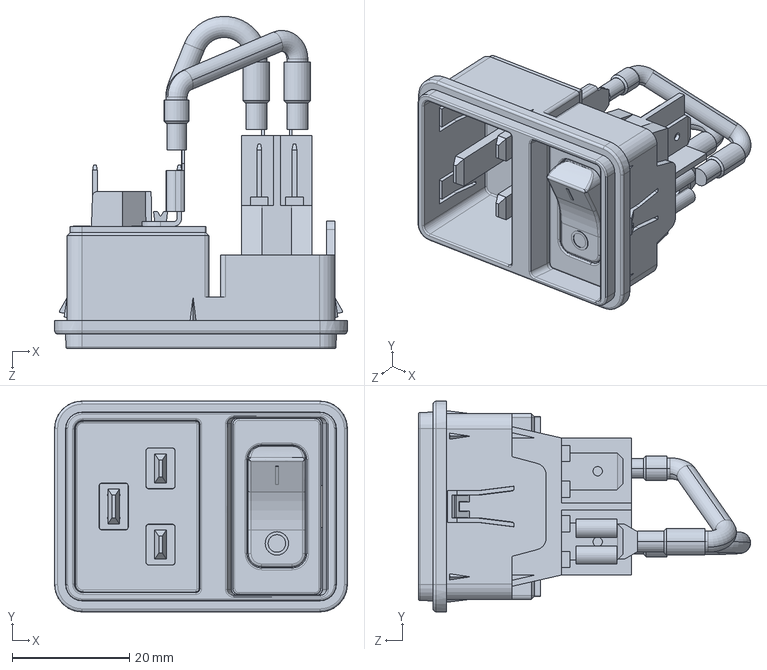
[picture p228: CAD file, 2026-11-10]
cad/native/Electrical Inlet.SLDPRT
50.0 x 36.0 x 56.7 mm
