OmarNeazyI/Sunnypro-automated-egg-frying-machine/cad/native/V10V9Power Regulation PCB.SLDPRT

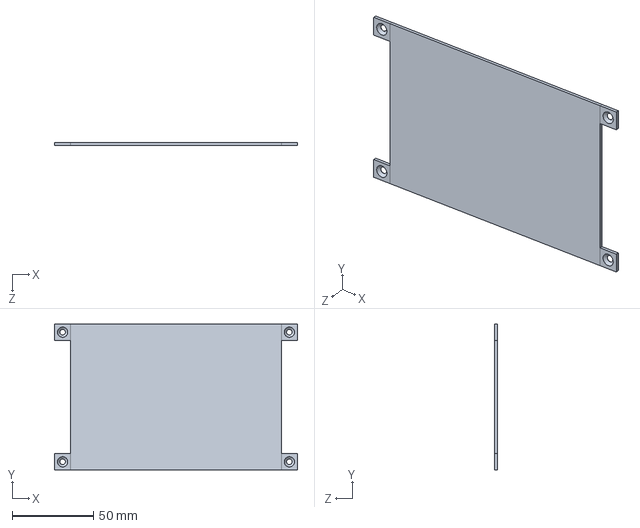
[picture p229: CAD file, 2026-11-10]
cad/native/V10V9Power Regulation PCB.SLDPRT
150.0 x 90.0 x 1.60 mm
