OmarNeazyI/Sunnypro-automated-egg-frying-machine/cad/native/V10V9V7V6V5Servo MG996RV4.SLDPRT

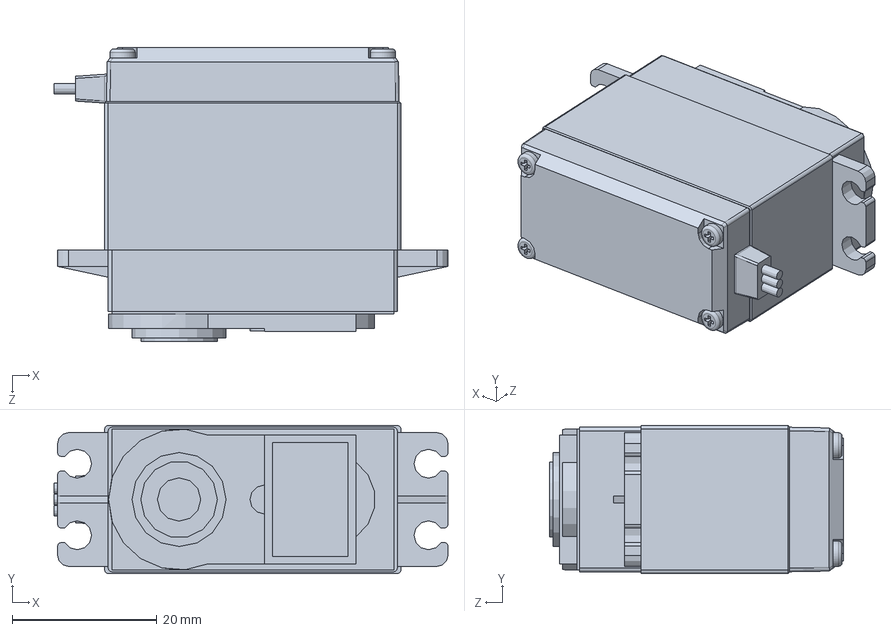
[picture p230: CAD file, 2026-11-10]
cad/native/V10V9V7V6V5Servo MG996RV4.SLDPRT
54.5 x 20.5 x 40.7 mm
