OmarNeazyI/Sunnypro-automated-egg-frying-machine/cad/native/Nema 17 Motor Casing.SLDPRT

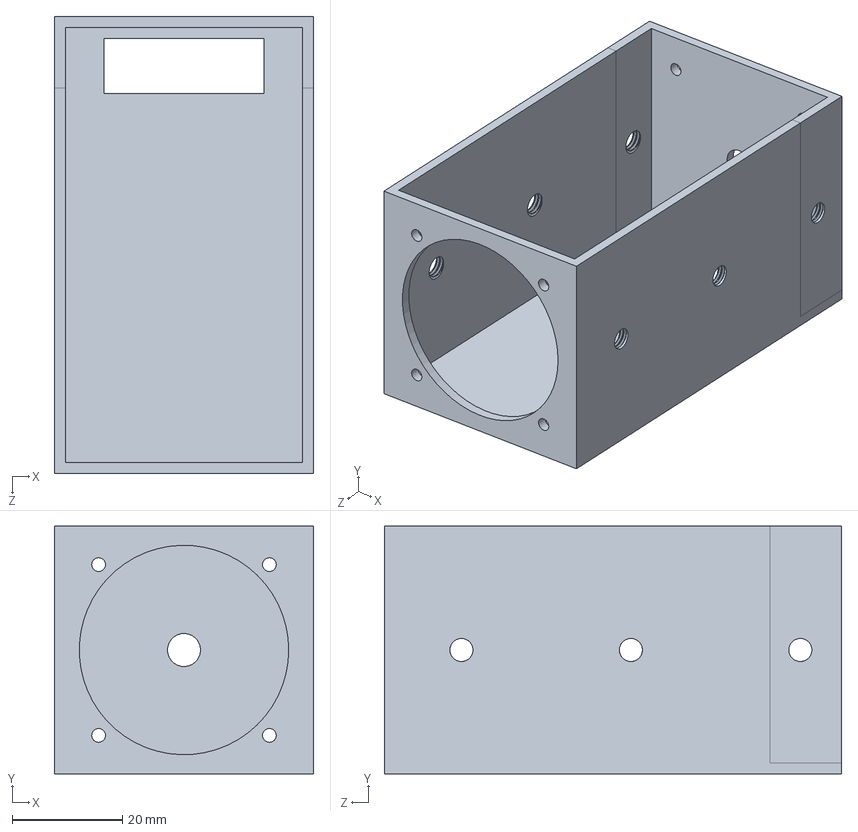
[picture p231: CAD file, 2026-11-10]
cad/native/Nema 17 Motor Casing.SLDPRT
47.0 x 45.0 x 83.0 mm
