OmarNeazyI/Sunnypro-automated-egg-frying-machine/cad/native/Aluminum Heating Block.SLDPRT

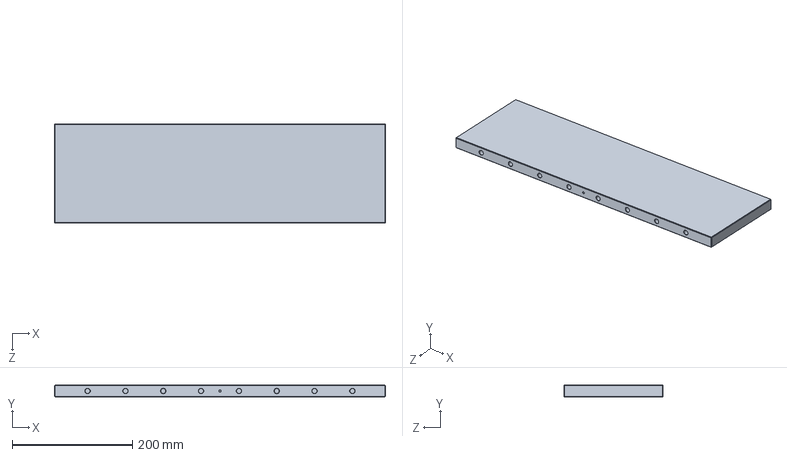
[picture p232: CAD file, 2026-11-10]
cad/native/Aluminum Heating Block.SLDPRT
550.0 x 20.0 x 165.0 mm
