OmarNeazyI/Sunnypro-automated-egg-frying-machine/cad/native/Egg Storage Unit.SLDPRT

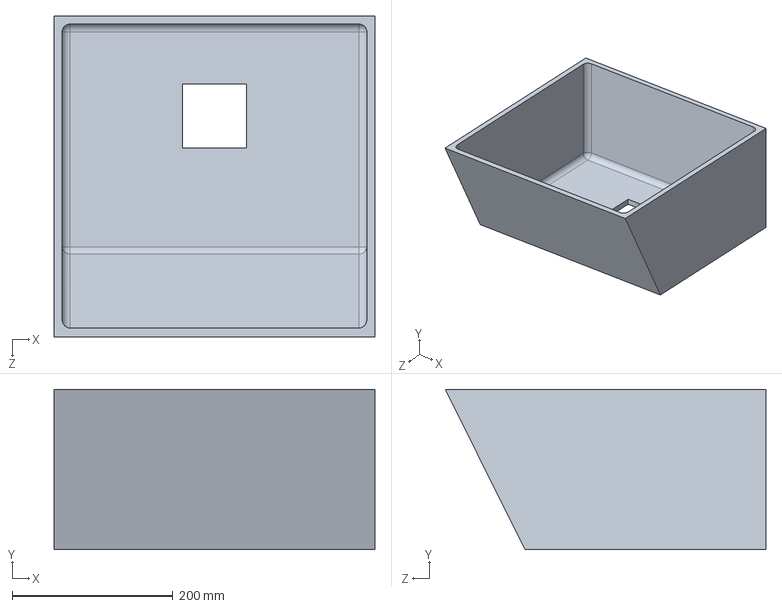
[picture p233: CAD file, 2026-11-10]
cad/native/Egg Storage Unit.SLDPRT
400.0 x 200.0 x 400.0 mm
