OmarNeazyI/Sunnypro-automated-egg-frying-machine/cad/native/V10V9V7V6V528BYJ-48 shaftV4.SLDPRT

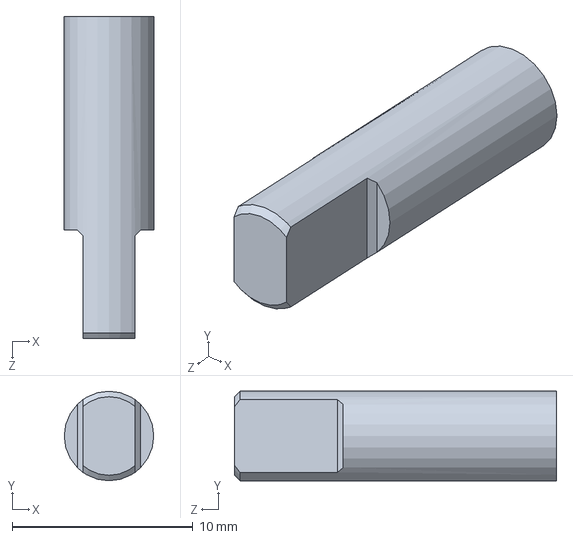
[picture p234: CAD file, 2026-11-10]
cad/native/V10V9V7V6V528BYJ-48 shaftV4.SLDPRT
4.95 x 4.95 x 17.8 mm
