OmarNeazyI/Sunnypro-automated-egg-frying-machine/cad/native/Egg Shell Storage Assembly.SLDASM

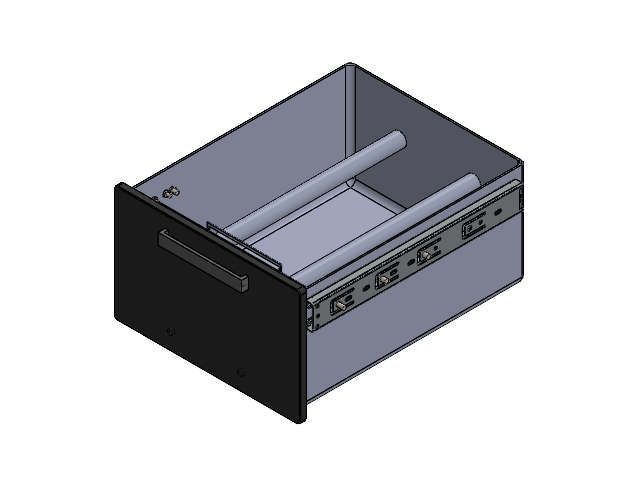
[picture p236: CAD file, 2026-11-10]
cad/native/Egg Shell Storage Assembly.SLDASM
V10V9V7V6V5CORREDICA EXTERNAV4 x 2
V10V9V7V6V5CORREDICA INTERNOV4 x 2
V10V9V7V6V5CORREDICA DO MEIOV4 x 2
countersunk flat head cross recess screw_iso x 4
V10V9V7V6V5Egg shell storage unitV4
pan head cross recess screw_iso x 15
hex thin nut gradeb_iso x 10
Shaft for Compression Shield x 2
Plastic Front Cover for Drawer
Compression Shield Sheet
Storage Handle for Drawer
