OmarNeazyI/Sunnypro-automated-egg-frying-machine/cad/native/Actuator + Sensor Interface PCB assemm.SLDASM

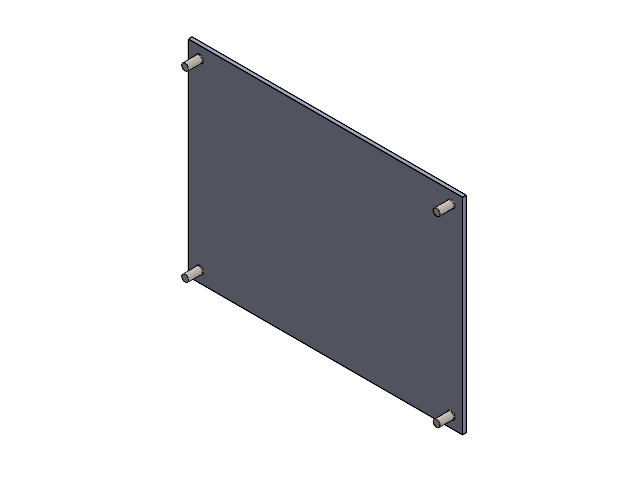
[picture p237: CAD file, 2026-11-10]
cad/native/Actuator + Sensor Interface PCB assemm.SLDASM
V10V9Actuator + Sensor Interface PCB
countersunk flat head cross recess screw_iso x 4
