OmarNeazyI/Sunnypro-automated-egg-frying-machine/cad/native/FInal Assembly of Tunnel and Gates.SLDASM

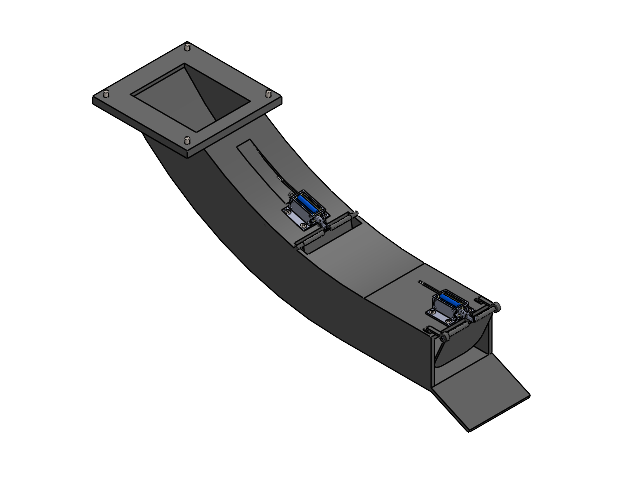
[picture p238: CAD file, 2026-11-10]
cad/native/FInal Assembly of Tunnel and Gates.SLDASM
Plastic Egg Transportation Tunnel
Plastic Gate x 2
Solenoid Motor Housing x 2
V10V9V7V6V5CoilV4 x 2
V10V9V7V6V5PlungerV4 x 2
V10V9V7V6V5O-RingV4 x 2
V10V9V7V6V5M3x0,5 Cap NutV4 x 2
V10V9V7V6V5CirclipV4 x 2
V10V9V7V6V5SpringV4 x 2
socket countersunk head screw_iso x 8
Mount for Gate x 2
Shaft for Gate x 4
countersunk flat head cross recess screw_iso
pan head cross recess screw_iso x 4
