OmarNeazyI/Sunnypro-automated-egg-frying-machine/cad/native/Full Rail Asembly 2.SLDASM

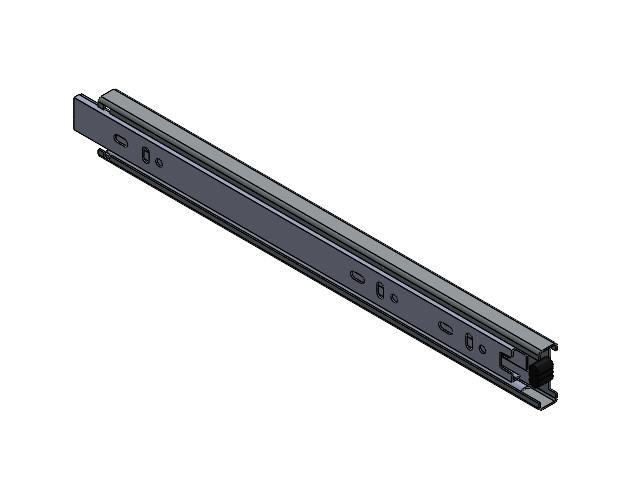
[picture p239: CAD file, 2026-11-10]
cad/native/Full Rail Asembly 2.SLDASM
V10V9V7V6V5CORREDICA EXTERNAV4
V10V9V7V6V5CORREDICA INTERNOV4
V10V9V7V6V5CORREDICA DO MEIOV4
countersunk flat head cross recess screw_iso x 2
