OmarNeazyI/Sunnypro-automated-egg-frying-machine/cad/native/Mounting Bracket.SLDASM

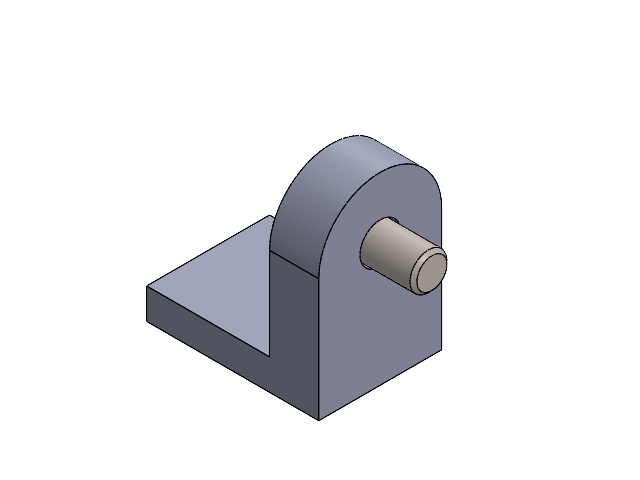
[picture p240: CAD file, 2026-11-10]
cad/native/Mounting Bracket.SLDASM
Brackets for heating block
socket head cap screw_iso
