OmarNeazyI/Sunnypro-automated-egg-frying-machine/cad/native/PT100. Sensor.SLDASM

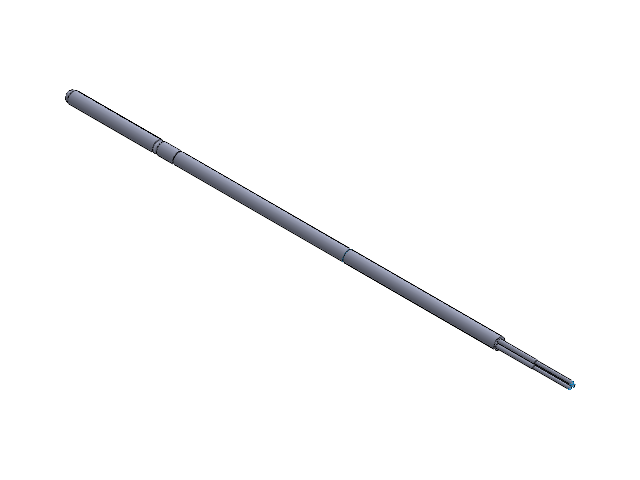
[picture p241: CAD file, 2026-11-10]
cad/native/PT100. Sensor.SLDASM
PT100 Sensor
PT100 Sensor Wires
