OmarNeazyI/Sunnypro-automated-egg-frying-machine/cad/native/Full Case Assembly.SLDASM

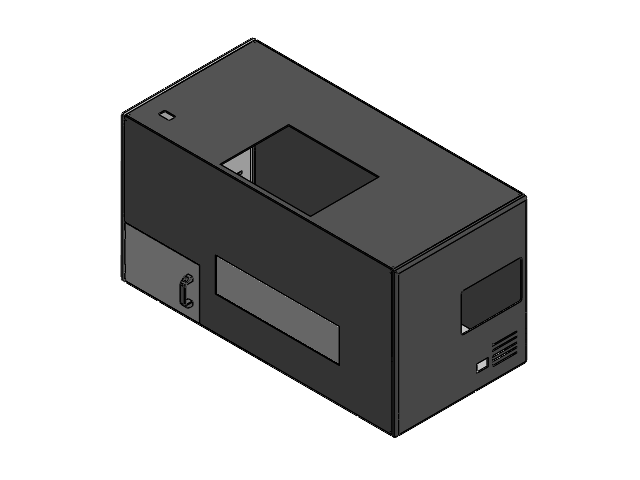
[picture p242: CAD file, 2026-11-10]
cad/native/Full Case Assembly.SLDASM
Plastic Back Panel
Plastic Bottom Panel
Plastic Door for User
Left Side Plastic Panel With Glass
Plastic Front Panel with Glass
Shaft for Door
Plastic Side Panel Right
eBom-prt0.stp
Top Case Plastic Panel
pan head cross recess screw_iso x 2
hex nut style 2 gradeab_iso x 2
