OmarNeazyI/Sunnypro-automated-egg-frying-machine/cad/native/Hinge Mount Assembly for Gates.SLDASM

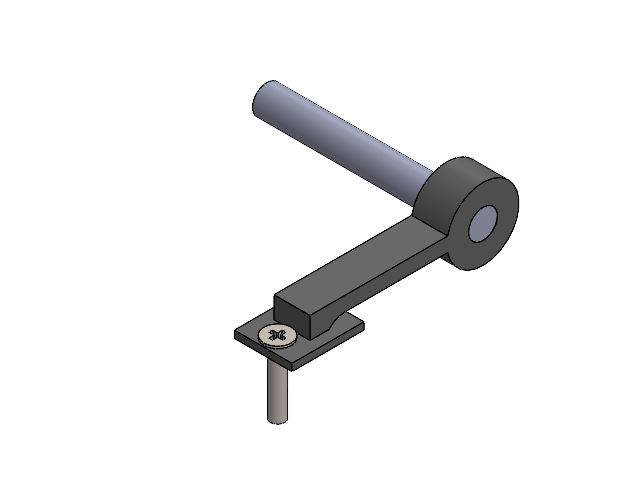
[picture p243: CAD file, 2026-11-10]
cad/native/Hinge Mount Assembly for Gates.SLDASM
Mount for Gate
Shaft for Gate
countersunk flat head cross recess screw_iso
