OmarNeazyI/Sunnypro-automated-egg-frying-machine/cad/native/Electrical Box Full Assembly.SLDASM

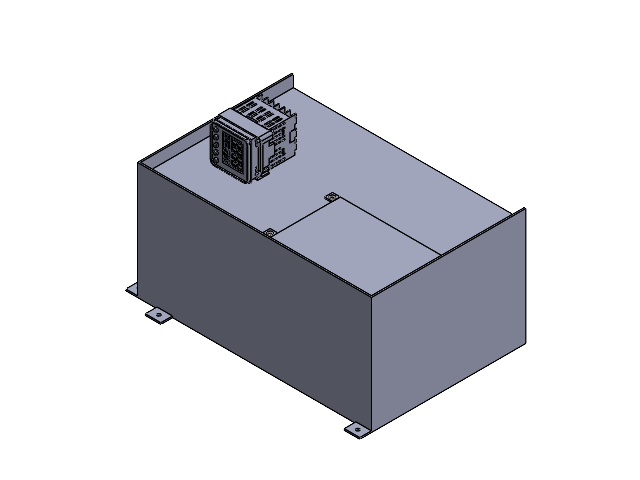
[picture p244: CAD file, 2026-11-10]
cad/native/Electrical Box Full Assembly.SLDASM
Make Electrical Box
V10V9Power Regulation PCB
countersunk flat head cross recess screw_iso x 16
hex nut style 1 gradeab_iso x 4
V10V9Actuator + Sensor Interface PCB
V10V9Motion + Load Cell PCB
V10V9Temperature Measurement PCB
E5CC_PACKING.step
Y92F_49.step
E5CC_BASE.step
V10V9Main Relay Body
V10V9Square Washer, Large x 2
V10V9Square Washer, Small x 2
pan head cross recess screw_iso x 4
