OmarNeazyI/Sunnypro-automated-egg-frying-machine/cad/native/Rotating Plate Stepper Motor.SLDASM

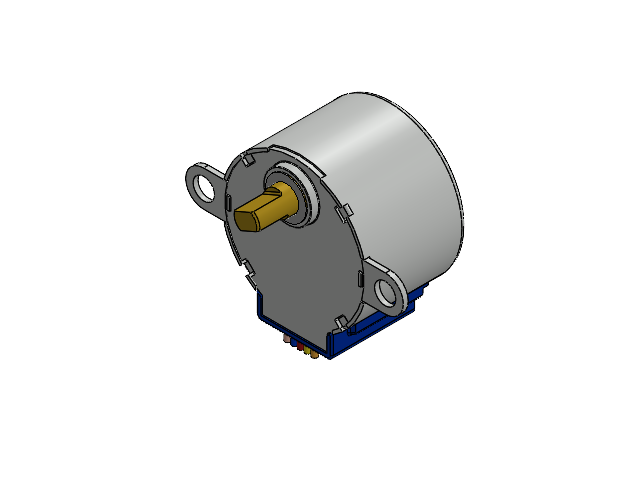
[picture p245: CAD file, 2026-11-10]
cad/native/Rotating Plate Stepper Motor.SLDASM
V10V9V7V6V528BYJ-48 bodyV4
V10V9V7V6V528BYJ-48 cover plateV4
V10V9V7V6V5Teflon D8d5V4
V10V9V7V6V528BYJ-48 shaftV4
V10V9V7V6V528BYJ-48 plasticV4
