OmarNeazyI/Sunnypro-automated-egg-frying-machine/cad/native/V10V9V7V6V5Double Sided Chain With PLates Assembly.SLDASM

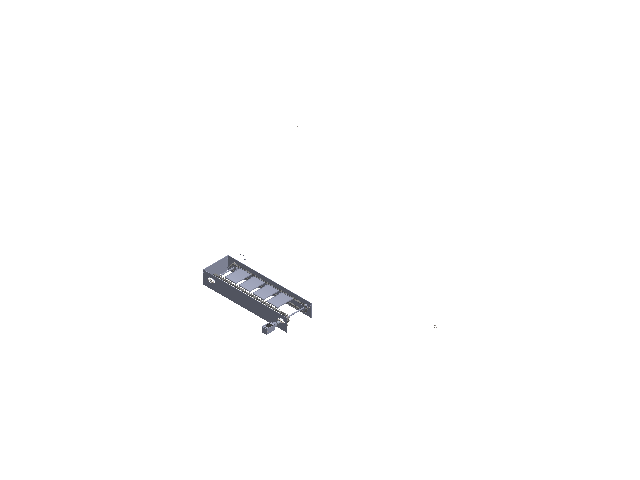
[picture p246: CAD file, 2026-11-10]
cad/native/V10V9V7V6V5Double Sided Chain With PLates Assembly.SLDASM
2106-18 with Screwkeyway x 4
Drivingshaft
Idlersupportshaft
KFL000 bearing unit 10mm x 4
Sideframe
stepper_am17hdb410-02n_01
stepper_am17hdb410-02n_02
amt102-v_01
amt102-v_02
amt102-v_04
amt102-v_05
amt102-v_06
amt102-v_07
amt102-v_08
amt102-v_09
amt102-v_10
amt102-v_11
amt102-v_12
amt102-v_13
amt102-v_14
amt102-v_15
edittedecnoderpart
Planetary271Gearbox file
Flexible Coupler Body
Set Screw M4x6mm x 4
Motor Casing
countersunk flat head cross recess screw_iso x 6
Backframe
Final Conveyer Plates x 4
smCO magnet x 3
socket head cap screw_iso x 17
torque nut 03_iso x 8
plain washer normal grade a_iso x 8
socket set screw cup point_iso x 8
hex thin nut gradeb_iso x 8
MirrorSideframe
