OmarNeazyI/Sunnypro-automated-egg-frying-machine/cad/native/Adjustable Foot (500kg) M10 x 60mm x 50Dia (302-3309).SLDASM

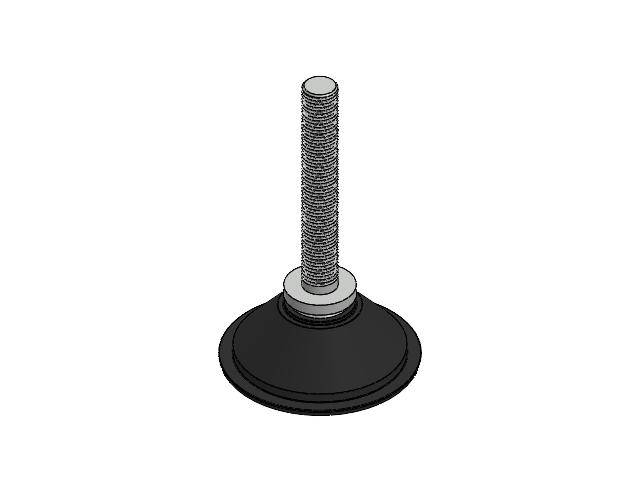
[picture p247: CAD file, 2026-11-10]
cad/native/Adjustable Foot (500kg) M10 x 60mm x 50Dia (302-3309).SLDASM
V10V9V7V6Foot 50mm Dia x 20Deg Articulation
V10V9V7V6Ball Adjuster Rod 60mm Long 57mm Thread
