OmarNeazyI/Sunnypro-automated-egg-frying-machine/cad/native/One Sided Chain With Sprockets Assembly.SLDASM

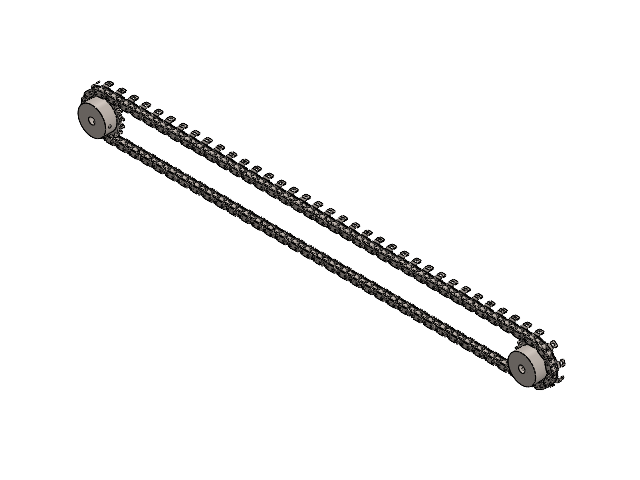
[picture p248: CAD file, 2026-11-10]
cad/native/One Sided Chain With Sprockets Assembly.SLDASM
Chainlink2with x 79
V10V9V7V6V510100001_01 x 79
V10V9V7V6V510100001_02 x 79
V10V9V7V6V510100001_03 x 158
18T Sprocket x 2
