OmarNeazyI/Sunnypro-automated-egg-frying-machine/cad/native/V10V9V7V6V5Main Assembly-OV67.SLDASM

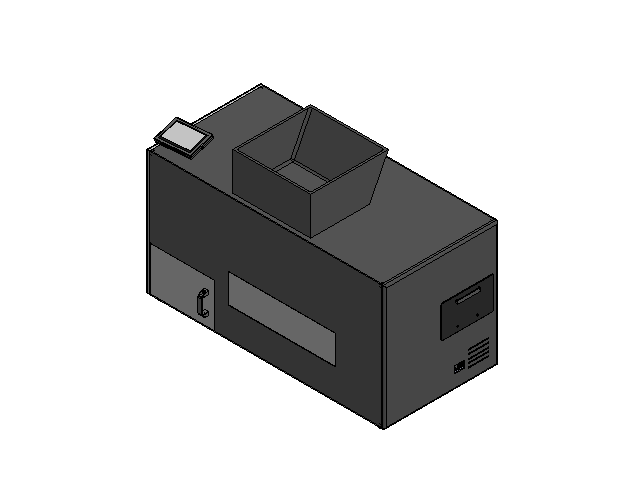
[picture p249: CAD file, 2026-11-10]
cad/native/V10V9V7V6V5Main Assembly-OV67.SLDASM
V10V9V7V6V5Main Frame OmarV4
V10V9V7V6V5Frame Under ConveyorV4
V10V9V7V6V5Bottom Base for Rotating PLateV4
V10V9V7V6V5rr-215-60ur-ex375_01V4
V10V9V7V6V5rr-215-60ur-ex375_02V4
V10V9V7V6V5rr-215-60ur-ex375_03V4
V10V9V7V6V5rr-215-60ur-ex375_04V4
V10V9V7V6V5rr-215-60ur-ex375_05V4
V10V9V7V6V5SteelPlateV4
V10V9V7V6V5RubberwheelshaftV4
V10V9V7V6V5baseplateV4
V10V9V7V6V5shaftcouplerV4
V10V9V7V6V528BYJ-48 bodyV4
V10V9V7V6V528BYJ-48 cover plateV4
V10V9V7V6V5Teflon D8d5V4
V10V9V7V6V528BYJ-48 shaftV4
V10V9V7V6V528BYJ-48 plasticV4
V10V9V7V6V56mmBearingV4 x 28
V10V9V7V6V5HalfLazySusanV4 x 2
V10V9V7V6V5Copy of CaseV4
V10V9V7V6V5Copy of ButtonV4
V10V9V7V6V5Copy of LeverV4
V10V9V7V6V5LoadCellV4
V10V9V7V6V5TopplateforLoadCellV4
V10V9V7V6V5BottomLoadCell+BasePlateV4
V10V9V7V6V5MicroswitchhousingV4
V10V9V7V6V5StepperMotor HousingV4
socket head cap screw_iso x 22
hex thin nut gradeb_iso x 45
pan head cross recess screw_iso x 52
countersunk flat head cross recess screw_iso x 39
socket countersunk head screw_iso x 14
V10V9V7V6V5TOP IR shieldingV4
V10V9V7V6V5Ceramic blockV4 x 2
V10V9V7V6V5Model for Insert of IR tubeV4
V10V9V7V6V5Lining for meshV4 x 2
V10V9V7V6V5Back of shieldingV4
V10V9V7V6V5Meshing for TOP IRV4
V10V9V7V6V5L bracket for servo motorV4 x 4
V10V9V7V6V5HandV4
V10V9V7V6V5Shaft of handV4
V10V9V7V6V5Servo MG996RV4
V10V9V7V6V5Servo MG996R ShaftV4
V10V9V7V6V5Servo MG996R arm01V4
V10V9V7V6V5Nema Motor MountV4
countersunk raised head cross recess screw_iso x 12
V10V9V7V6V58412ngmV4 x 2
V10V9V7V6V5CORREDICA EXTERNAV4 x 2
V10V9V7V6V5CORREDICA INTERNOV4 x 2
V10V9V7V6V5CORREDICA DO MEIOV4 x 2
V10V9V7V6V5Egg shell storage unitV4
V10V9V7V6V5Shaft For Compression ShieldV4 x 2
V10V9V7V6V5Front Cover For DrawerV4
V10V9V7V6V5Compression ShieldV4
V10V9V7V6V5Storage HandleV4
V10V9V7V6V5Nextion 7-Inch-DisplayV4
V10V9V7V6V5Plastic Back plate for Display PCBV4
V10V9V7V6V5Plastic Top Case for ScreenV4
plain washer 10673 type snl_iso x 2
V10V9V7V6V5R19C2006A01_050_FS18-2V4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
