OmarNeazyI/Sunnypro-automated-egg-frying-machine/cad/native/V10V9V7V6main frame with assem.SLDASM

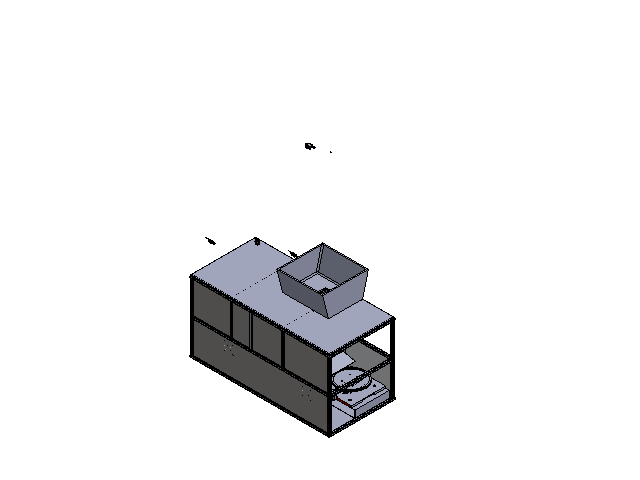
[picture p250: CAD file, 2026-11-10]
cad/native/V10V9V7V6main frame with assem.SLDASM
main frame
Hand
Shaft of hand
egg storage unit
base of spear
spear hand left x 2
Part1^main frame with assem
Egg shel storage unit
shaft and shield
Servo MG996R
Servo MG996R Shaft
Servo MG996R arm01
pan head cross recess screw_iso x 5
hex screw gradeab_iso x 2
hex nut style 1 gradeab_iso x 3
wedge
Coil x 4
Plunger x 4
O-Ring x 4
M3x0,5 Cap Nut x 4
Circlip x 4
Spring x 4
2106-18 with Screwkeyway x 4
Drivingshaft
Idlersupportshaft
KFL000 bearing unit 10mm x 4
Sideframe
Backframe
stepper_am17hdb410-02n_01
stepper_am17hdb410-02n_02
amt102-v_01
amt102-v_02
amt102-v_04
amt102-v_05
amt102-v_06
amt102-v_07
amt102-v_08
amt102-v_09
amt102-v_10
amt102-v_11
amt102-v_12
amt102-v_13
amt102-v_14
amt102-v_15
edittedecnoderpart
Planetary271Gearbox file
Flexible Coupler Body
Set Screw M4x6mm x 4
Motor Casing
countersunk flat head cross recess screw_iso x 14
Final Conveyer Plates x 4
socket head cap screw_iso x 26
torque nut 03_iso x 8
plain washer normal grade a_iso x 8
socket set screw cup point_iso x 8
hex thin nut gradeb_iso x 25
MirrorSideframe
rr-215-60ur-ex375_01
rr-215-60ur-ex375_02
rr-215-60ur-ex375_03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
