OmarNeazyI/Sunnypro-automated-egg-frying-machine/cad/native/Main Assembly.SLDASM

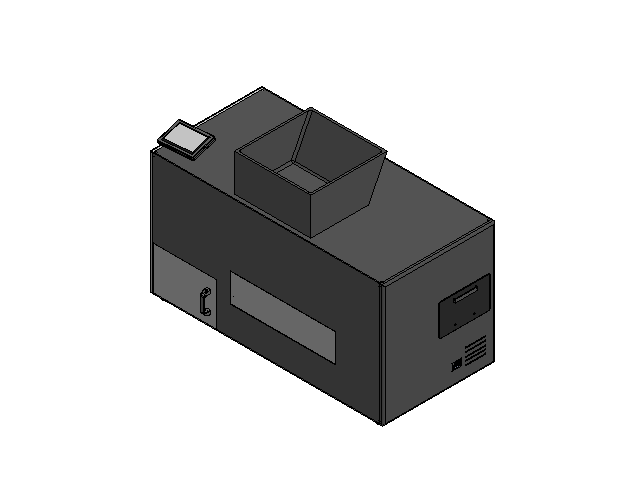
[picture p251: CAD file, 2026-11-10]
cad/native/Main Assembly.SLDASM
Main Steel Frame
Bottom Frame Under Conveyor
Bottom Frame for Rotating Plate
V10V9V7V6V5rr-215-60ur-ex375_01V4
V10V9V7V6V5rr-215-60ur-ex375_02V4
V10V9V7V6V5rr-215-60ur-ex375_03V4
V10V9V7V6V5rr-215-60ur-ex375_04V4
V10V9V7V6V5rr-215-60ur-ex375_05V4
Rotating Top Steel Plate
Rubber Wheel Shaft
Main Base Plate
Flexible Shaft Coupler (RP)
V10V9V7V6V528BYJ-48 bodyV4
V10V9V7V6V528BYJ-48 cover plateV4
V10V9V7V6V5Teflon D8d5V4
V10V9V7V6V528BYJ-48 shaftV4
V10V9V7V6V528BYJ-48 plasticV4
V10V9V7V6V56mmBearingV4 x 28
V10V9V7V6V5HalfLazySusanV4 x 2
V10V9V7V6V5Copy of CaseV4
V10V9V7V6V5Copy of ButtonV4
V10V9V7V6V5Copy of LeverV4
Load Cell Sensor
Top Plate for Load Cell
Bottom Lottom Load Cell Plate
Microswitch Mount
Rotating Plate Stepper Motor Mount
socket head cap screw_iso x 22
hex thin nut gradeb_iso x 45
pan head cross recess screw_iso x 52
countersunk flat head cross recess screw_iso x 39
socket countersunk head screw_iso x 14
TOP IR shielding
Ceramic block x 2
Quartz Insert of IR tube
Lining for mesh x 2
Back of shielding
Meshing for TOP IR
L bracket for servo motor x 4
Breaking Mech Hand
Shaft for Hand
V10V9V7V6V5Servo MG996RV4
V10V9V7V6V5Servo MG996R ShaftV4
V10V9V7V6V5Servo MG996R arm01V4
Nema 17 Motor Mount
8412ngmV4 x 2
V10V9V7V6V5CORREDICA EXTERNAV4 x 2
V10V9V7V6V5CORREDICA INTERNOV4 x 2
V10V9V7V6V5CORREDICA DO MEIOV4 x 2
V10V9V7V6V5Egg shell storage unitV4
Shaft for Compression Shield x 2
Plastic Front Cover for Drawer
Compression Shield Sheet
Storage Handle for Drawer
Nextion 7inch Display
Plastic Back Plate for Display
Plastic Top Plate for Display
plain washer 10673 type snl_iso x 2
V10V9V7V6V5R19C2006A01_050_FS18-2V4
V10V9V7V6V5M6DIN985A2V4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
