OmarNeazyI/Sunnypro-automated-egg-frying-machine/cad/native/Solenoid Motor (5JF-0530B).SLDASM

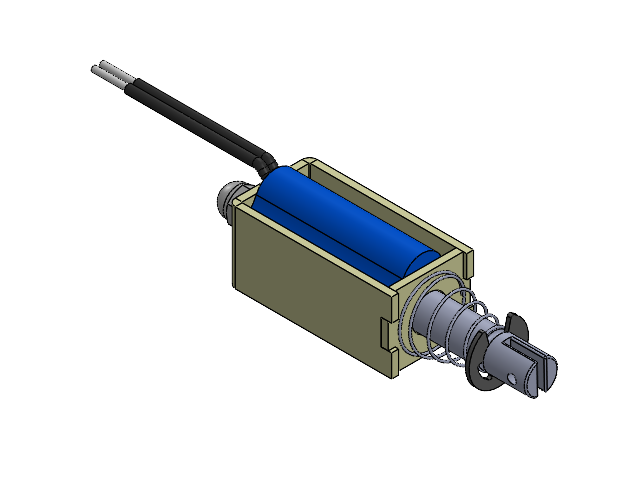
[picture p252: CAD file, 2026-11-10]
cad/native/Solenoid Motor (5JF-0530B).SLDASM
V10V9V7V6V5CoilV4
V10V9V7V6V5PlungerV4
V10V9V7V6V5O-RingV4
V10V9V7V6V5M3x0,5 Cap NutV4
V10V9V7V6V5CirclipV4
V10V9V7V6V5SpringV4
