OmarNeazyI/Sunnypro-automated-egg-frying-machine/cad/native/Microswitch Assembly.SLDASM

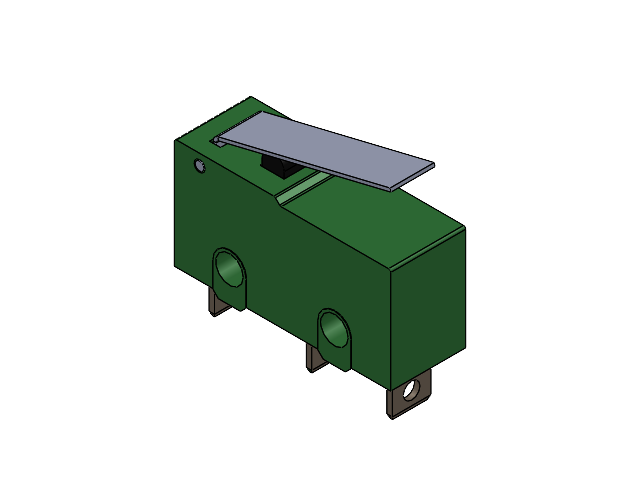
[picture p253: CAD file, 2026-11-10]
cad/native/Microswitch Assembly.SLDASM
V10V9V7V6V5Copy of CaseV4
V10V9V7V6V5Copy of ButtonV4
V10V9V7V6V5Copy of LeverV4
