OmarNeazyI/Sunnypro-automated-egg-frying-machine/cad/native/SSR.SLDASM

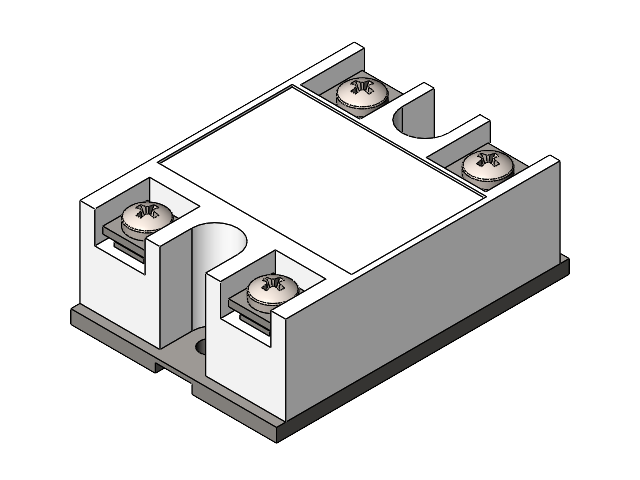
[picture p254: CAD file, 2026-11-10]
cad/native/SSR.SLDASM
V10V9Main Relay Body
V10V9Square Washer, Large x 2
V10V9Square Washer, Small x 2
pan head cross recess screw_iso x 4
