OmarNeazyI/Sunnypro-automated-egg-frying-machine/cad/native/Encoder+Motor+Gearbox Assembly+ShaftCouplerforconveyor.SLDASM

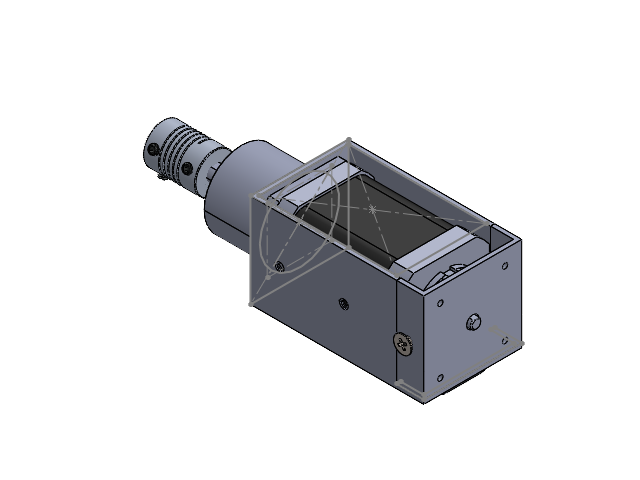
[picture p255: CAD file, 2026-11-10]
cad/native/Encoder+Motor+Gearbox Assembly+ShaftCouplerforconveyor.SLDASM
V10V9V7V6V5stepper_am17hdb410-02n_01
V10V9V7V6V5stepper_am17hdb410-02n_02
V10V9V7V6V5amt102-v_01
V10V9V7V6V5amt102-v_02
V10V9V7V6V5amt102-v_04
V10V9V7V6V5amt102-v_05
V10V9V7V6V5amt102-v_06
V10V9V7V6V5amt102-v_07
V10V9V7V6V5amt102-v_08
V10V9V7V6V5amt102-v_09
V10V9V7V6V5amt102-v_10
V10V9V7V6V5amt102-v_11
V10V9V7V6V5amt102-v_12
V10V9V7V6V5amt102-v_13
V10V9V7V6V5amt102-v_14
V10V9V7V6V5amt102-v_15
V10V9V7V6V5edittedecnoderpart
Planetary 1 to 27 Gearbox
V10V9V7V6V5Flexible Coupler Body
V10V9V7V6V5Set Screw M4x6mm x 4
Nema 17 Motor Casing
countersunk flat head cross recess screw_iso x 6
