OmarNeazyI/Sunnypro-automated-egg-frying-machine/cad/native/Spear Assembly.SLDASM

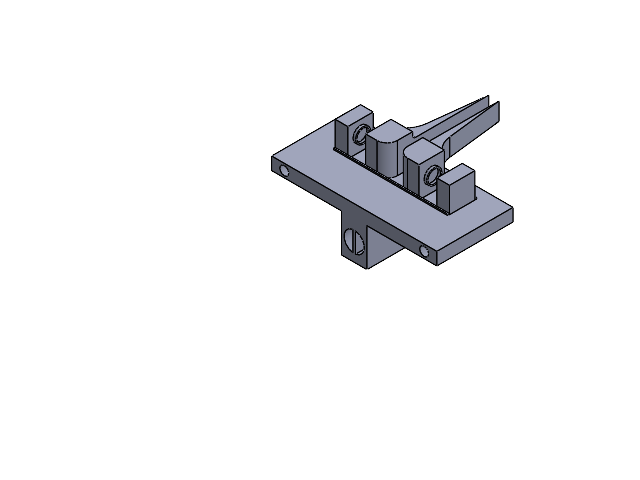
[picture p256: CAD file, 2026-11-10]
cad/native/Spear Assembly.SLDASM
Base of Spear
Spear Hands x 2
