OmarNeazyI/Sunnypro-automated-egg-frying-machine/cad/native/Full Gate Motor Assembly.SLDASM

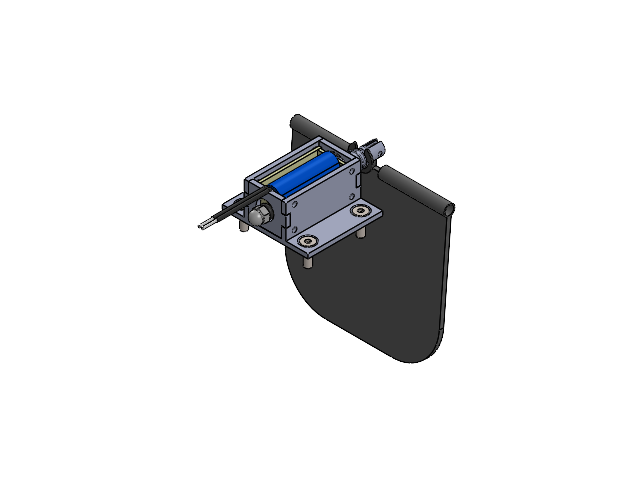
[picture p257: CAD file, 2026-11-10]
cad/native/Full Gate Motor Assembly.SLDASM
Plastic Gate
Solenoid Motor Housing
V10V9V7V6V5CoilV4
V10V9V7V6V5PlungerV4
V10V9V7V6V5O-RingV4
V10V9V7V6V5M3x0,5 Cap NutV4
V10V9V7V6V5CirclipV4
V10V9V7V6V5SpringV4
socket countersunk head screw_iso x 4
