OmarNeazyI/Sunnypro-automated-egg-frying-machine/cad/native/Spear Breaking Mechasnim and Motor Mount Assembly.SLDASM

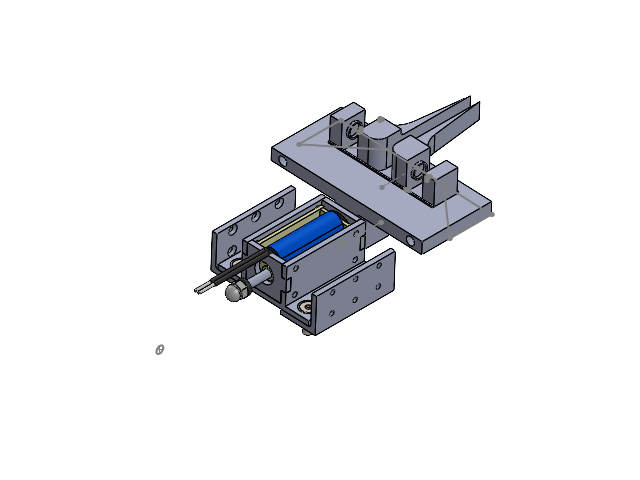
[picture p258: CAD file, 2026-11-10]
cad/native/Spear Breaking Mechasnim and Motor Mount Assembly.SLDASM
Base of Spear
Spear Hands x 2
Solenoid Motor Housing
V10V9V7V6V5CoilV4
V10V9V7V6V5PlungerV4
V10V9V7V6V5O-RingV4
V10V9V7V6V5M3x0,5 Cap NutV4
V10V9V7V6V5CirclipV4
V10V9V7V6V5SpringV4
socket countersunk head screw_iso x 4
Wide L shape Motor Housing Mount x 2
hex nut style 1 gradeab_iso x 4
