OmarNeazyI/Sunnypro-automated-egg-frying-machine/cad/native/Ball Mount for Displau assembly.SLDASM

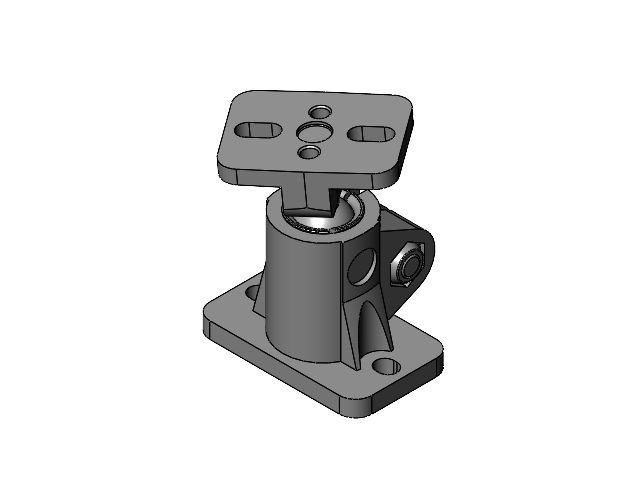
[picture p259: CAD file, 2026-11-10]
cad/native/Ball Mount for Displau assembly.SLDASM
V10V9V7V6V5R19C2006A01_050_FS18-2V4
V10V9V7V6V5M6DIN985A2V4
V10V9V7V6V5X094180_SchnoorV4
V10V9V7V6V5X094372#X094372#Zylinderschraube_M6(L20)_(FKL8.8)(ISO4762)V4
V10V9V7V6V5R19C2006A01_200V4 x 2
V10V9V7V6V5R19C2006A01_110V4
V10V9V7V6V5X094567#X094567#Zylinderschraube_M3(L6)_(FKL8.8)(DIN7984)V4
