OmarNeazyI/Sunnypro-automated-egg-frying-machine/cad/native/PCB Assembly.SLDASM

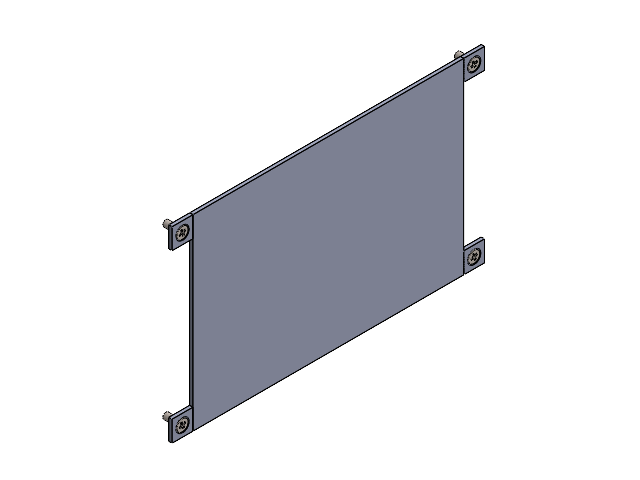
[picture p261: CAD file, 2026-11-10]
cad/native/PCB Assembly.SLDASM
V10V9Power Regulation PCB
countersunk flat head cross recess screw_iso x 4
