OmarNeazyI/Sunnypro-automated-egg-frying-machine/cad/native/Oil System parts.SLDASM

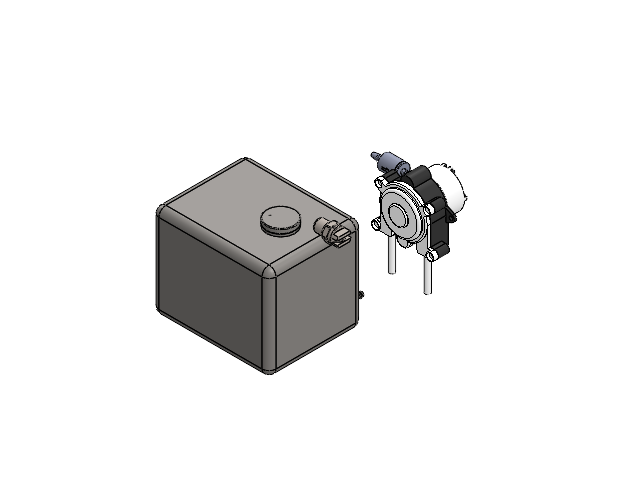
[picture p262: CAD file, 2026-11-10]
cad/native/Oil System parts.SLDASM
12V Peristaltic pump
V10V9V7HC-ATS-0001_CSPV2-Standard check-valve
Oil tank+Barbed Outlet
Tank Cap
Standard Nozzle spray
