OmarNeazyI/Sunnypro-automated-egg-frying-machine/cad/native/V10V9V7V6Frame with Heating Block Assembly.SLDASM

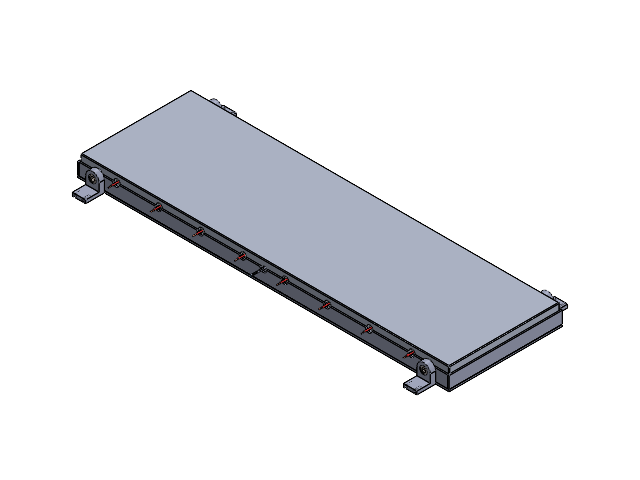
[picture p263: CAD file, 2026-11-10]
cad/native/V10V9V7V6Frame with Heating Block Assembly.SLDASM
HeatingAlumnimumblockdraft1
cartridgeheater x 8
d03523_01temp
d03523_02temp
Front and Back Heating block Frame x 2
Side Mount for Heating Block x 2
Bottom of frame
Brackets for heating block x 4
socket head cap screw_iso x 4
