OmarNeazyI/Sunnypro-automated-egg-frying-machine/cad/native/Servo Motor.SLDASM

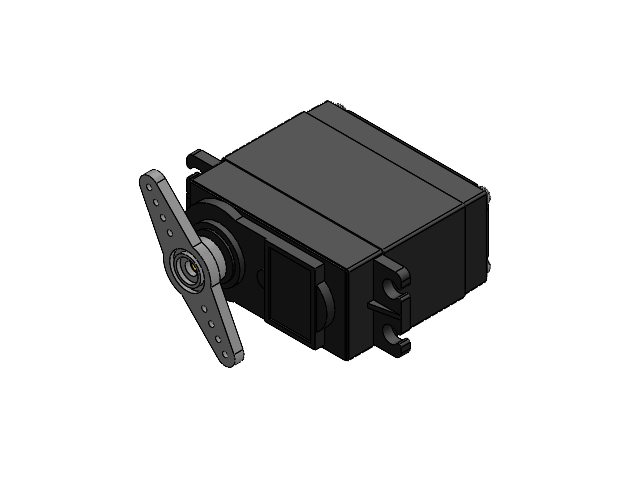
[picture p264: CAD file, 2026-11-10]
cad/native/Servo Motor.SLDASM
V10V9V7V6V5Servo MG996RV4
V10V9V7V6V5Servo MG996R ShaftV4
V10V9V7V6V5Servo MG996R arm01V4
