OmarNeazyI/Sunnypro-automated-egg-frying-machine/cad/native/Rotating Plate Assembly.SLDASM

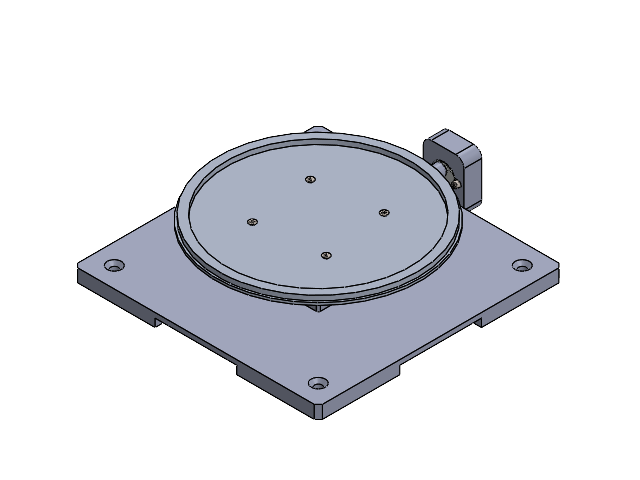
[picture p265: CAD file, 2026-11-10]
cad/native/Rotating Plate Assembly.SLDASM
V10V9V7V6V5rr-215-60ur-ex375_01V4
V10V9V7V6V5rr-215-60ur-ex375_02V4
V10V9V7V6V5rr-215-60ur-ex375_03V4
V10V9V7V6V5rr-215-60ur-ex375_04V4
V10V9V7V6V5rr-215-60ur-ex375_05V4
Rotating Top Steel Plate
Rubber Wheel Shaft
Main Base Plate
Flexible Shaft Coupler (RP)
V10V9V7V6V528BYJ-48 bodyV4
V10V9V7V6V528BYJ-48 cover plateV4
V10V9V7V6V5Teflon D8d5V4
V10V9V7V6V528BYJ-48 shaftV4
V10V9V7V6V528BYJ-48 plasticV4
V10V9V7V6V56mmBearingV4 x 28
V10V9V7V6V5HalfLazySusanV4 x 2
V10V9V7V6V5Copy of CaseV4
V10V9V7V6V5Copy of ButtonV4
V10V9V7V6V5Copy of LeverV4
Load Cell Sensor
Top Plate for Load Cell
Bottom Lottom Load Cell Plate
Microswitch Mount
Rotating Plate Stepper Motor Mount
socket head cap screw_iso x 8
hex thin nut gradeb_iso x 16
pan head cross recess screw_iso x 4
countersunk flat head cross recess screw_iso x 8
socket countersunk head screw_iso x 2
