OmarNeazyI/Sunnypro-automated-egg-frying-machine/cad/native/Bottom Heating Assembly.SLDASM

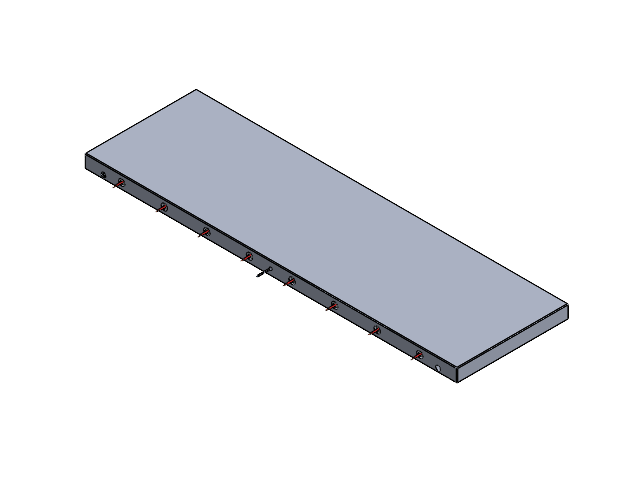
[picture p266: CAD file, 2026-11-10]
cad/native/Bottom Heating Assembly.SLDASM
Aluminum Heating Block
Cartridge Heaters x 8
PT100 Sensor
PT100 Sensor Wires
