OmarNeazyI/Sunnypro-automated-egg-frying-machine/cad/native/V10V9V5Main Assembly-OV4.SLDASM

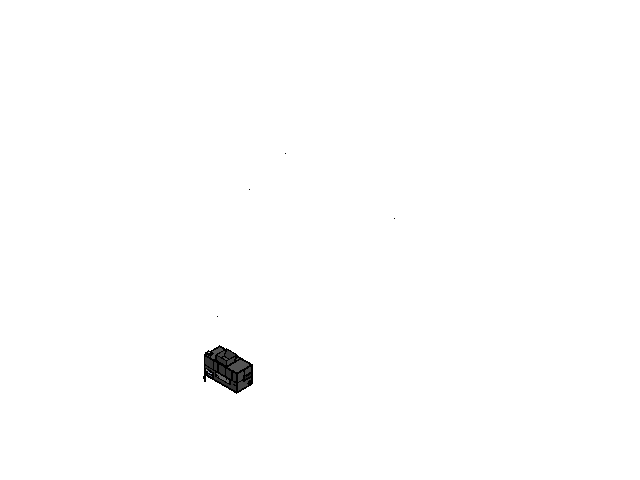
[picture p267: CAD file, 2026-11-10]
cad/native/V10V9V5Main Assembly-OV4.SLDASM
V5Main Frame OmarV4
V5Frame Under ConveyorV4
V5Bottom Base for Rotating PLateV4
V5rr-215-60ur-ex375_01V4
V5rr-215-60ur-ex375_02V4
V5rr-215-60ur-ex375_03V4
V5rr-215-60ur-ex375_04V4
V5rr-215-60ur-ex375_05V4
V5SteelPlateV4
V5RubberwheelshaftV4
V5baseplateV4
V5shaftcouplerV4
V528BYJ-48 bodyV4
V528BYJ-48 cover plateV4
V5Teflon D8d5V4
V528BYJ-48 shaftV4
V528BYJ-48 plasticV4
V56mmBearingV4 x 28
V5HalfLazySusanV4 x 2
V5Copy of CaseV4
V5Copy of ButtonV4
V5Copy of LeverV4
V5LoadCellV4
V5TopplateforLoadCellV4
V5BottomLoadCell+BasePlateV4
V5MicroswitchhousingV4
V5StepperMotor HousingV4
socket head cap screw_iso x 23
hex thin nut gradeb_iso x 46
pan head cross recess screw_iso x 49
countersunk flat head cross recess screw_iso x 24
socket countersunk head screw_iso x 14
V5TOP IR shieldingV4
V5Ceramic blockV4 x 2
V5Model for Insert of IR tubeV4
V5Lining for meshV4 x 2
V5Back of shieldingV4
V5Meshing for TOP IRV4
V5L bracket for servo motorV4 x 4
V5HandV4
V5Shaft of handV4
V5Servo MG996RV4
V5Servo MG996R ShaftV4
V5Servo MG996R arm01V4
V5Nema Motor MountV4
countersunk raised head cross recess screw_iso x 12
V58412ngmV4 x 2
V5CORREDICA EXTERNAV4 x 2
V5CORREDICA INTERNOV4 x 2
V5CORREDICA DO MEIOV4 x 2
V5Egg shell storage unitV4
V5Shaft For Compression ShieldV4 x 2
V5Front Cover For DrawerV4
V5Compression ShieldV4
V5Storage HandleV4
V5Nextion 7-Inch-DisplayV4
V5Plastic Back plate for Display PCBV4
V5Plastic Top Case for ScreenV4
plain washer 10673 type snl_iso x 2
V5R19C2006A01_050_FS18-2V4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
