OmarNeazyI/Sunnypro-automated-egg-frying-machine/cad/native/Motion + Load Cell PCB assem.SLDASM

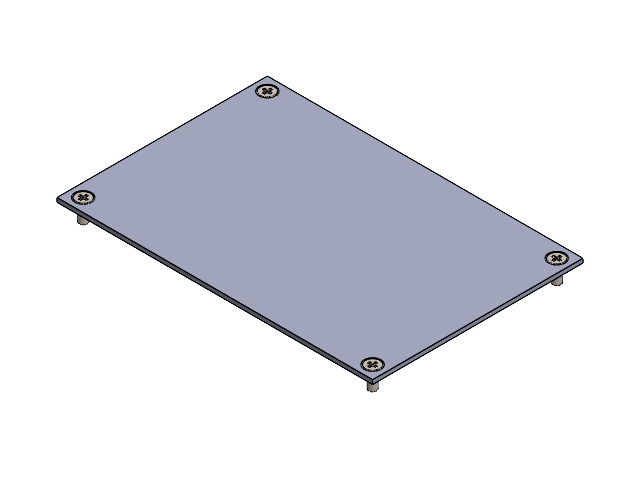
[picture p268: CAD file, 2026-11-10]
cad/native/Motion + Load Cell PCB assem.SLDASM
V10V9Motion + Load Cell PCB
countersunk flat head cross recess screw_iso x 4
