OmarNeazyI/Sunnypro-automated-egg-frying-machine/cad/native/Nema 17 Motor Assembly.SLDASM

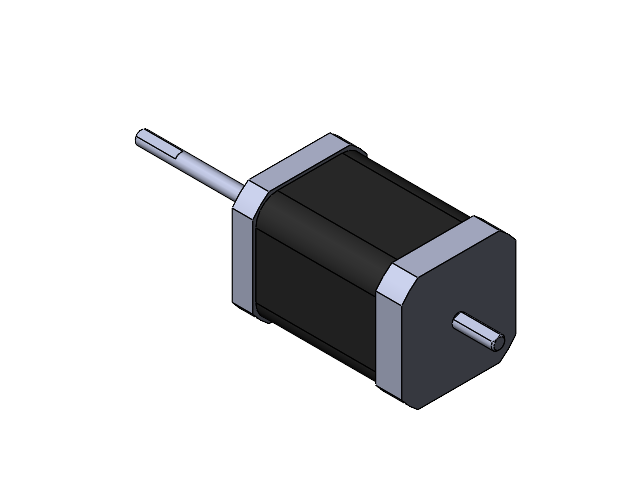
[picture p269: CAD file, 2026-11-10]
cad/native/Nema 17 Motor Assembly.SLDASM
V10V9V7V6V5stepper_am17hdb410-02n_01
V10V9V7V6V5stepper_am17hdb410-02n_02
