OmarNeazyI/Sunnypro-automated-egg-frying-machine/cad/native/Flexible Couple 5mm to 10mm.SLDASM

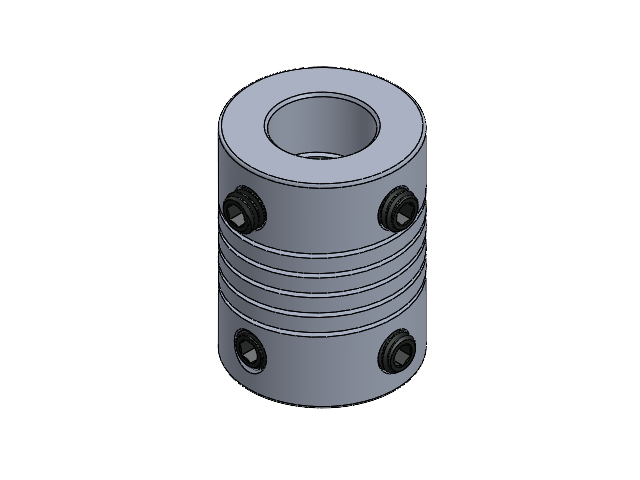
[picture p270: CAD file, 2026-11-10]
cad/native/Flexible Couple 5mm to 10mm.SLDASM
V10V9V7V6V5Flexible Coupler Body
V10V9V7V6V5Set Screw M4x6mm x 4
