OmarNeazyI/Sunnypro-automated-egg-frying-machine/cad/native/Lazy susan bearing assembly.SLDASM

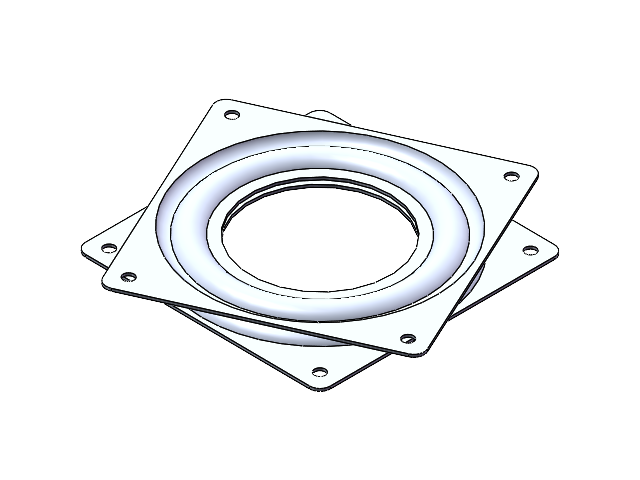
[picture p271: CAD file, 2026-11-10]
cad/native/Lazy susan bearing assembly.SLDASM
V10V9V7V6V56mmBearingV4 x 28
V10V9V7V6V5HalfLazySusanV4 x 2
