OmarNeazyI/Sunnypro-automated-egg-frying-machine/cad/native/Nema 17 Encoder Assembly.SLDASM

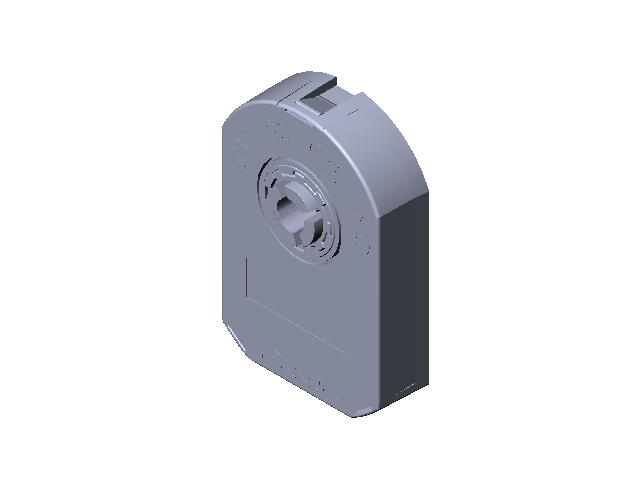
[picture p272: CAD file, 2026-11-10]
cad/native/Nema 17 Encoder Assembly.SLDASM
V10V9V7V6V5amt102-v_01
V10V9V7V6V5amt102-v_02
V10V9V7V6V5amt102-v_04
V10V9V7V6V5amt102-v_05
V10V9V7V6V5amt102-v_06
V10V9V7V6V5amt102-v_07
V10V9V7V6V5amt102-v_08
V10V9V7V6V5amt102-v_09
V10V9V7V6V5amt102-v_10
V10V9V7V6V5amt102-v_11
V10V9V7V6V5amt102-v_12
V10V9V7V6V5amt102-v_13
V10V9V7V6V5amt102-v_14
V10V9V7V6V5amt102-v_15
V10V9V7V6V5edittedecnoderpart
