OmarNeazyI/Sunnypro-automated-egg-frying-machine/cad/native/Bottom Heating Block Assembly.SLDASM

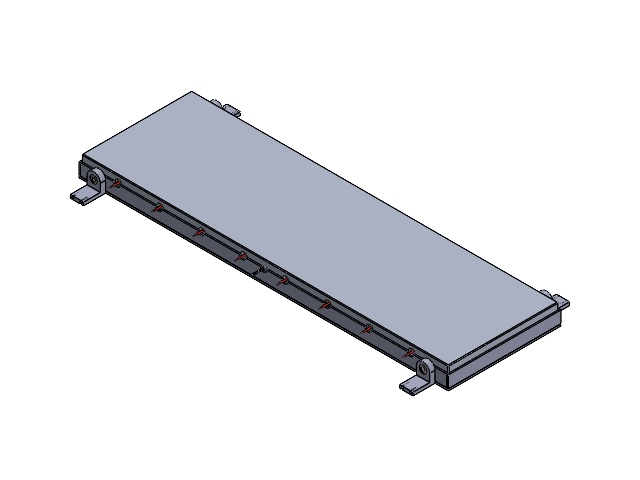
[picture p273: CAD file, 2026-11-10]
cad/native/Bottom Heating Block Assembly.SLDASM
Aluminum Heating Block
Cartridge Heaters x 8
PT100 Sensor
PT100 Sensor Wires
Steel Back Frame Heating Block x 2
Side Mounting Breacket Heating Block x 2
Bottom Frame Heating Block
Brackets for heating block x 4
socket head cap screw_iso x 4
