OmarNeazyI/Sunnypro-automated-egg-frying-machine/cad/native/Final Conveyor Assembly.SLDASM

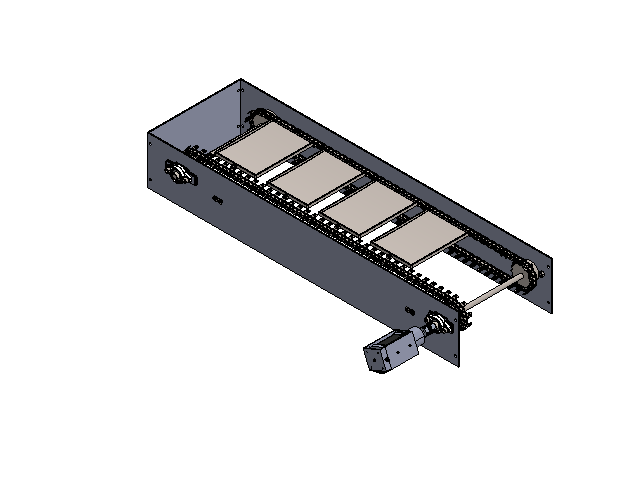
[picture p274: CAD file, 2026-11-10]
cad/native/Final Conveyor Assembly.SLDASM
Chainlink2with x 158
V10V9V7V6V510100001_01 x 158
V10V9V7V6V510100001_02 x 158
V10V9V7V6V510100001_03 x 316
18T Sprocket x 4
Drivingshaft
Idlersupportshaft
KFL000 bearing unit 10mm x 4
Conveyor Sideframe
Conveyor Back Frame
V10V9V7V6V5stepper_am17hdb410-02n_01
V10V9V7V6V5stepper_am17hdb410-02n_02
V10V9V7V6V5amt102-v_01
V10V9V7V6V5amt102-v_02
V10V9V7V6V5amt102-v_04
V10V9V7V6V5amt102-v_05
V10V9V7V6V5amt102-v_06
V10V9V7V6V5amt102-v_07
V10V9V7V6V5amt102-v_08
V10V9V7V6V5amt102-v_09
V10V9V7V6V5amt102-v_10
V10V9V7V6V5amt102-v_11
V10V9V7V6V5amt102-v_12
V10V9V7V6V5amt102-v_13
V10V9V7V6V5amt102-v_14
V10V9V7V6V5amt102-v_15
V10V9V7V6V5edittedecnoderpart
Planetary 1 to 27 Gearbox
V10V9V7V6V5Flexible Coupler Body
V10V9V7V6V5Set Screw M4x6mm x 4
Nema 17 Motor Casing
countersunk flat head cross recess screw_iso x 10
Egg Conveyor Plates x 4
socket head cap screw_iso x 10
torque nut 03_iso x 8
plain washer normal grade a_iso x 8
socket set screw cup point_iso
hex thin nut gradeb_iso
V10V9V7V6V5MirrorSideframe
