OmarNeazyI/Sunnypro-automated-egg-frying-machine/cad/native/Display Assembly.SLDASM

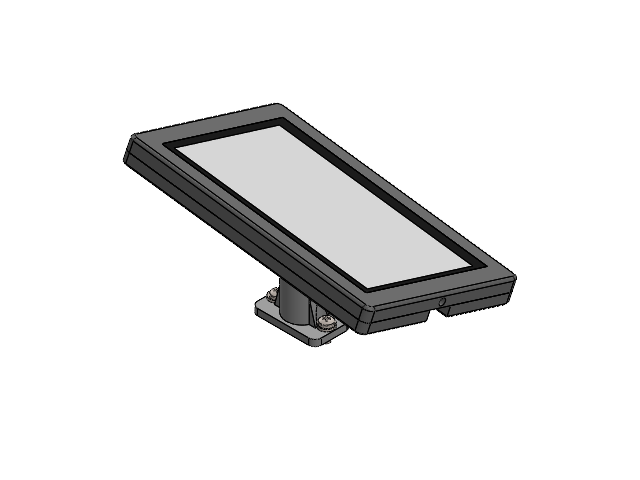
[picture p275: CAD file, 2026-11-10]
cad/native/Display Assembly.SLDASM
Nextion 7inch Display
Plastic Back Plate for Display
Plastic Top Plate for Display
pan head cross recess screw_iso x 8
hex thin nut gradeb_iso x 4
plain washer 10673 type snl_iso x 2
V10V9V7V6V5R19C2006A01_050_FS18-2V4
V10V9V7V6V5M6DIN985A2V4
V10V9V7V6V5X094180_SchnoorV4
V10V9V7V6V5X094372#X094372#Zylinderschraube_M6(L20)_(FKL8.8)(ISO4762)V4
V10V9V7V6V5R19C2006A01_200V4 x 2
V10V9V7V6V5R19C2006A01_110V4
V10V9V7V6V5X094567#X094567#Zylinderschraube_M3(L6)_(FKL8.8)(DIN7984)V4
