OmarNeazyI/Sunnypro-automated-egg-frying-machine/cad/native/Temperature Measurement PCB assemm.SLDASM

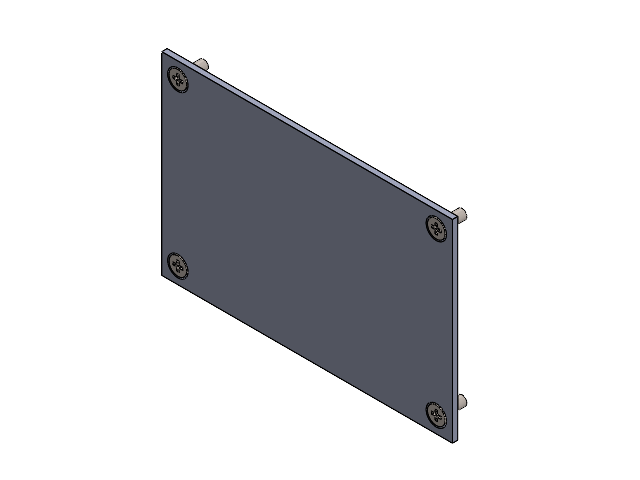
[picture p276: CAD file, 2026-11-10]
cad/native/Temperature Measurement PCB assemm.SLDASM
V10V9Temperature Measurement PCB
countersunk flat head cross recess screw_iso x 4
