OmarNeazyI/Sunnypro-automated-egg-frying-machine/(list of files, cad)

Other CAD files:
cad/native/V10V9V7V6V5main frame with assemV4.SLDASM
cad/native/Gate Assembly.SLDASM
cad/native/V10V9V7V6V5R19C2006A01_200V4.sldprt
cad/native/V10V9V7V6V5R19C2006A01_050_FS18-2V4.sldprt
cad/native/V10V9V7V6V5X094567#X094567#Zylinderschraube_M3(L6)_(FKL8.8)(DIN7984)V4.sldprt
cad/native/V10V9V7V6V5rr-215-60ur-ex375_04V4.SLDPRT
cad/native/Plastic Top Plate for Display.SLDPRT
cad/native/V10V9V7V6V5M6DIN985A2V4.sldprt
cad/native/V10V9V7V6V5R19C2006A01_110V4.sldprt
cad/native/Base of Spear.SLDPRT
cad/native/Bottom Frame Under Conveyor.SLDPRT
cad/native/Bottom Frame for Rotating Plate.SLDPRT
cad/native/Conveyor Sideframe.SLDPRT
cad/native/Flexible Shaft Coupler (RP).SLDPRT
cad/native/Load Cell Sensor.SLDPRT
cad/native/Meshing for TOP IR.SLDPRT
cad/native/Mount for Gate.SLDPRT
cad/native/Oil tank+Barbed Outlet.SLDPRT
cad/native/PT100 Sensor.SLDPRT
cad/native/Plastic Back Panel.SLDPRT
cad/native/Plastic Bottom Panel.SLDPRT
cad/native/Plastic Front Cover for Drawer.SLDPRT
cad/native/Plastic Gate.SLDPRT
cad/native/Quartz Insert of IR tube.SLDPRT
cad/native/Steel Back Frame Heating Block.SLDPRT
cad/native/Top sheet Metal (removable).SLDPRT
cad/native/V10V9Actuator + Sensor Interface PCB.SLDPRT
cad/native/V10V9Square Washer, Large.SLDPRT
cad/native/V10V9Square Washer, Small.SLDPRT
cad/native/V10V9Temperature Measurement PCB.SLDPRT
cad/native/V10V9V7V6Foot 50mm Dia x 20Deg Articulation.SLDPRT
cad/native/V10V9V7V6V5MirrorSideframe.SLDPRT
cad/native/V10V9V7V6V5Set Screw M4x6mm.SLDPRT
cad/native/V10V9V7V6V5SpringV4.SLDPRT
cad/native/V10V9V7V6V5X094180_SchnoorV4.sldprt
cad/native/V10V9V7V6V5X094372#X094372#Zylinderschraube_M6(L20)_(FKL8.8)(ISO4762)V4.sldprt
cad/native/V10V9V7V6V5amt102-v_01.SLDPRT
cad/native/V10V9V7V6V5amt102-v_02.SLDPRT
cad/native/V10V9V7V6V5amt102-v_04.SLDPRT
cad/native/V10V9V7V6V5amt102-v_05.SLDPRT
cad/native/V10V9V7V6V5amt102-v_06.SLDPRT
cad/native/V10V9V7V6V5amt102-v_07.SLDPRT
cad/native/V10V9V7V6V5amt102-v_08.SLDPRT
cad/native/V10V9V7V6V5amt102-v_09.SLDPRT
cad/native/V10V9V7V6V5amt102-v_10.SLDPRT
cad/native/V10V9V7V6V5amt102-v_11.SLDPRT
cad/native/V10V9V7V6V5amt102-v_12.SLDPRT
cad/native/V10V9V7V6V5amt102-v_13.SLDPRT
cad/native/V10V9V7V6V5amt102-v_14.SLDPRT
cad/native/V10V9V7V6V5stepper_am17hdb410-02n_01.SLDPRT
