OmarNeazyI/Sunnypro-automated-egg-frying-machine/docs/drawings/SunnyPro_Assembly_Drawing.pdf

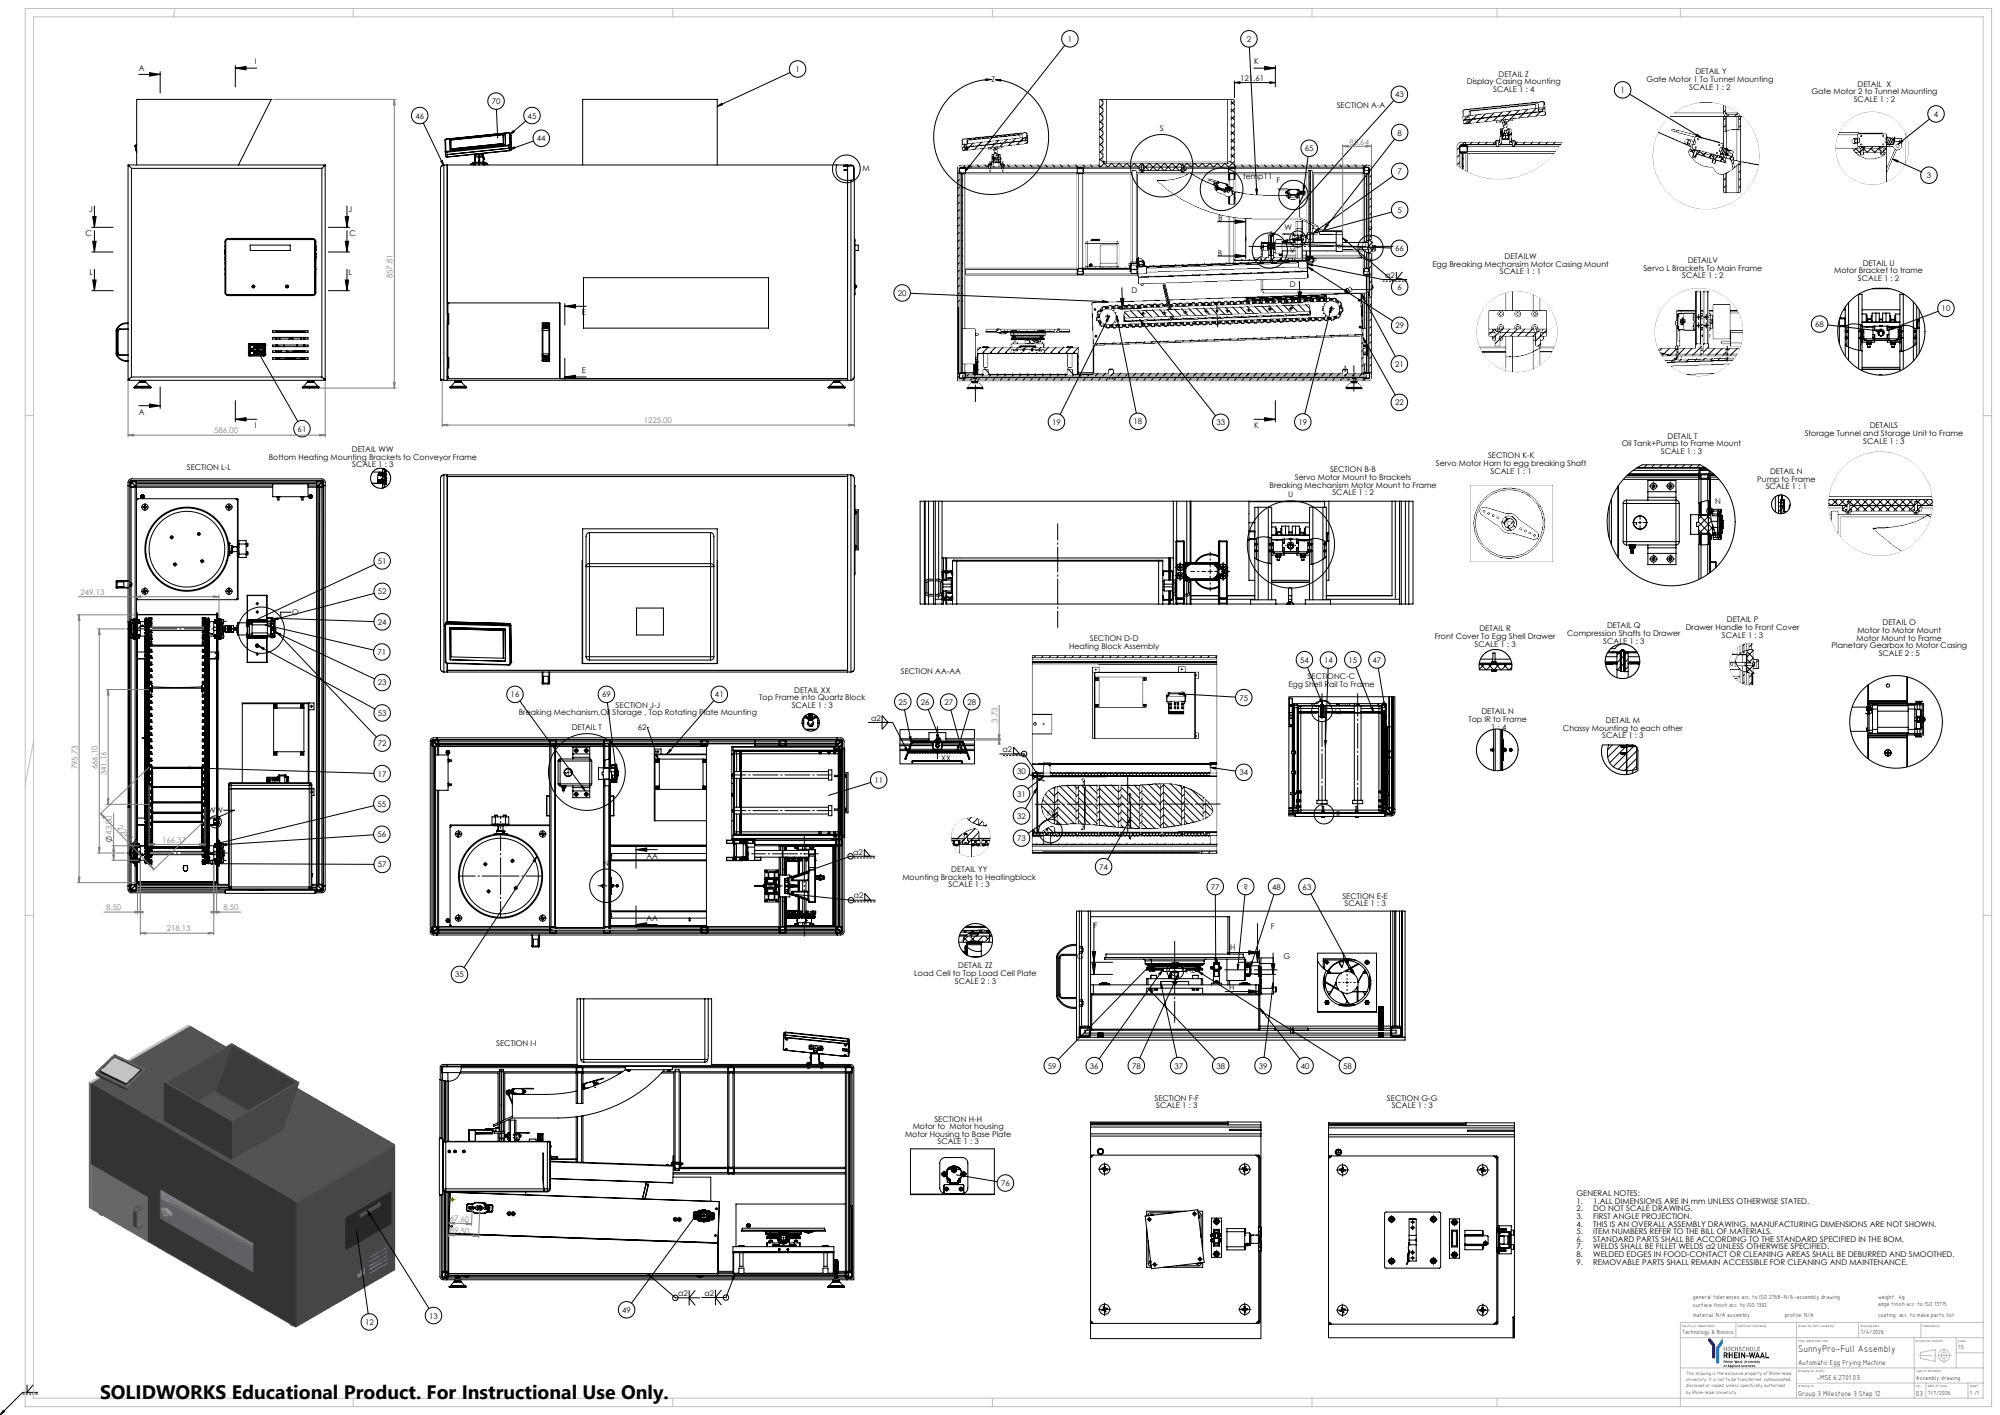
[picture p277: page 1]
temp11 F; SECTION A-A; DETAIL Y; DETAIL X SCALE 1 : 2; SCALE 1 : 1; SECTION B-B; SCALE 1 : 2; SECTION K-K SCALE 1 : 1; DETAIL T; SECTION J-J; DETAIL T SCALE 1 : 3; DETAIL R SCALE 1 : 3; DETAIL Q SCALE 1 : 3; DETAIL P SCALE 1 : 3; SCALE 1 : 3; DETAIL XX SCALE 1 : 3; SECTION L-L; SCALE 2 : 5; DETAIL WW SCALE 1 : 3; DETAIL YY SCALE 1 : 3; SECTION E-E SCALE 1 : 3; SECTION F-F SCALE 1 : 3; DETAIL ZZ SCALE 2 : 3; SECTION G-G SCALE 1 : 3; SECTION I-I; DETAIL M SCALE 1 : 3; N/A assembly; profile: N/A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

DETAIL Z
Display Casing Mounting
SCALE 1 : 4

Gate Motor 1 To Tunnel Mounting
SCALE 1 : 2 1

Gate Motor 2 to Tunnel Mounting

Egg Breaking Mechansim Motor Casing Mount

DETAIL U
Motor Bracket to trame
SCALE 1 : 2

Servo L Brackets To Main Frame

Storage Tunnel and Storage Unit to Frame

Oil Tank+Pump to Frame Mount

Bottom Heating Mounting Brackets to Conveyor Frame

Servo Motor Horn to egg breaking Shaft

DETAIL N
Pump to Frame
SCALE 1 : 1

Servo Motor Mount to Brackets
Breaking Mechanism Motor Mount to Frame

DETAIL O
Motor to Motor Mount
Motor Mount to Frame
Planetary Gearbox to Motor Casing

Drawer Handle to Front Cover

Compression Shafts to Drawer

SECTION D-D
Heating Block Assembly

Front Cover To Egg Shell Drawer

SECTIONC-C
Egg Shell Rail To Frame

SECTION AA-AA

Breaking Mechanism,Oil Storage , Top Rotating Plate Mounting

Top Frame into Quartz Block

Top IR to Frame

Chassy Mounting to each other

Mounting Brackets to Heatingblock

Load Cell to Top Load Cell Plate

SECTION H-H
Motor to Motor housing
Motor Housing to Base Plate

GENERAL NOTES:
1. 1.ALL DIMENSIONS ARE IN mm UNLESS OTHERWISE STATED.
2. DO NOT SCALE DRAWING.
3. FIRST ANGLE PROJECTION.
4. THIS IS AN OVERALL ASSEMBLY DRAWING. MANUFACTURING DIMENSIONS ARE NOT SHOWN.
5. ITEM NUMBERS REFER TO THE BILL OF MATERIALS.
6. STANDARD PARTS SHALL BE ACCORDING TO THE STANDARD SPECIFIED IN THE BOM.
7. WELDS SHALL BE FILLET WELDS a2 UNLESS OTHERWISE SPECIFIED.
8. WELDED EDGES IN FOOD-CONTACT OR CLEANING AREAS SHALL BE DEBURRED AND SMOOTHED.
9. REMOVABLE PARTS SHALL REMAIN ACCESSIBLE FOR CLEANING AND MAINTENANCE.

general tolerances acc. to ISO 2768-
surface finish acc. to ISO 1302
material:

weight: kg
edge finish acc. to ISO 13715

faculty or department
Technology & Bionics

SunnyPro-Full Assembly
Automatic Egg Frying Machine
-MSE.6.2701.03

title, additional title

SOLIDWORKS Educational Product. For Instructional Use Only.

This drawing is the exclusive property of Rhine-Waal
University. It is not to be transferred, communicated,
disclosed or copied, unless specifically authorized
by Rhine-Waal University.
