OmarNeazyI/Sunnypro-automated-egg-frying-machine/docs/risk/SunnyPro_Team_DFMEA.pdf

Group 3 | HSRW Group Project T&B | SS 2026

## 6. D-FMEA

### 6.1 Definition

Design failure mode and effect analysis (DFMEA) is a structured method that helps engineers understand the impact of potential risks associated with a design.

18
It helps
determine how possible design failures may affect performance, safety and reliability.

The FMEA process considers three main factors:

1. Severity (S) – The potential impact of a failure on the system or user.
2. Occurrence (O) – The likelihood of the failure occurring.
3. Detection (D) – Assess how easy or difficult it is to detect the failure before it affects the system.

The Risk Priority Number (RPN) is calculated using the following formula:

RPN = Severity * Occurrence * Detection

A higher RPN indicates a higher level of risk, requiring immediate attention and appropriate corrective action.

RPN alone is not always enough, because it treats Severity, Occurrence, and Detection equally. In D-FMEA, some failures should receive attention mainly because their effect is severe, even if the RPN is not the highest. Action Priority (AP) helps show which failure modes need action first by considering Severity first, then Occurrence, then Detection.¹⁹

19 Quality-One International. AIAG & VDA FMEA Handbook and Guide. Quality-One International. (https://quality-one.com/aiag-vda-fmea/?utm_source=chatgpt.com) Accessed May 12, 2026.

18 Ansys. What is DFMEA? Ansys Blog. Published February 7, 2024. Accessed May 12, 2026. https://www.ansys.com/blog/what-is-dfmea

96

Group 3 | HSRW Group Project T&B | SS 2026

### 6.2 D-FMEA Rating Scheme


Table 19 : Severity Scale for Failure Modes and Effects.

97

Group 3 | HSRW Group Project T&B | SS 2026


Table 20 : Occurrence Scale.

98

Group 3 | HSRW Group Project T&B | SS 2026


Table 21 : Detection Scale.

99

Group 3 | HSRW Group Project T&B | SS 2026


Table 22: Action Priority Scale.

100

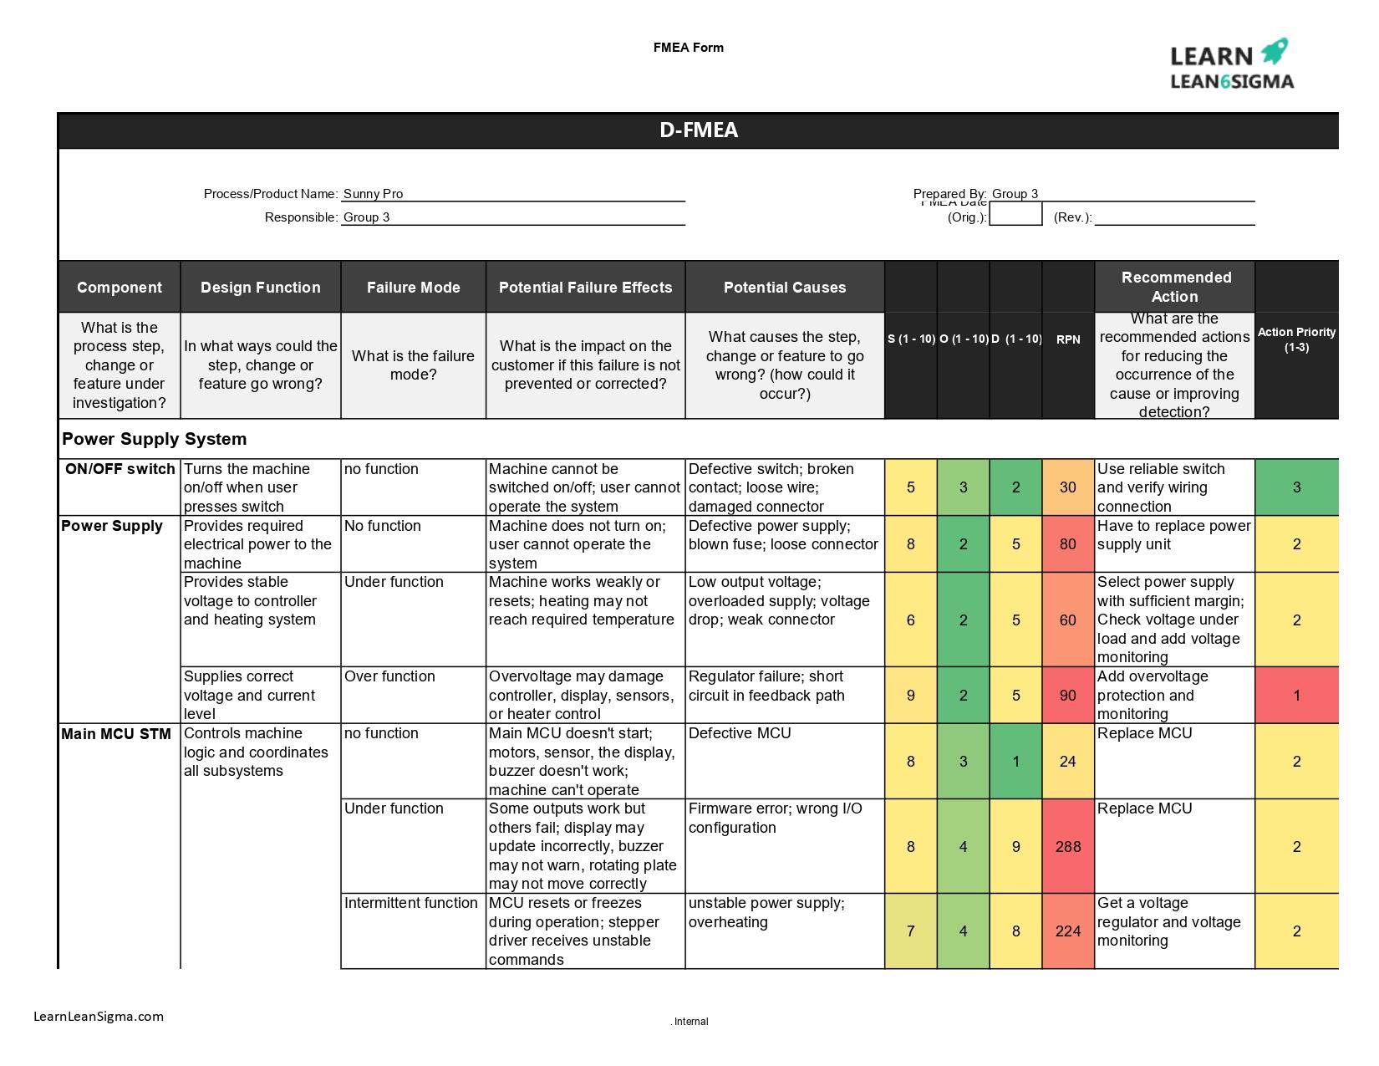
[picture p278: page 6]

Group 3 | HSRW Group Project T&B | SS 2026

101

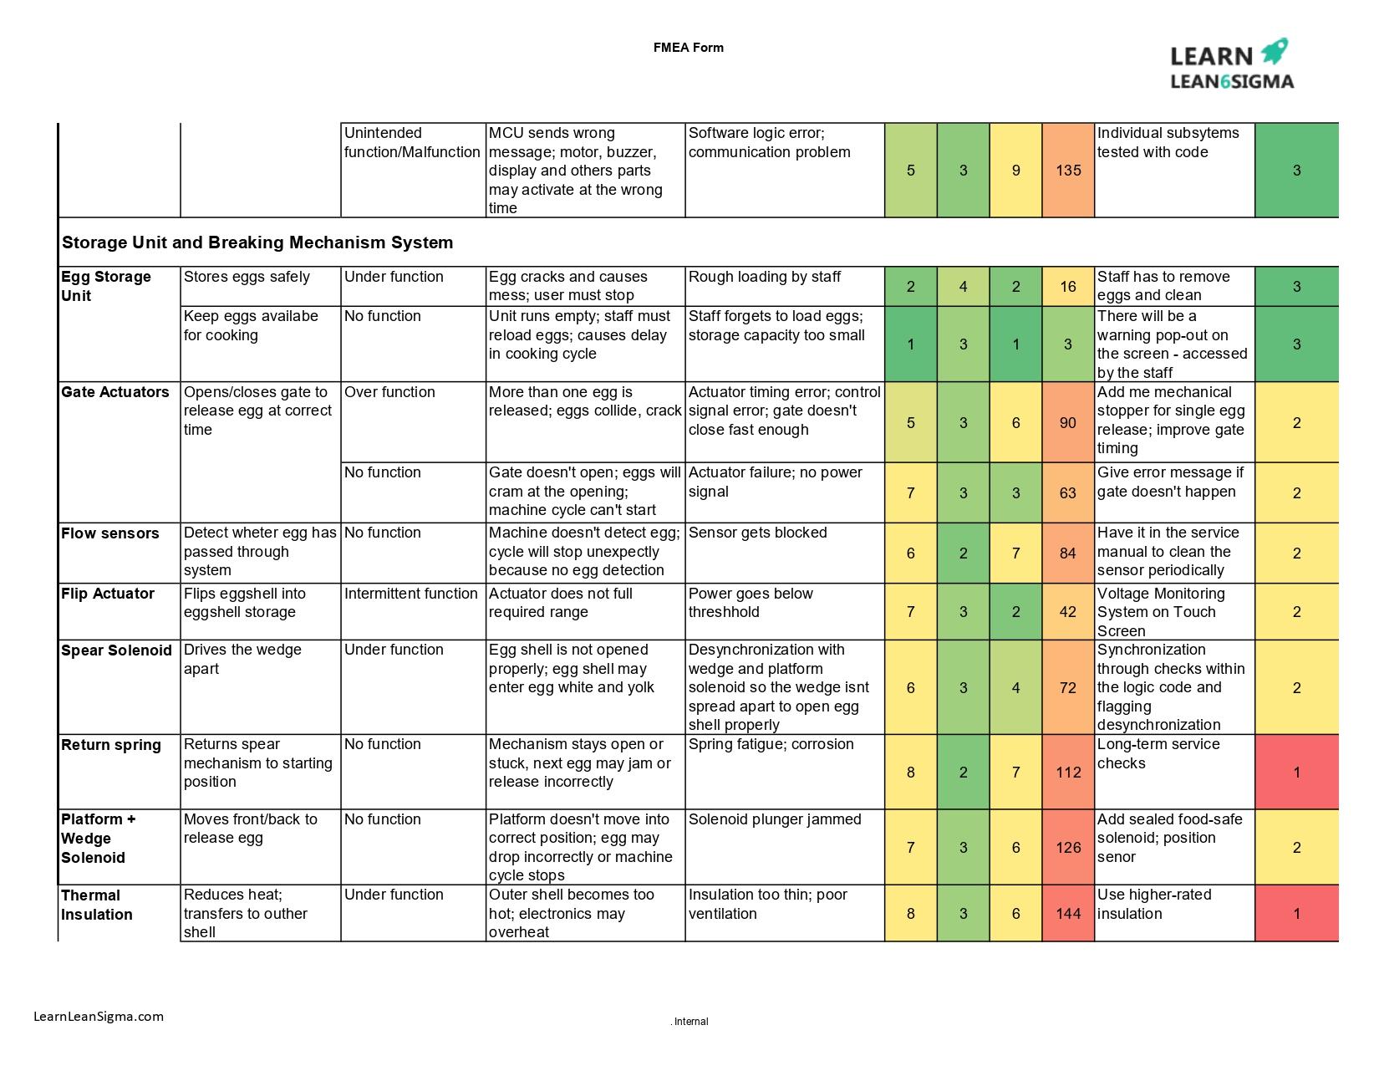
[picture p279: page 7]

Group 3 | HSRW Group Project T&B | SS 2026

102

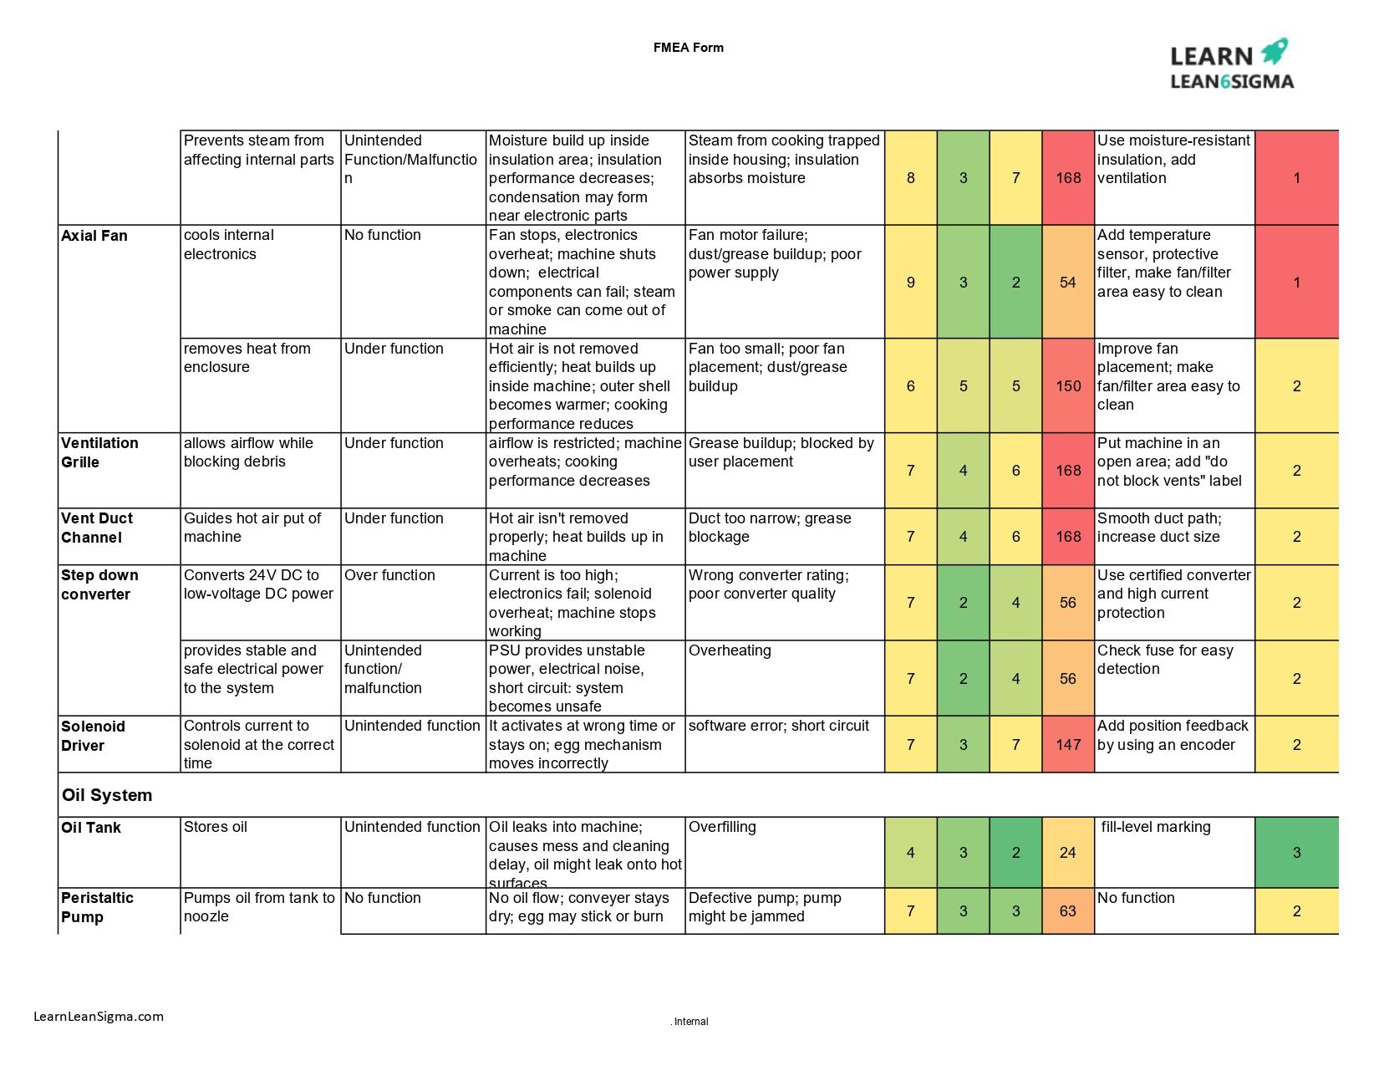
[picture p280: page 8]

Group 3 | HSRW Group Project T&B | SS 2026

103

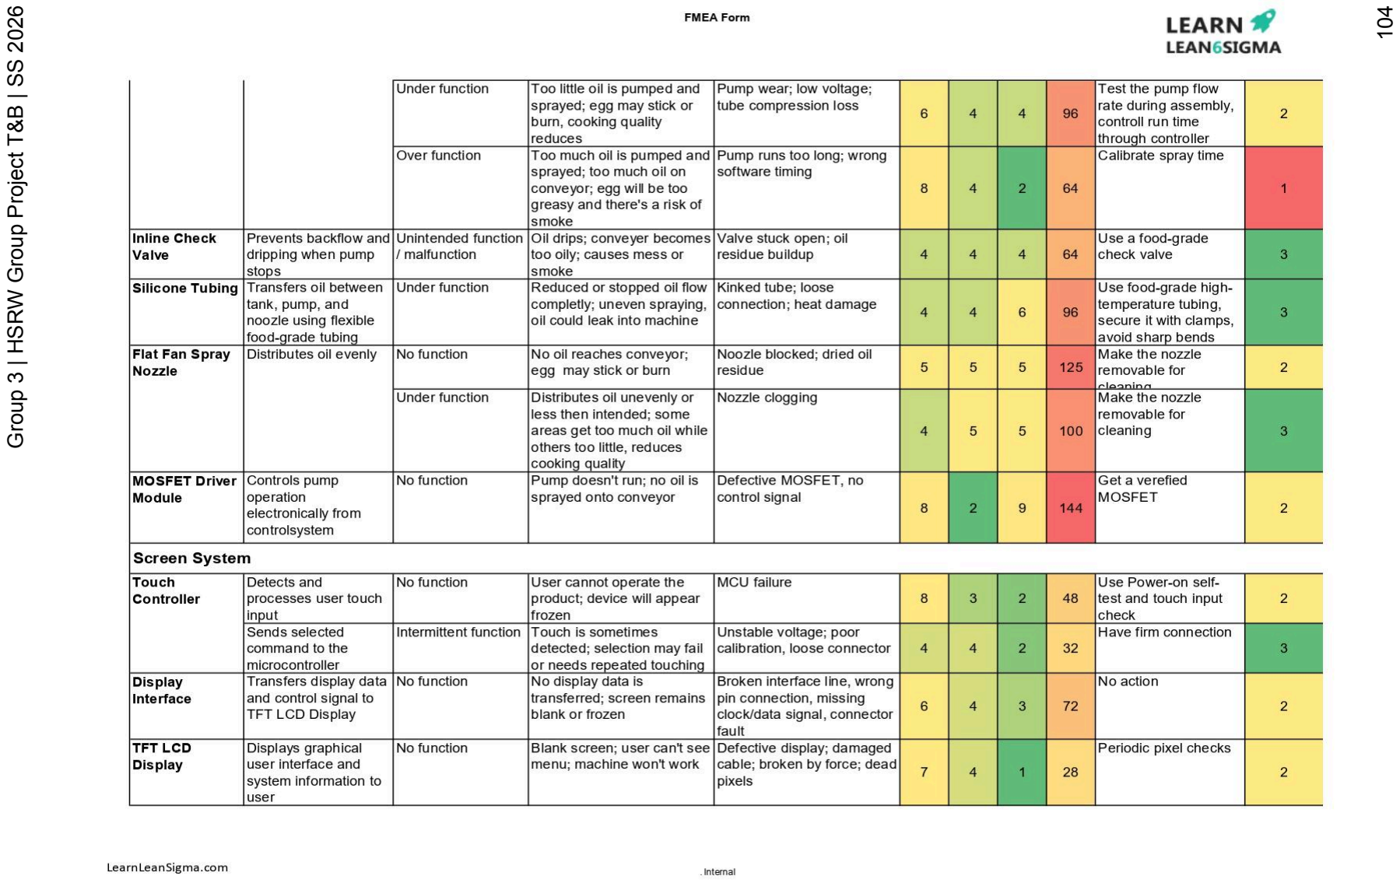
[picture p281: page 9]

Group 3 | HSRW Group Project T&B | SS 2026

104

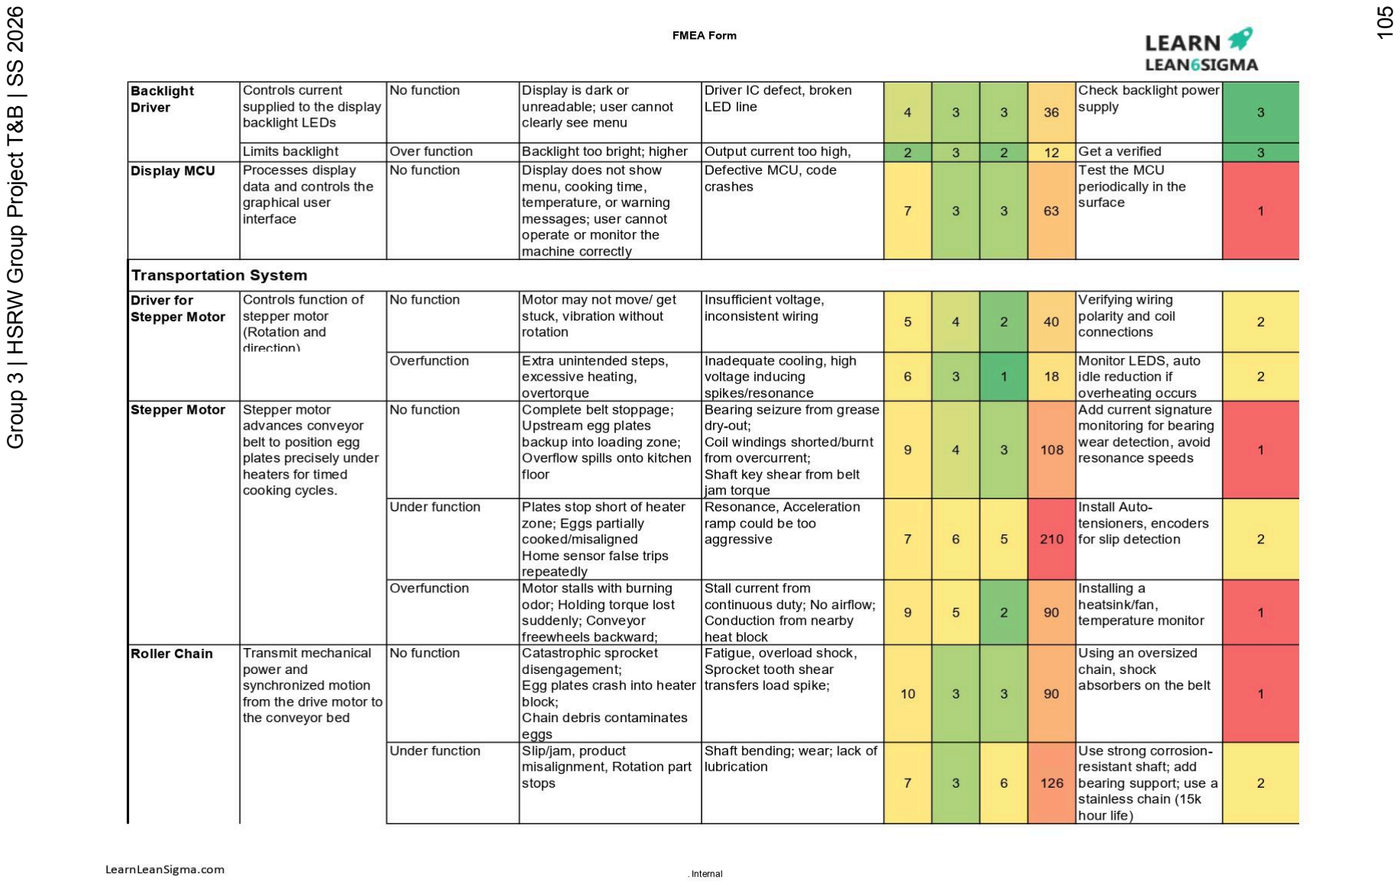
[picture p282: page 10]

Group 3 | HSRW Group Project T&B | SS 2026

105

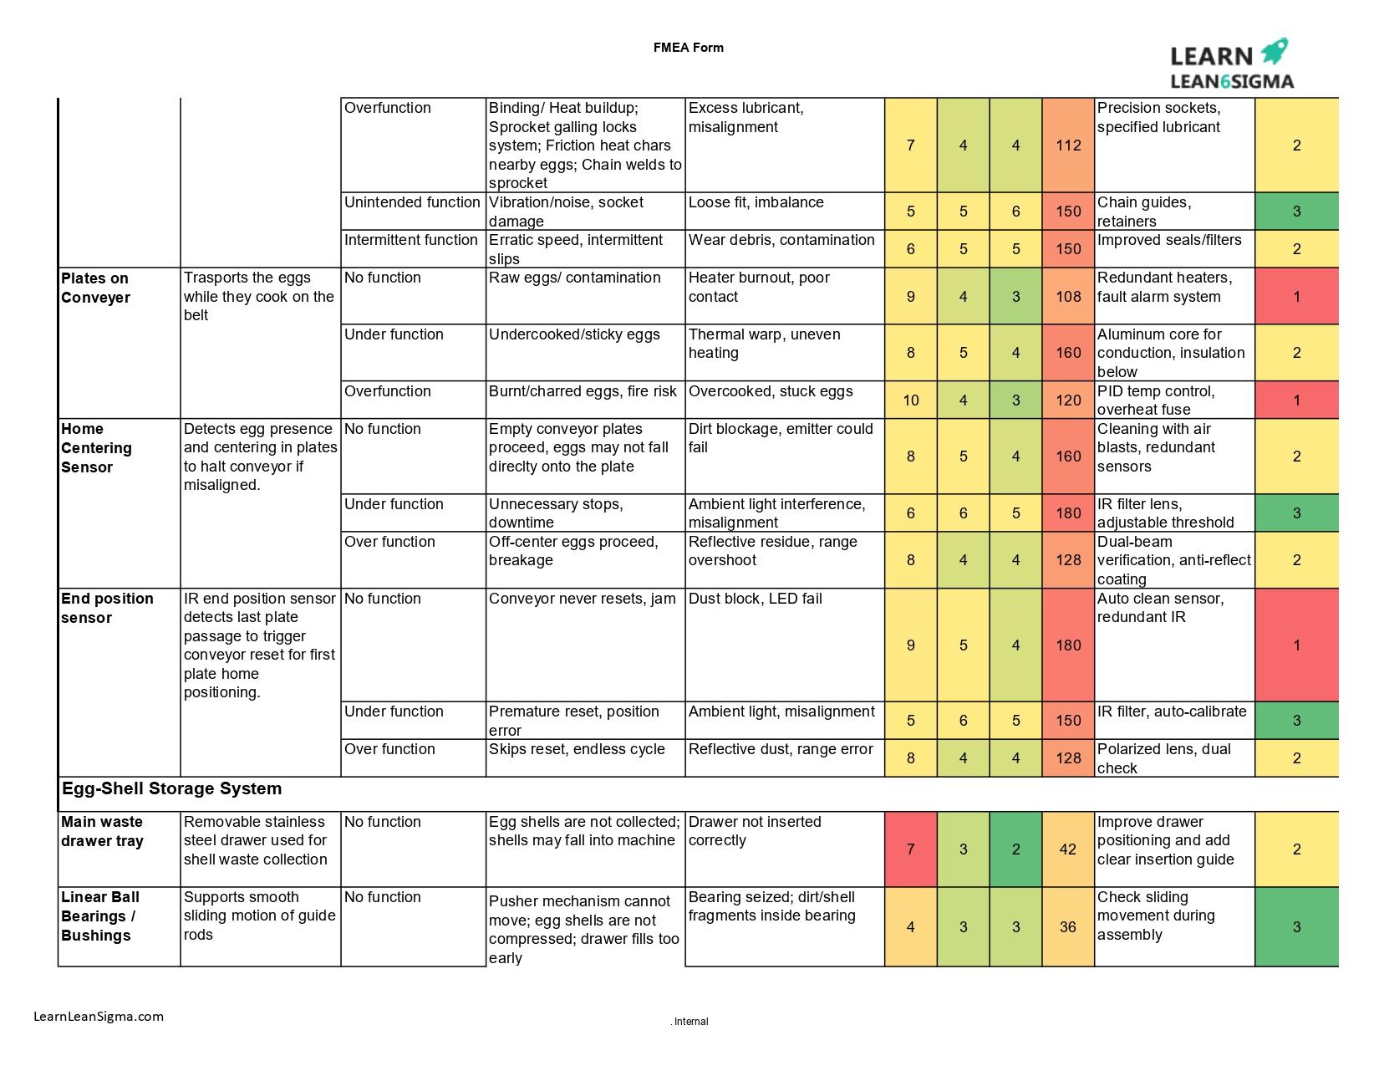
[picture p283: page 11]

Group 3 | HSRW Group Project T&B | SS 2026

106

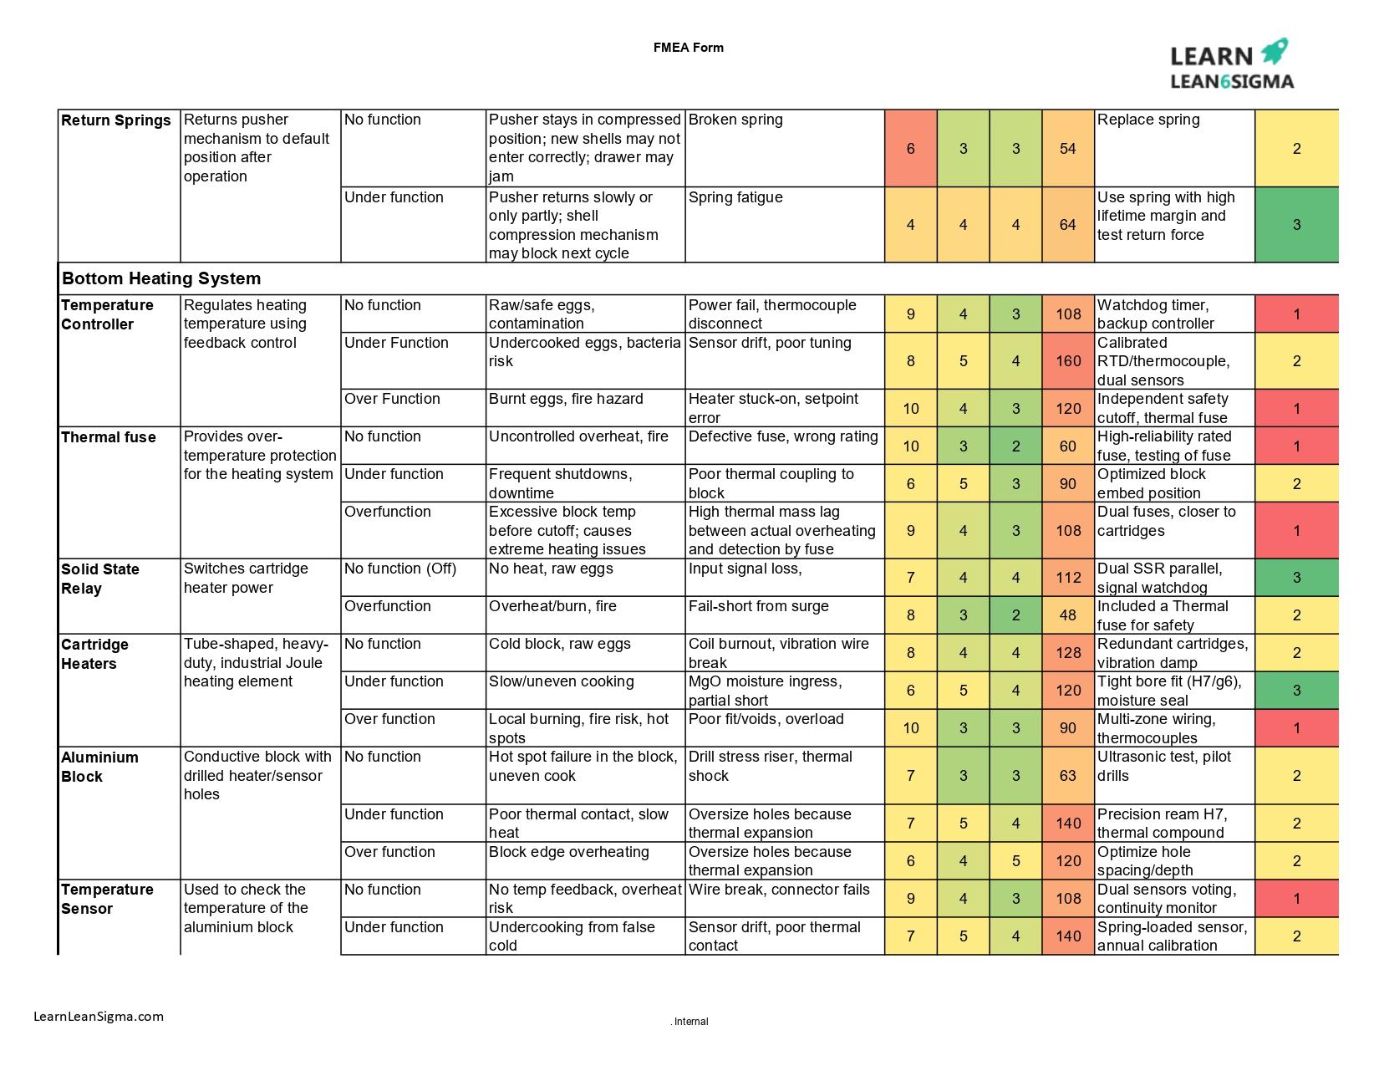
[picture p284: page 12]

Group 3 | HSRW Group Project T&B | SS 2026

107

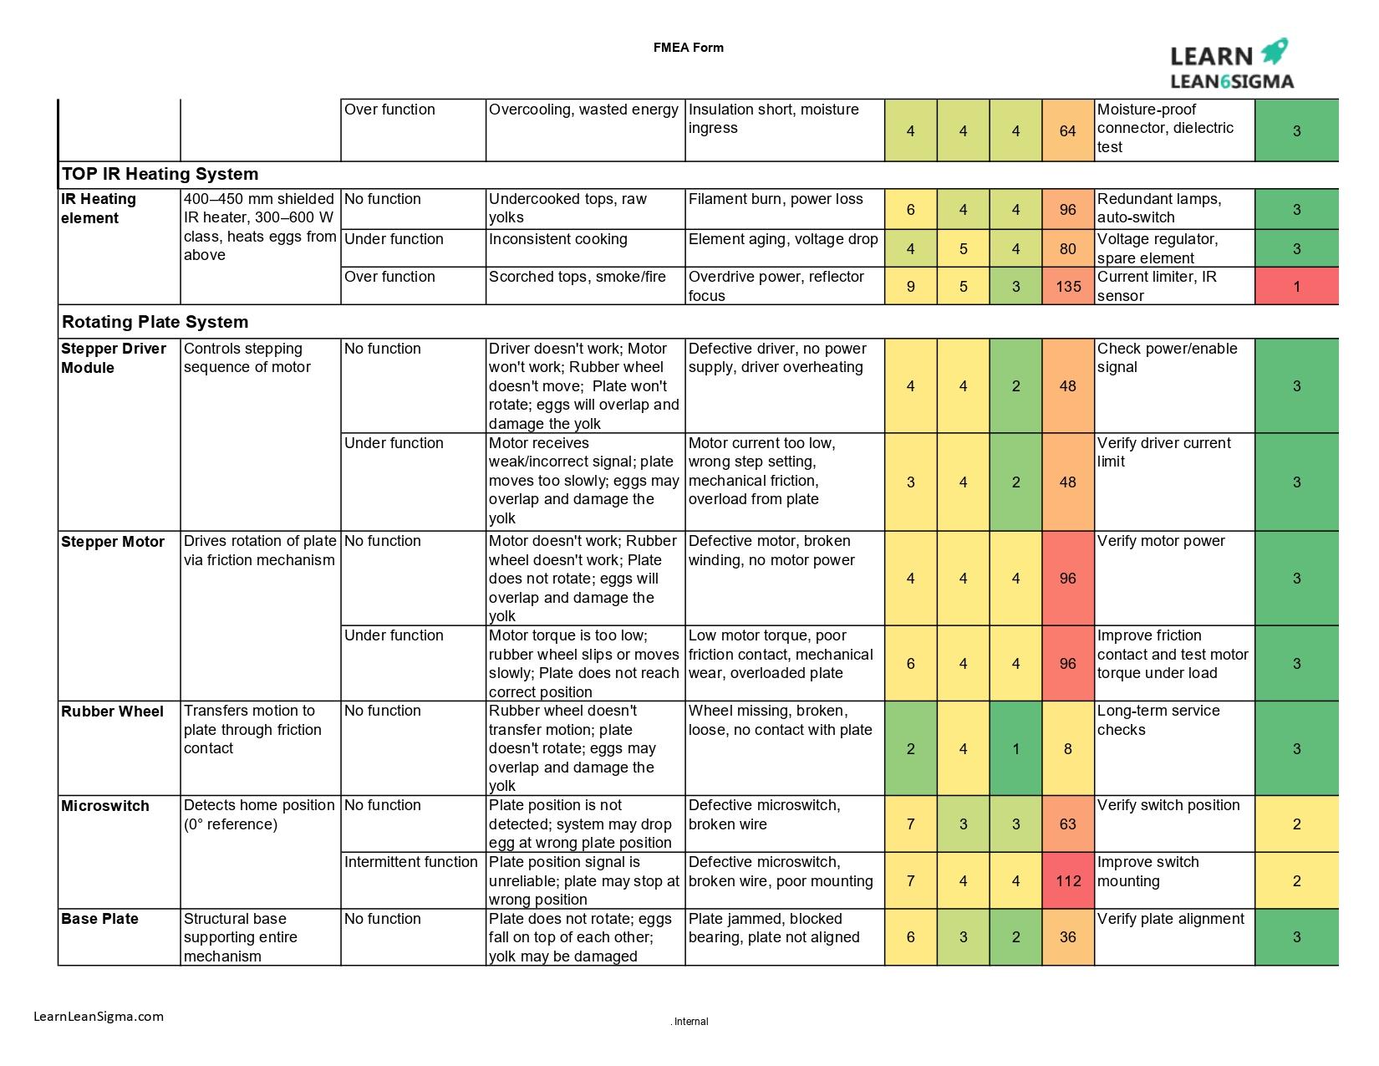
[picture p285: page 13]

Group 3 | HSRW Group Project T&B | SS 2026

108
