OmarNeazyI/Sunnypro-automated-egg-frying-machine/docs/drawings/SunnyPro_Assembly_Drawing_BOM.pdf

Egg Storage Container PP-C HI / Polypropylene Copolymer; Yield: ~22 MPa | Density: 0.90 g/cm³ | Temp: -20 to 100°C; Egg Tunnel; PP-C HI / Polypropylene Copolymer; Gates for Transportation; Tunnel; Acetal Copolymer (POM-C); Yield: ~62 MPa | Density: 1.41 g/cm³ | Temp: -40 to 100°C; Gate Shaft Holder for Tunnel POM-C / Acetal Copolymer; Egg Tunnel Shaft EN 1.4301 / AISI 304; Yield: ~215 MPa | Density: 7.90 g/cm³ | Temp: -200 to 400°C; Egg Holding Shaft EN AW-6082 T6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

33 Front Frame (Bottom
Mounting Brackets
39 Base Plate (Rotating

for Bottom Heating
Block

EN AC-43500 / AlSi10MnMg (cast, clear

faculty or department
Technology & Bionics

title, additional title

This drawing is the exclusive property of Rhine-Waal
University. It is not to be transferred, communicated,
disclosed or copied, unless specifically authorized
by Rhine-Waal University.
SOLIDWORKS Educational Product. For Instructional Use Only.

bill of material

Bottom Base for Rotating; Plate; EN 1.4301 / AISI 304; Yield: ~215 MPa | Density: 7.90 g/cm³ | Temp: -200; Electrical Box Housing EN 1.4301 / AISI 304; Main Frame Housing; L Bracket for Servo Motor EN 1.4301 / AISI 304; Plastic Back Plate (Display) ABS-HI plastic w/; brass inserts; Yield: ~40 MPa | Density: 1.05 g/cm³ | Temp: -20 to; Front Frame for Casing; (Display); ABS-HI plastic; Main Case/Chassy Panels ABS-HI plastic +; purchased glass; DIN Rail; zinc-plated steel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

20Paar 5.08mm Pitch Male Buchse PCB Screw
EBM Papst 8414NGML Axiallüfter 24 V/DC 42 m³/h
(L x B x H) 80 x 80 x 25mm | » Freue dich auf
voelkner

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

69 Touchscreen Display Module -
Nextion NX8048P070_011R

NEXTION 4.3/5.0/7.0'' Intelligent LCD Touch

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

faculty or department
Technology & Bionics

title, additional title

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

bill of material
